anonymouslojz/EM-TF-SOM-AM5728/04-Connector/Dimension/SOM Dimension.dxf

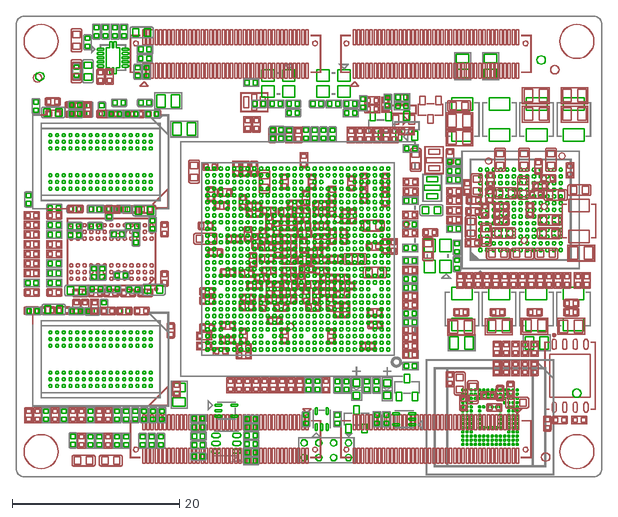
[picture p10: CAD file, 2024-05-24]
04-Connector/Dimension/SOM Dimension.dxf
70.0 x 55.0
