anonymouslojz/EM-TF-SOM-AM5728/(list of files, cad)

Other CAD files:
04-Connector/AM5728 BB.dxf
