anonymouslojz/EM-TF-SOM-AM5728/04-Connector/Dimension/SOM Dimension.pdf

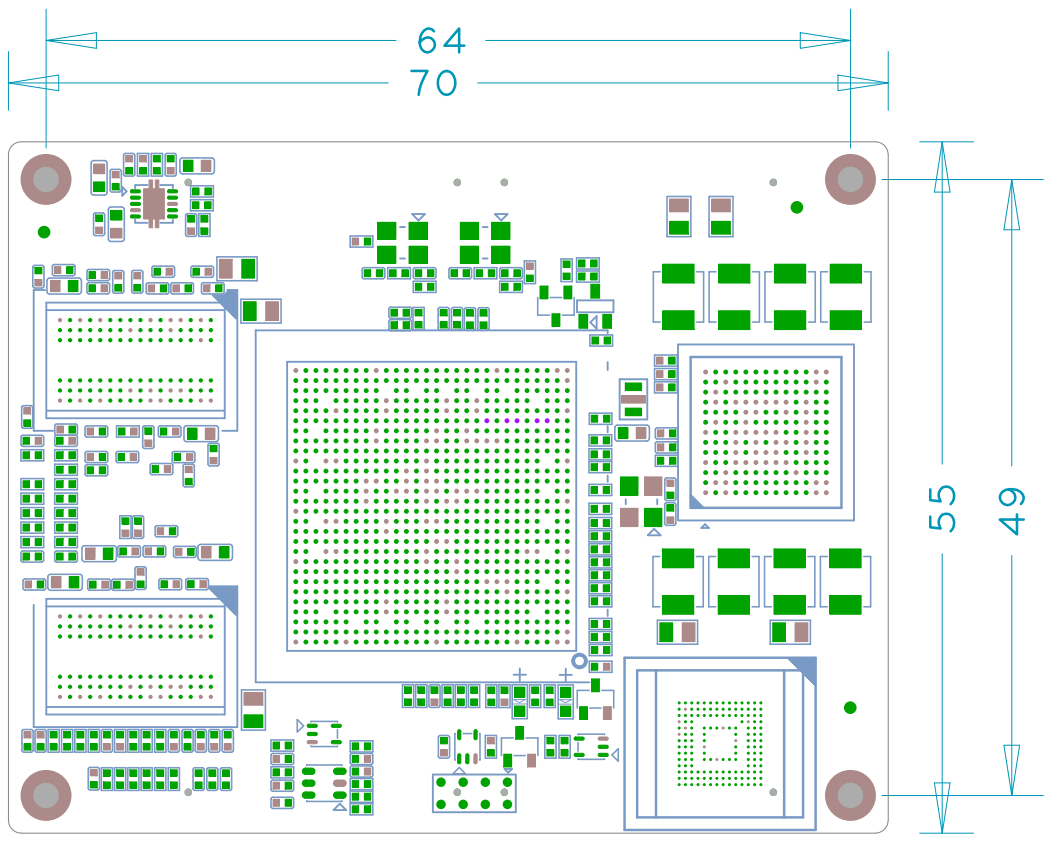
[picture p98: page 1]
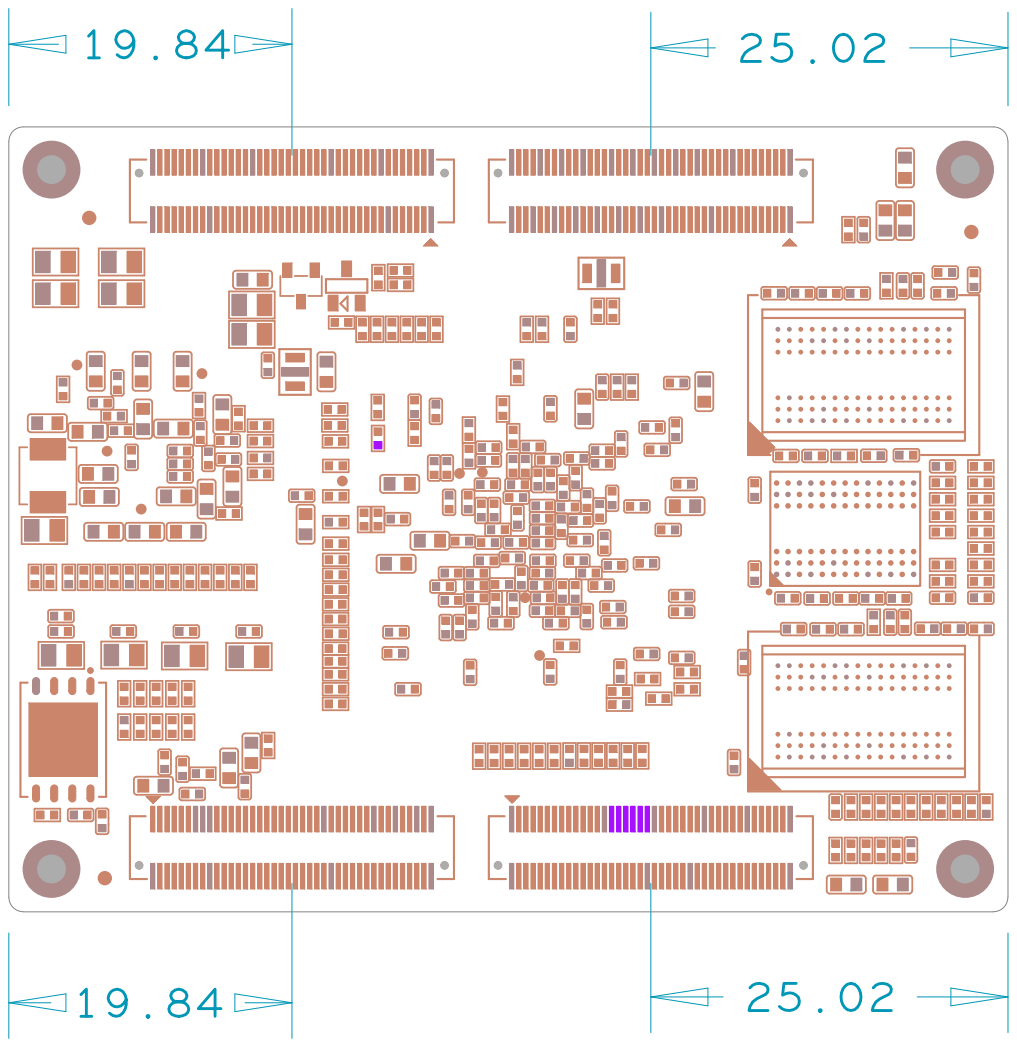
[picture p99: page 2]
