anonymouslojz/EM-TF-SOM-AM5728/03-Schematic/EM-TF-BB-AM5728_V11.pdf

# EM-TF-BB-AM5728_V1.1

# Revision History

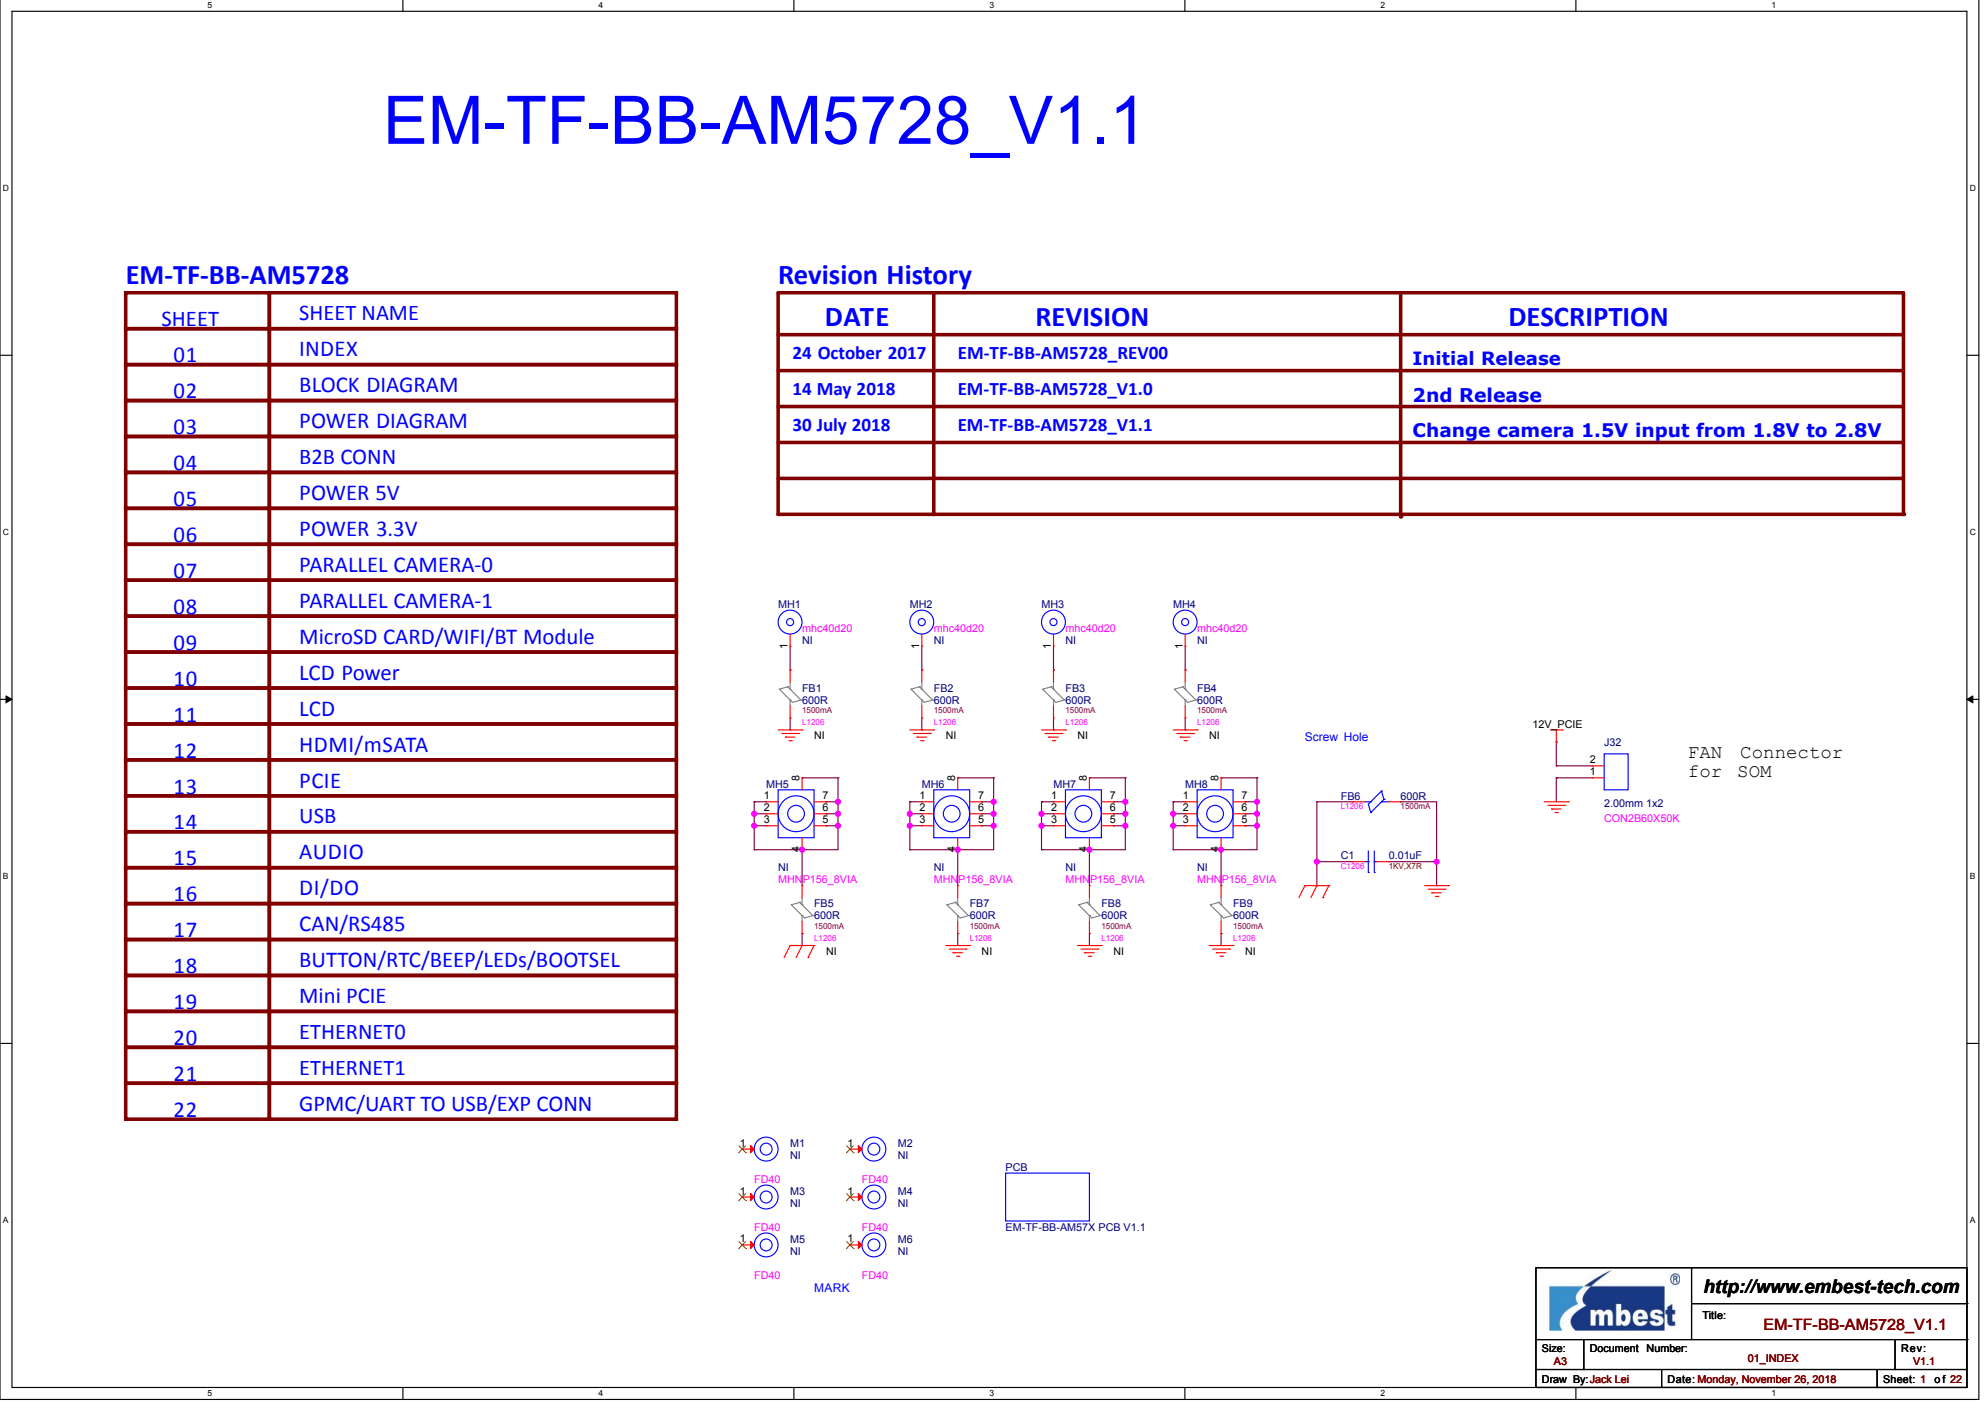
[picture p60: page 1]

DATE | REVISION | DESCRIPTION

24 October 2017 | EM-TF-BB-AM5728_REV00 | Initial Release
14 May 2018 | EM-TF-BB-AM5728_V1.0 | 2nd Release

30 July 2018 | EM-TF-BB-AM5728_V1.1 | Change camera 1.5V input from 1.8V to 2.8V

EM-TF-BB-AM57X PCB V1.1

http://www.embest-tech.com

# E M - T F -B B -A M 5 7 2 8 _ V 1 .0

# M M C 1

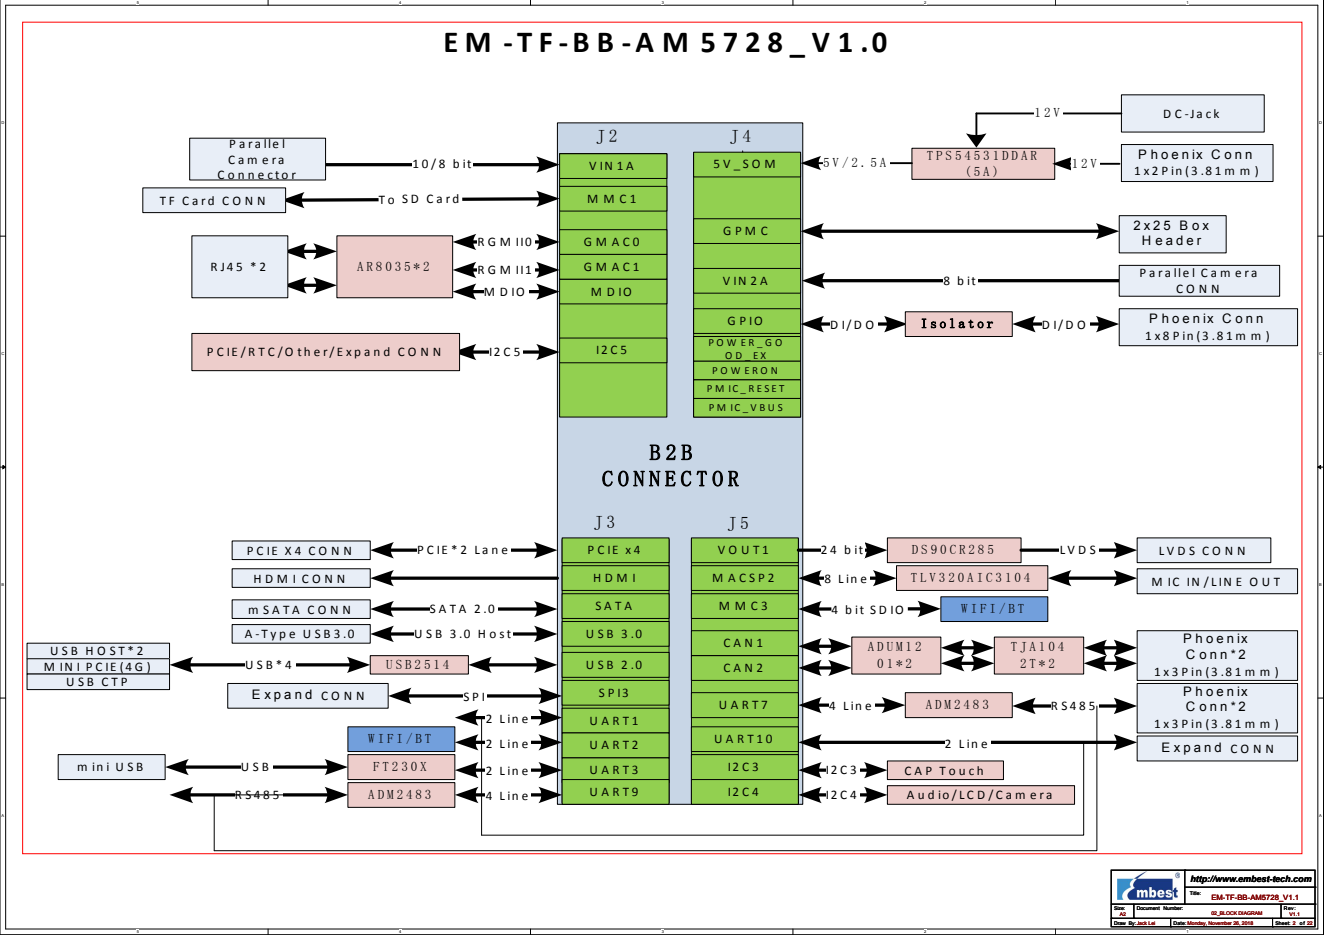
[picture p61: page 2]
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

http://www.embest-tech.com

# EM-TF-BB-AM5728_REV00

# 5V_SOM DCDC(TPS54531)

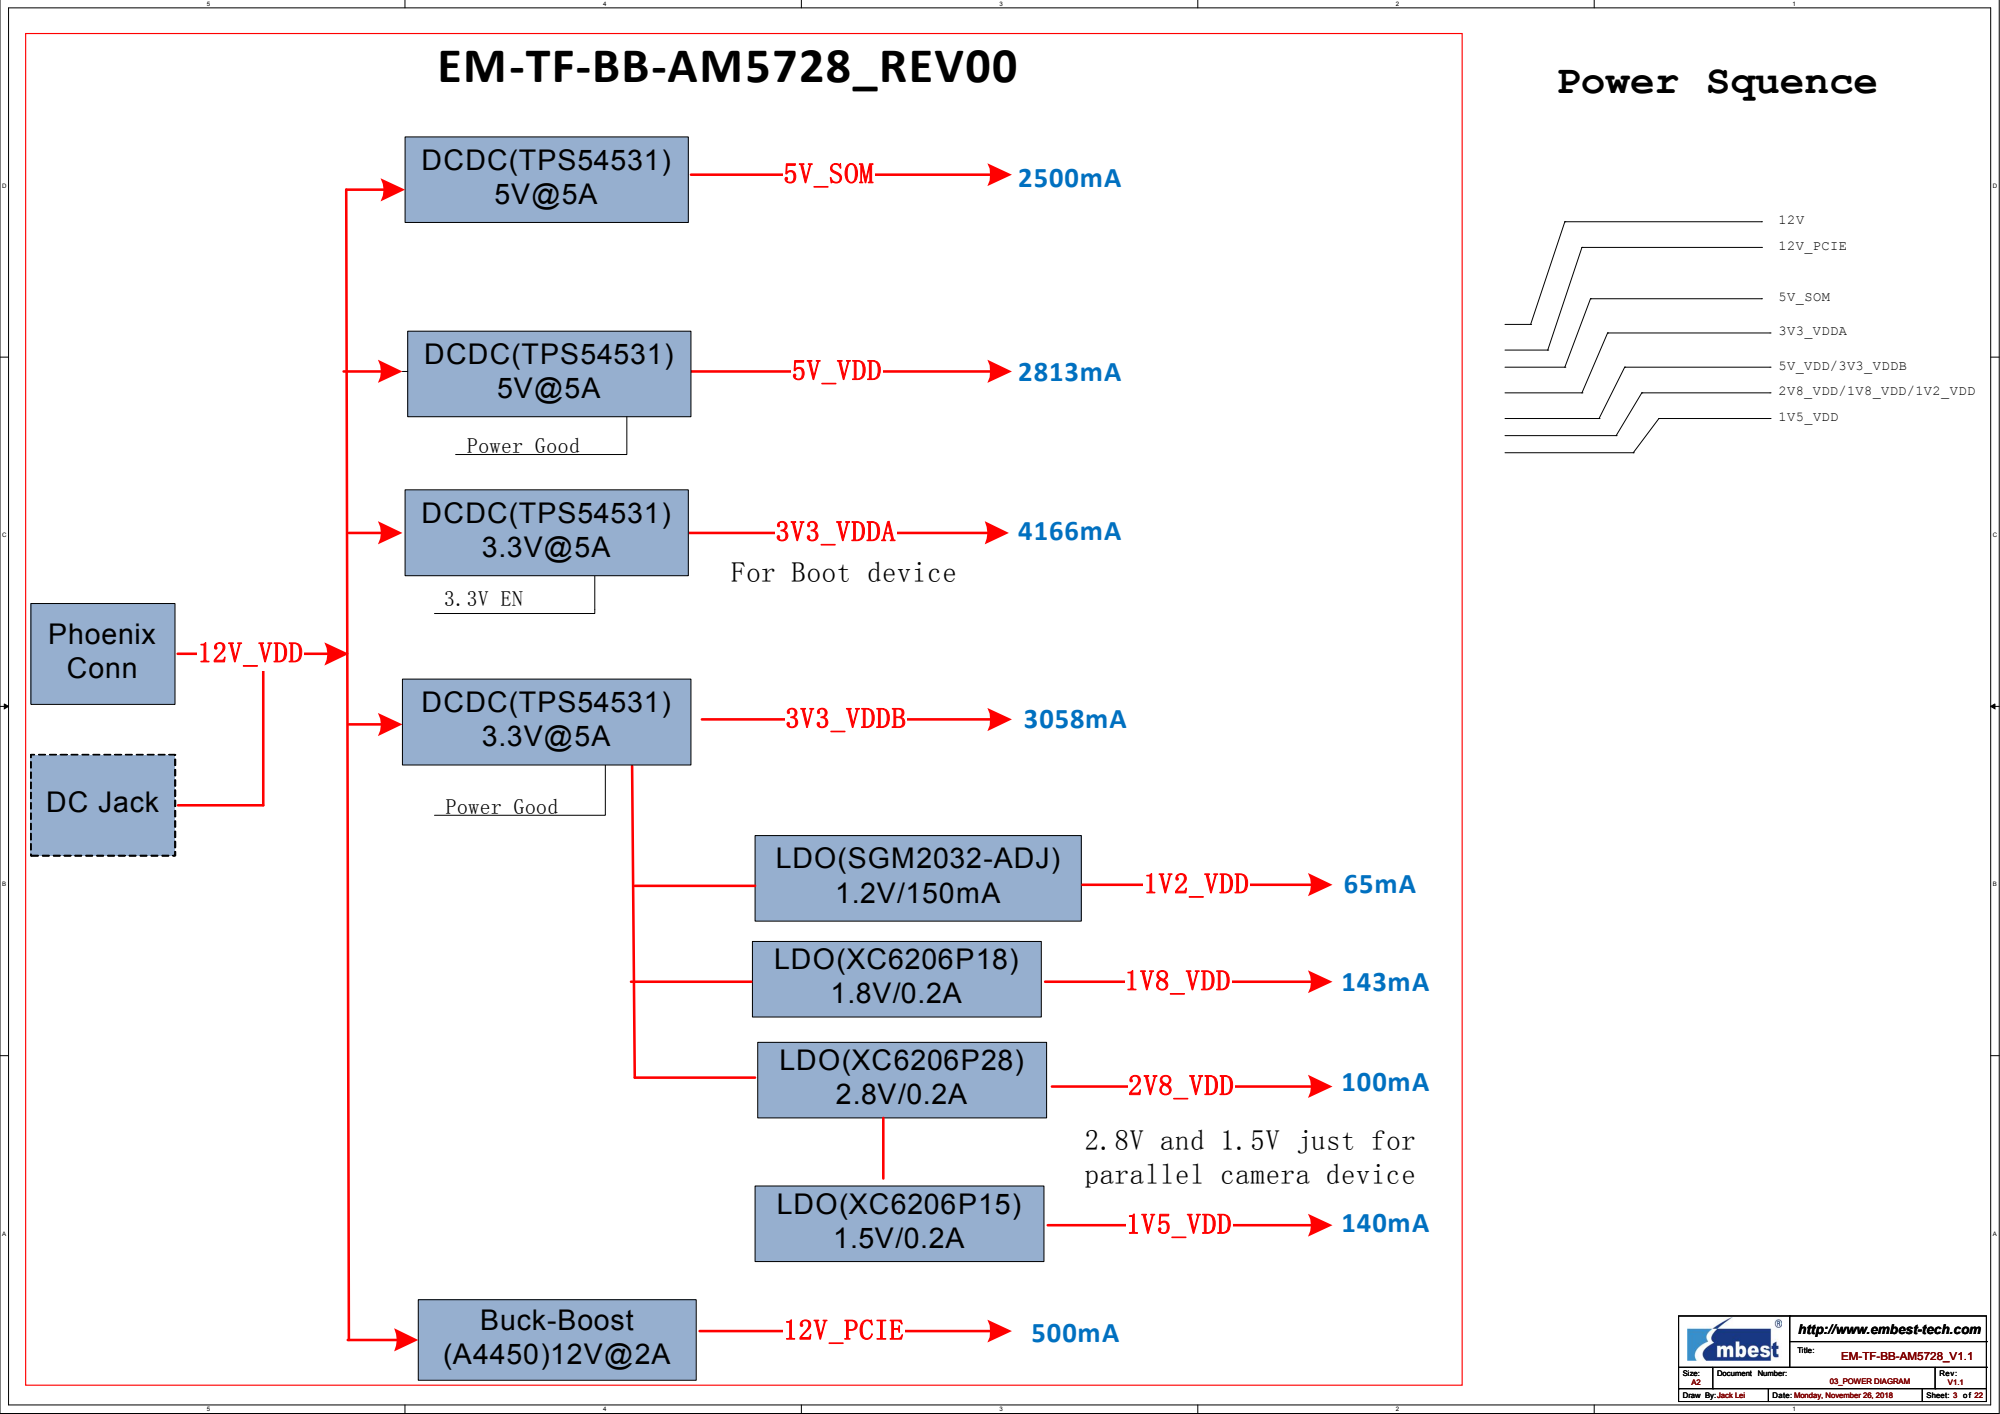
[picture p62: page 3]
Phoenix Conn; LDO(SGM2032-ADJ) 1.2V/150mA; 12V_PCIE; DC Jack; LDO(XC6206P15) 1.5V/0.2A; Power Good; 3V3_VDDB; Buck-Boost (A4450)12V@2A; DCDC(TPS54531) 3.3V@5A; LDO(XC6206P18) 1.8V/0.2A; 5V_VDD DCDC(TPS54531) 5V@5A; 12V_VDD; 1V2_VDD; LDO(XC6206P28) 2.8V/0.2A; 1V8_VDD; 2V8_VDD; Power Squence; 5V_SOM; 3V3_VDDA; 5V_VDD/3V3_VDDB; 2V8_VDD/1V8_VDD/1V2_VDD; 1V5_VDD; 03_POWER DIAGRAM; Jack Lei; Monday, November 26, 2018

3V3_VDDA
For Boot device

2.8V and 1.5V just for
parallel camera device
1V5_VDD

http://www.embest-tech.com

# B2B CONN

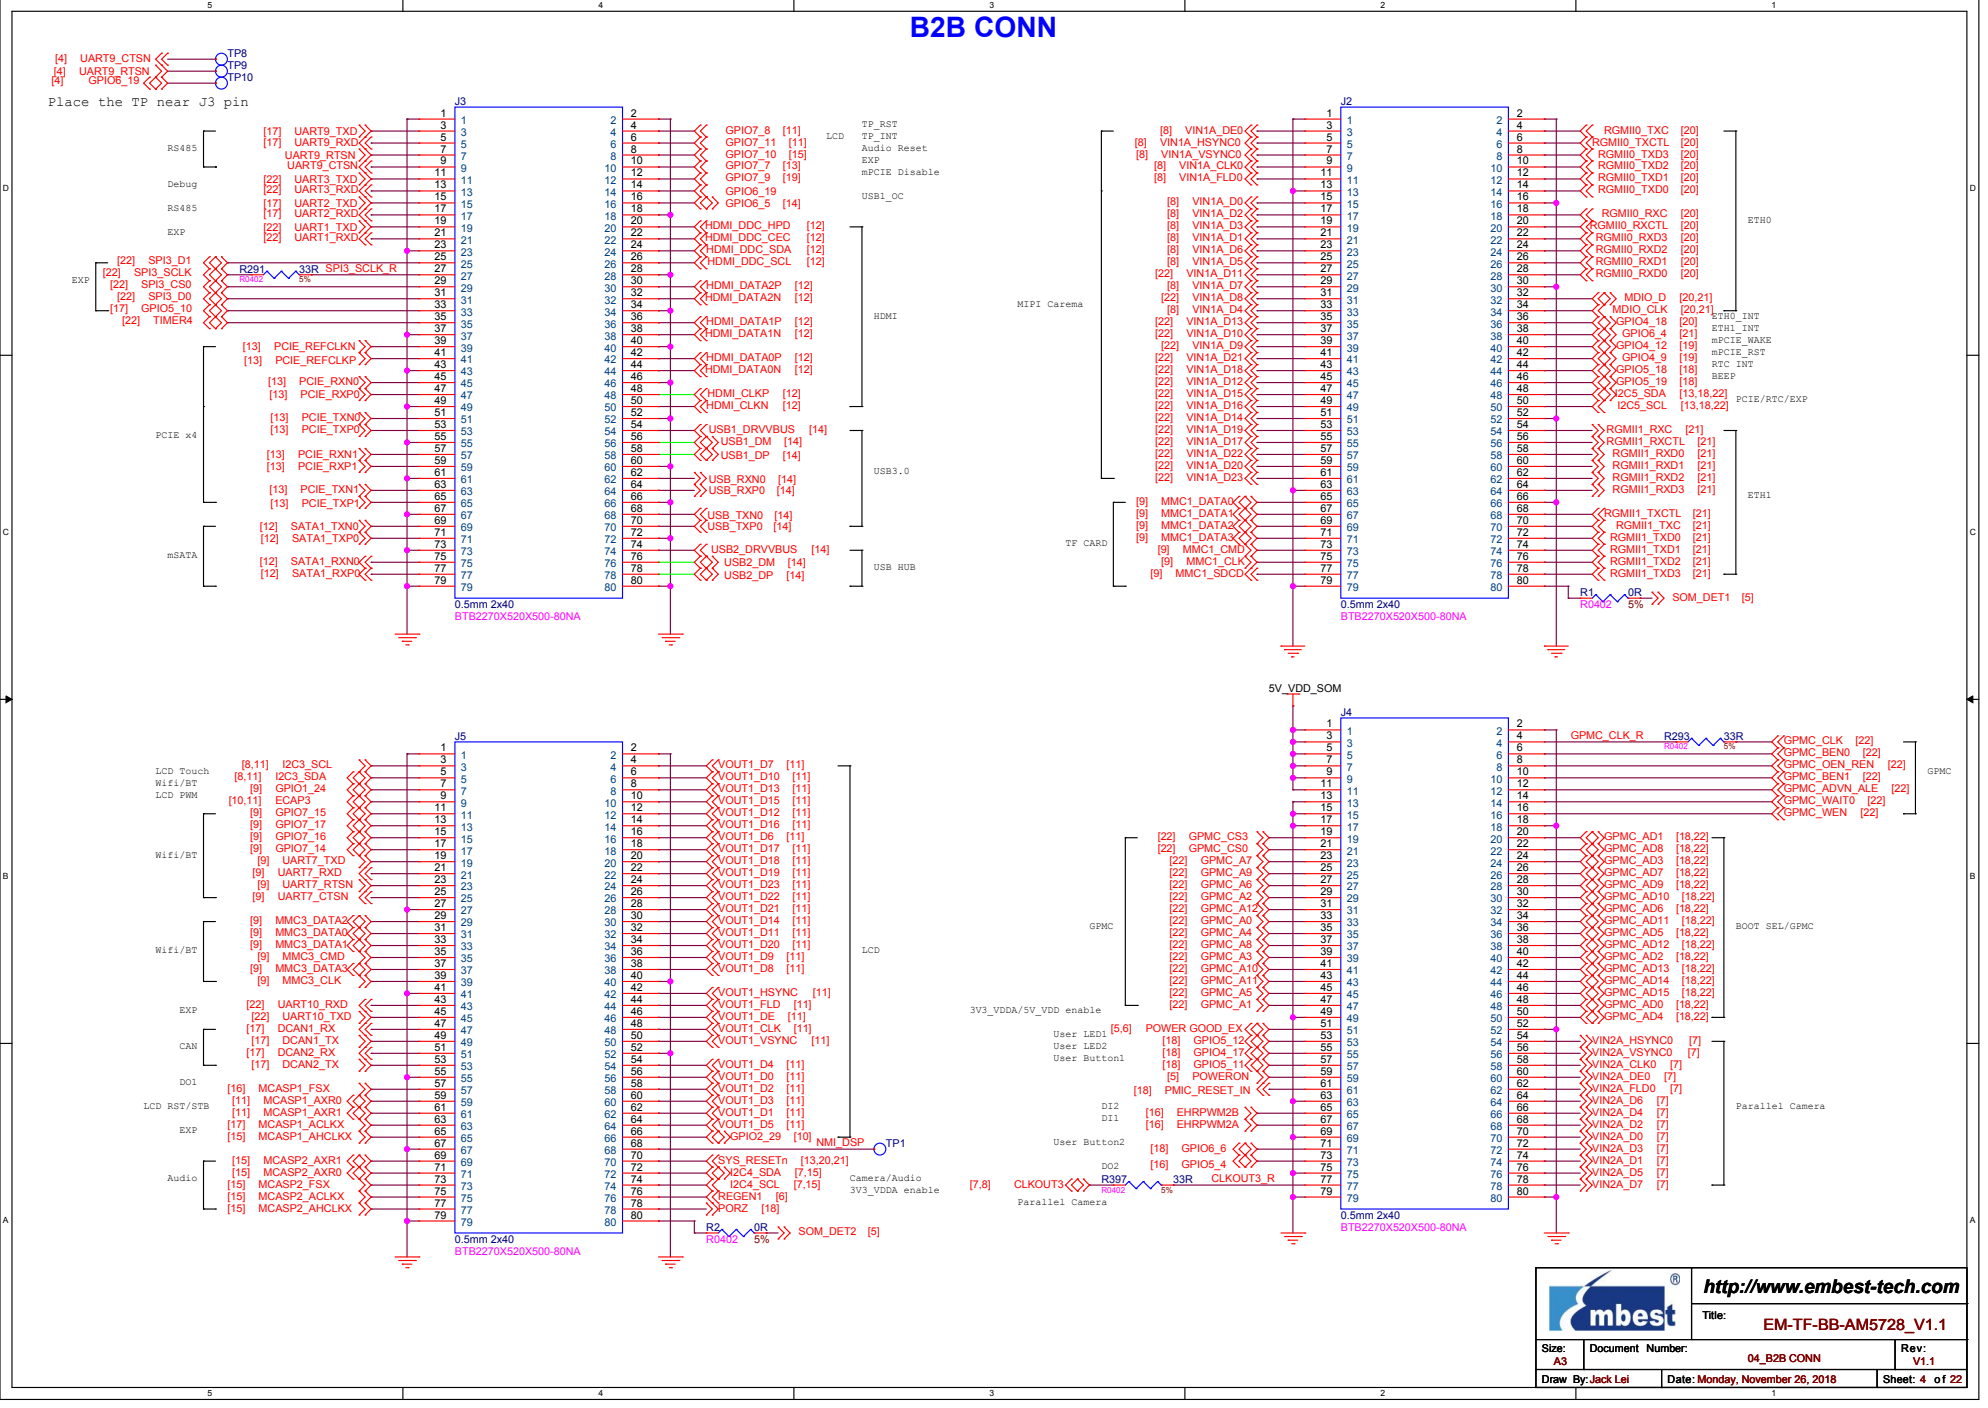
[picture p63: page 4]

Place the TP near J3 pin

http://www.embest-tech.com

# MAX： 2.5A

## Input: 7~28V

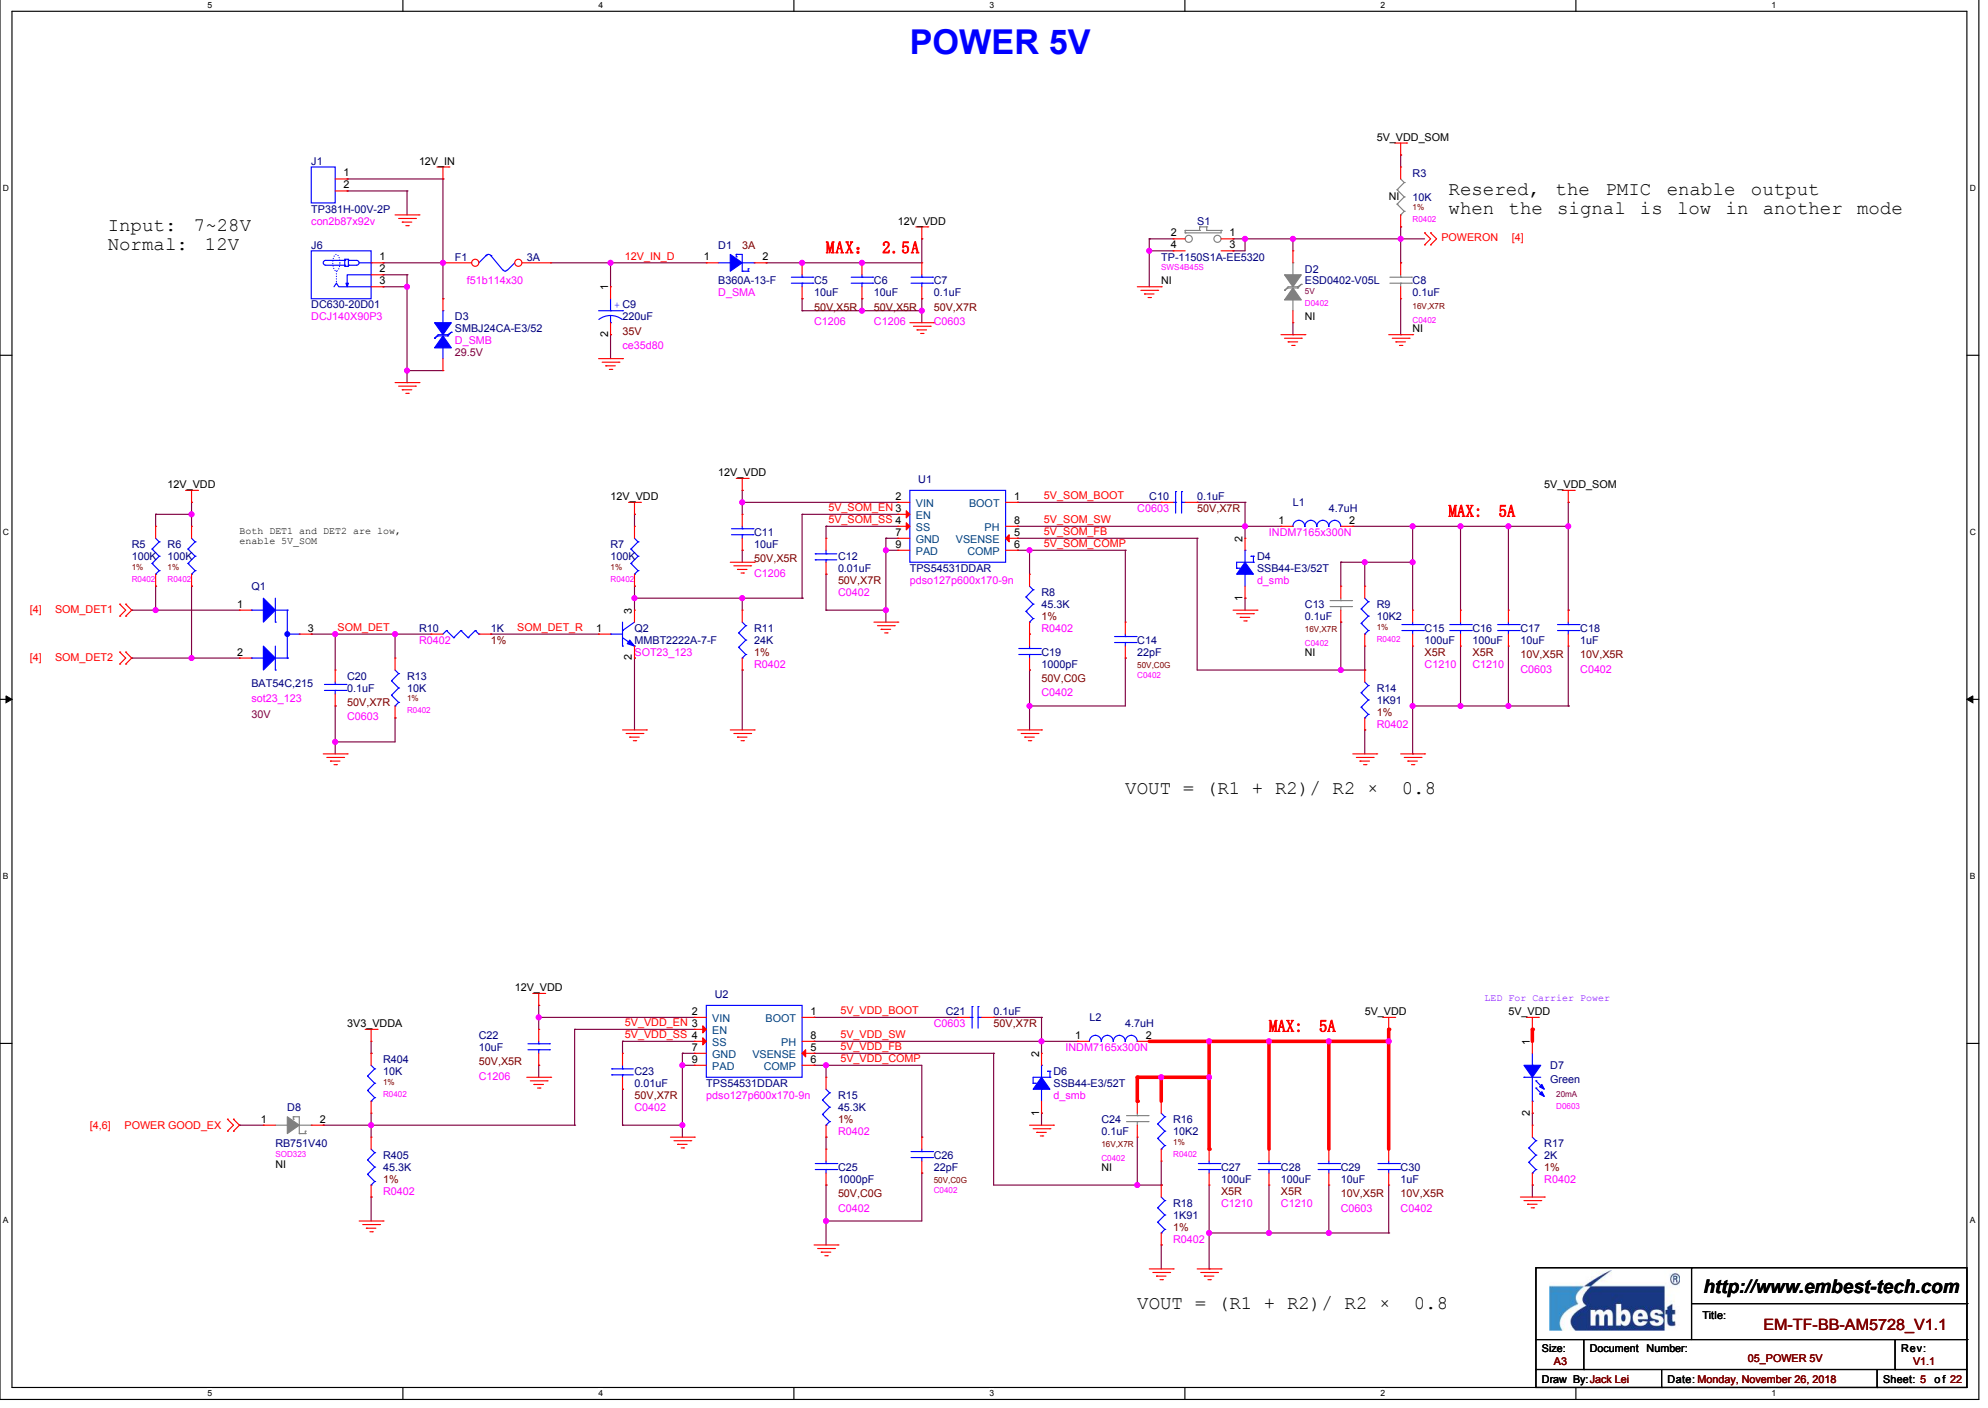
[picture p64: page 5]

Resered, the PMIC enable output
when the signal is low in another mode

Both DET1 and DET2 are low,
enable 5V_SOM

LED For Carrier Power
5V_VDD

http://www.embest-tech.com

# MAX: 5A

## VOUT = (R1 + R2)/ R2 × 0.8

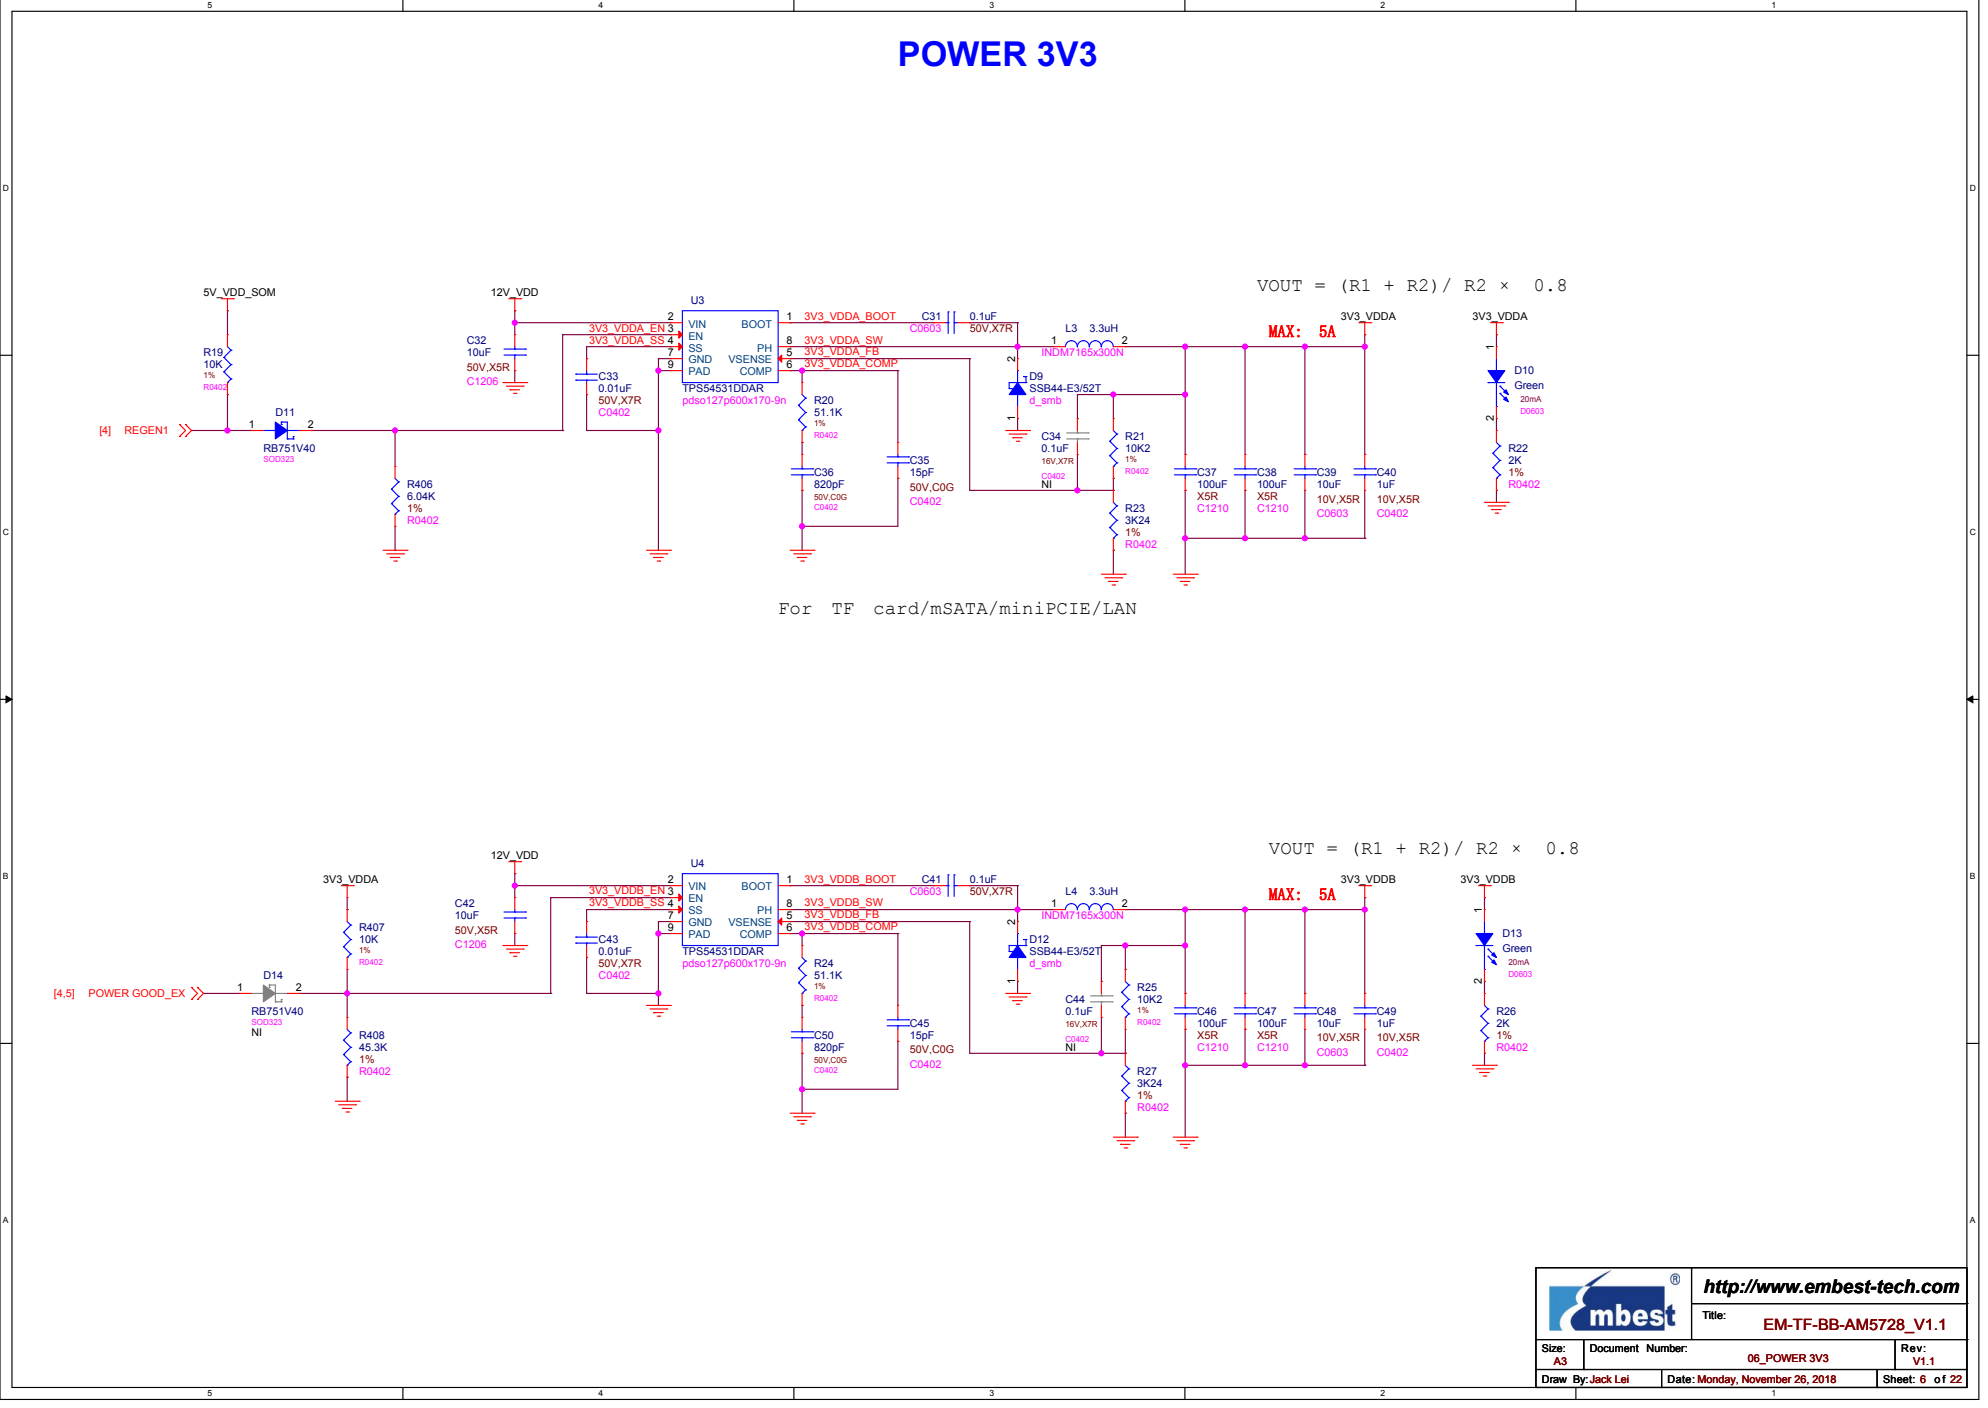
[picture p65: page 6]

http://www.embest-tech.com

# Parallel Camera-0

2.8V

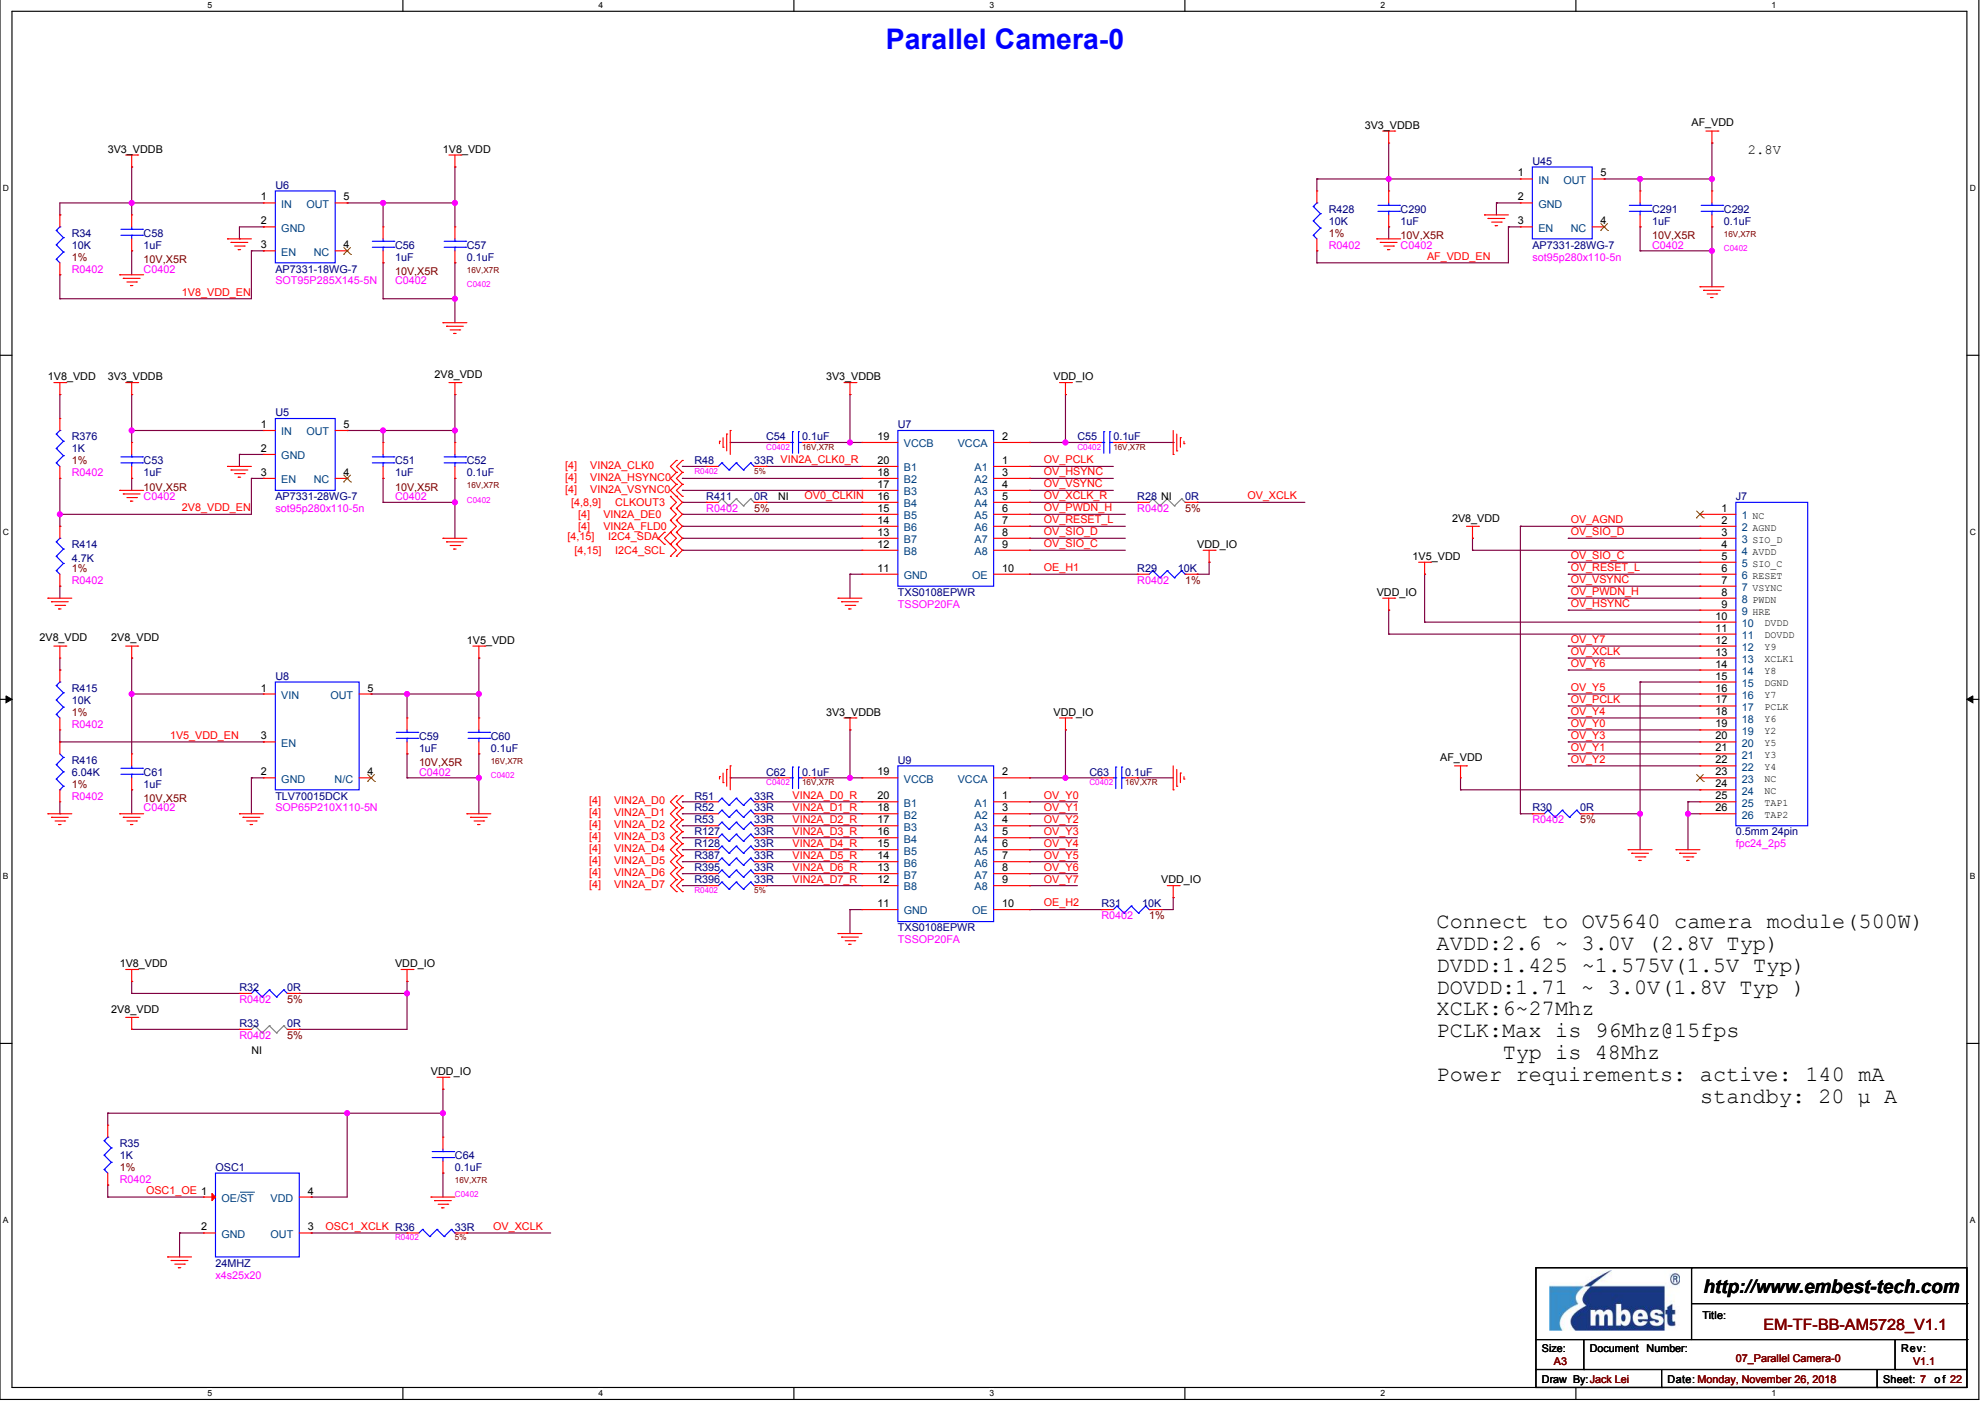
[picture p66: page 7]

Connect to OV5640 camera module(500W)
AVDD:2.6 ~ 3.0V (2.8V Typ)
DVDD:1.425 ~1.575V(1.5V Typ)
DOVDD:1.71 ~ 3.0V(1.8V Typ )
XCLK:6~27Mhz
PCLK:Max is 96Mhz@15fps

Power requirements: active: 140 mA

http://www.embest-tech.com

# Parallel Camera-1

2.8V

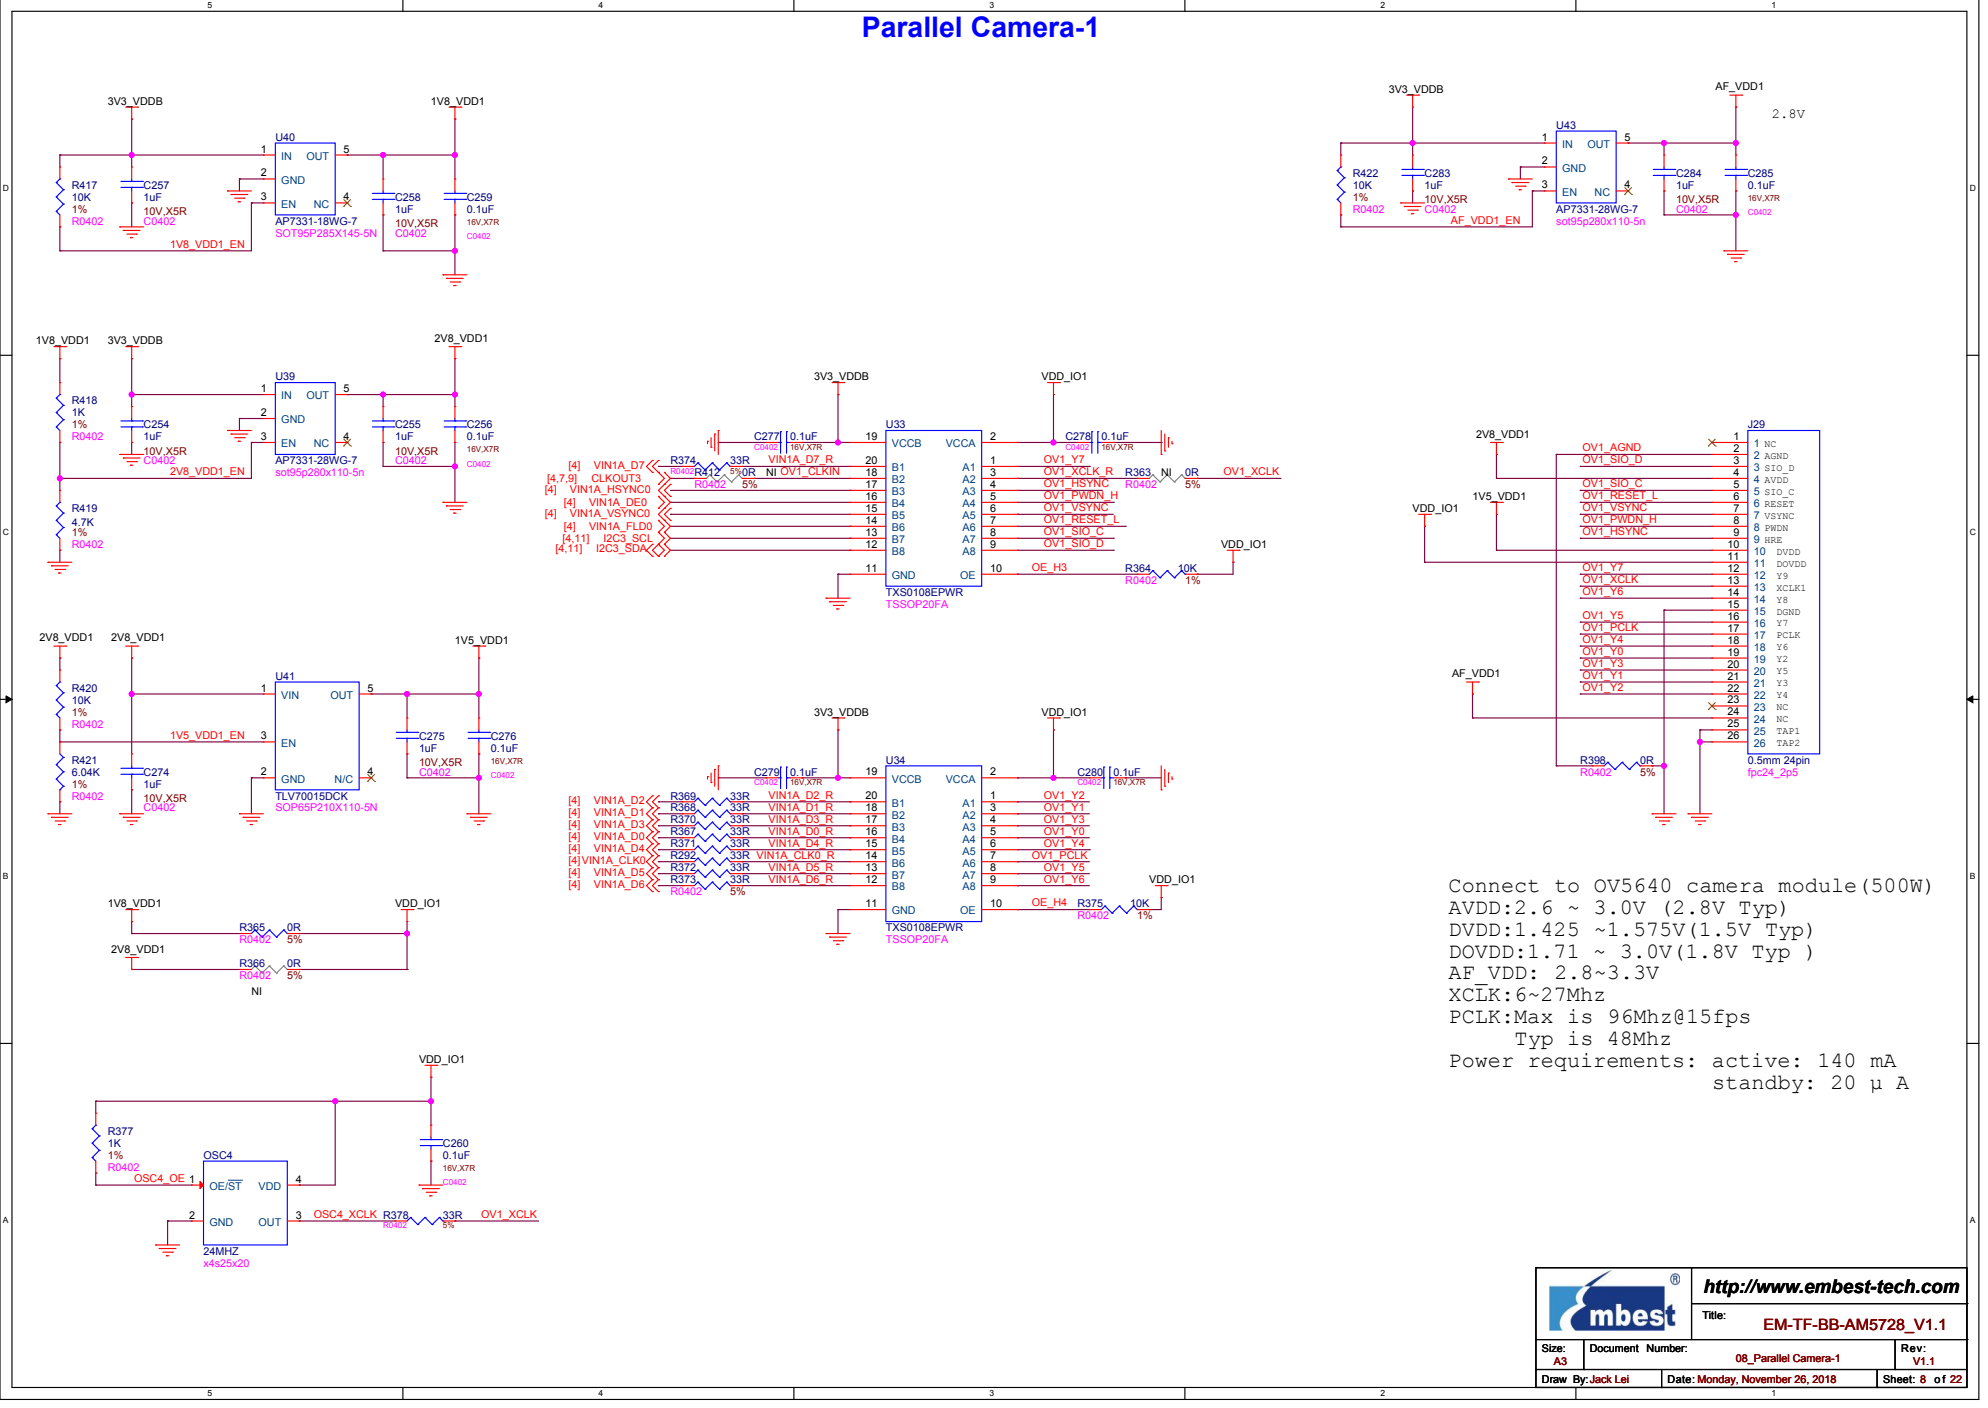
[picture p67: page 8]

Connect to OV5640 camera module(500W)
AVDD:2.6 ~ 3.0V (2.8V Typ)
DVDD:1.425 ~1.575V(1.5V Typ)
DOVDD:1.71 ~ 3.0V(1.8V Typ )
AF_VDD: 2.8~3.3V
XCLK:6~27Mhz
PCLK:Max is 96Mhz@15fps

Power requirements: active: 140 mA

http://www.embest-tech.com

# MicroSD CARD/WIFI/BT Module

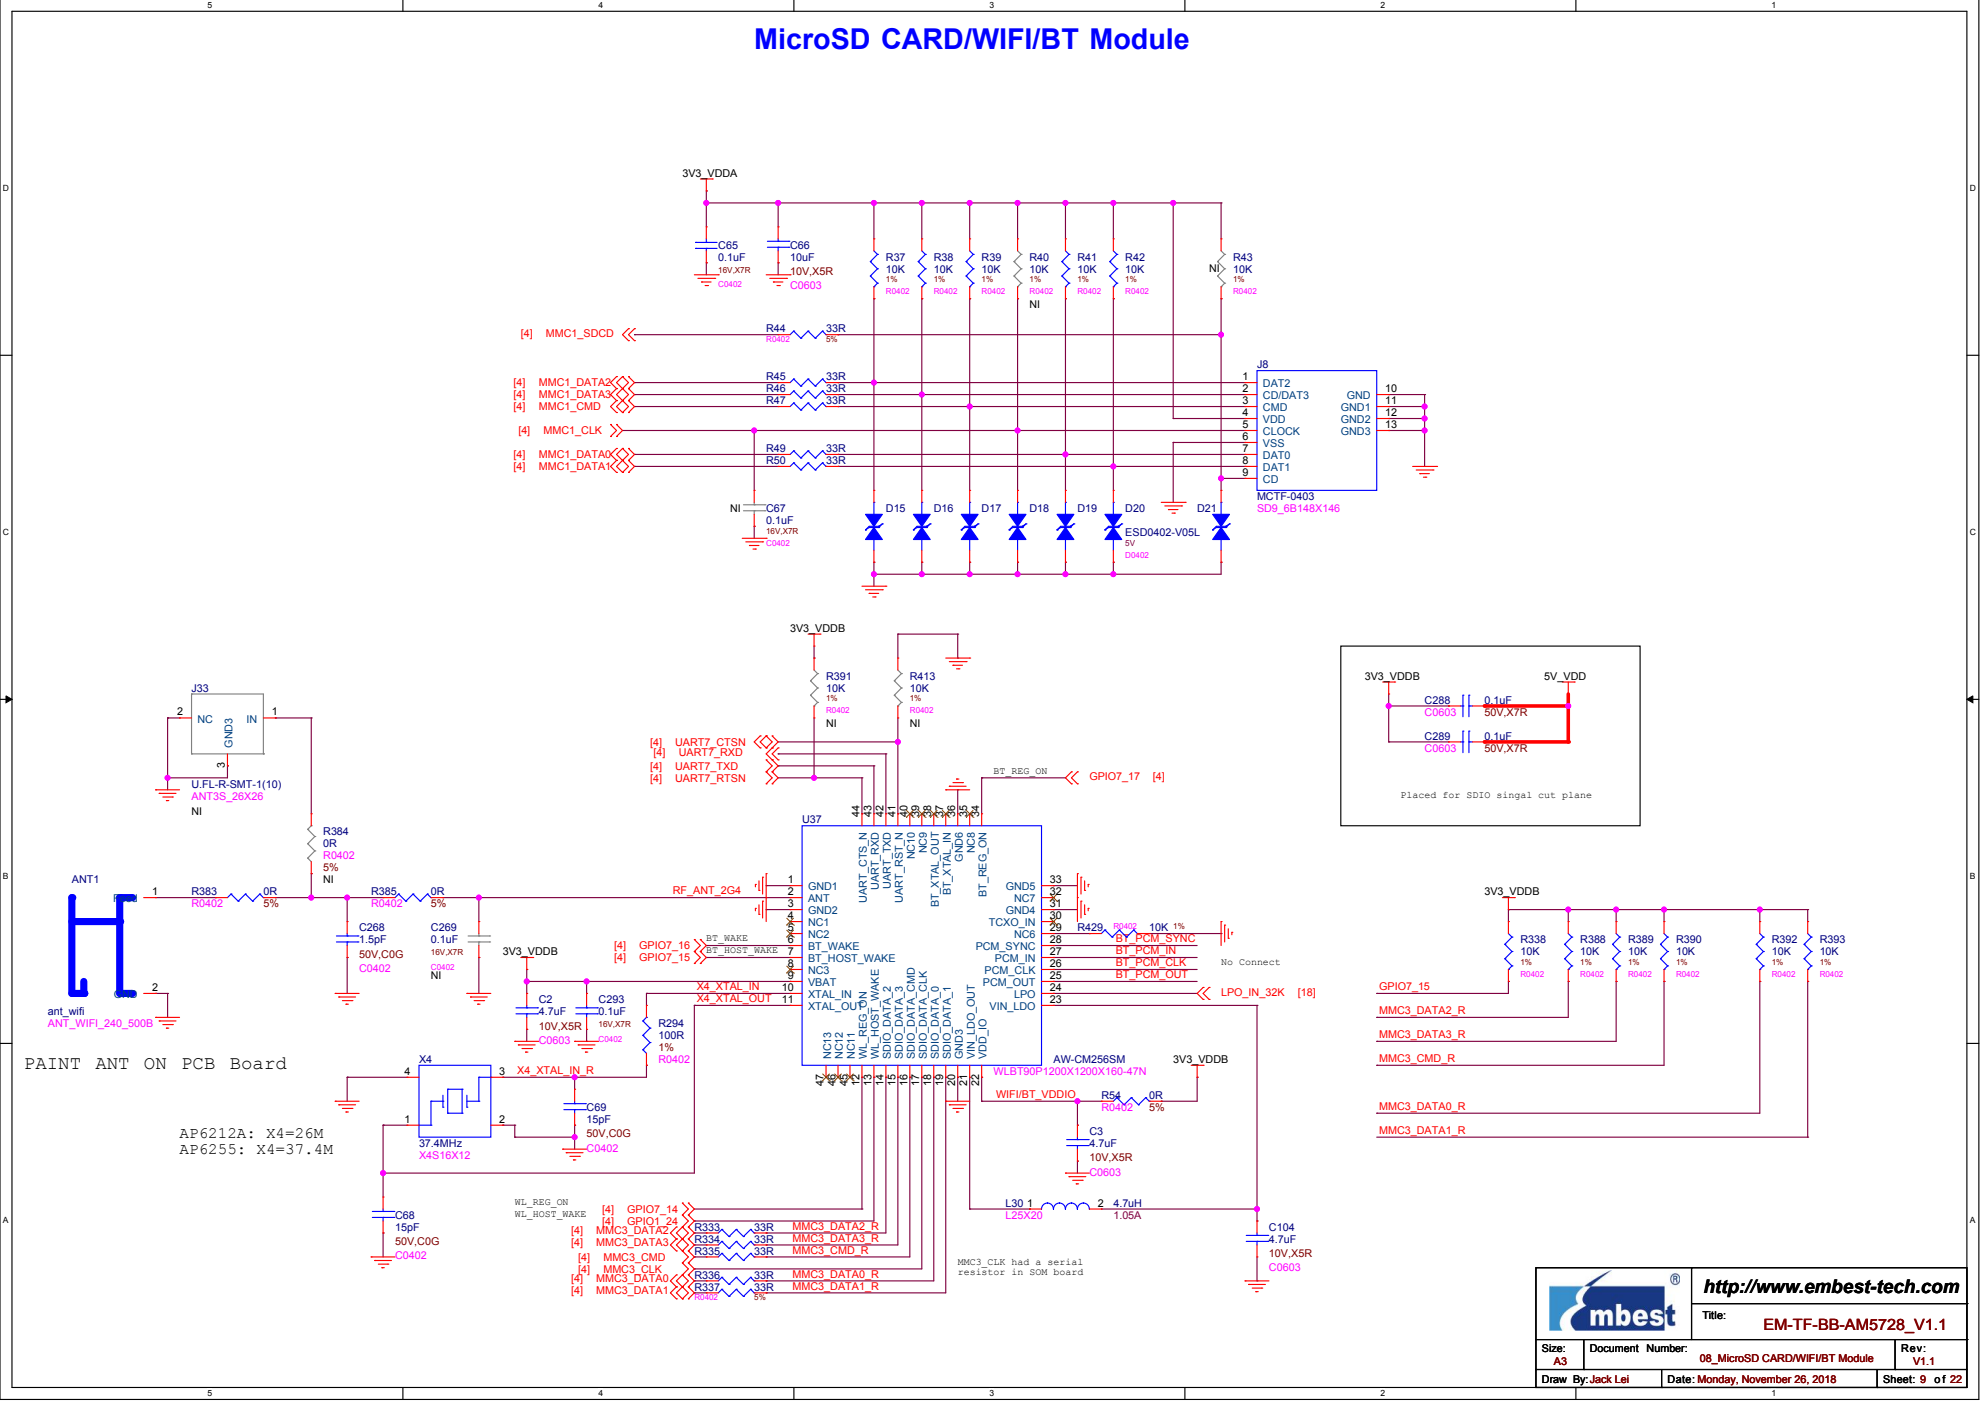
[picture p68: page 9]

Placed for SDIO singal cut plane

PAINT ANT ON PCB Board

MMC3_CLK had a serial
resistor in SOM board

http://www.embest-tech.com

# LVDS POWER

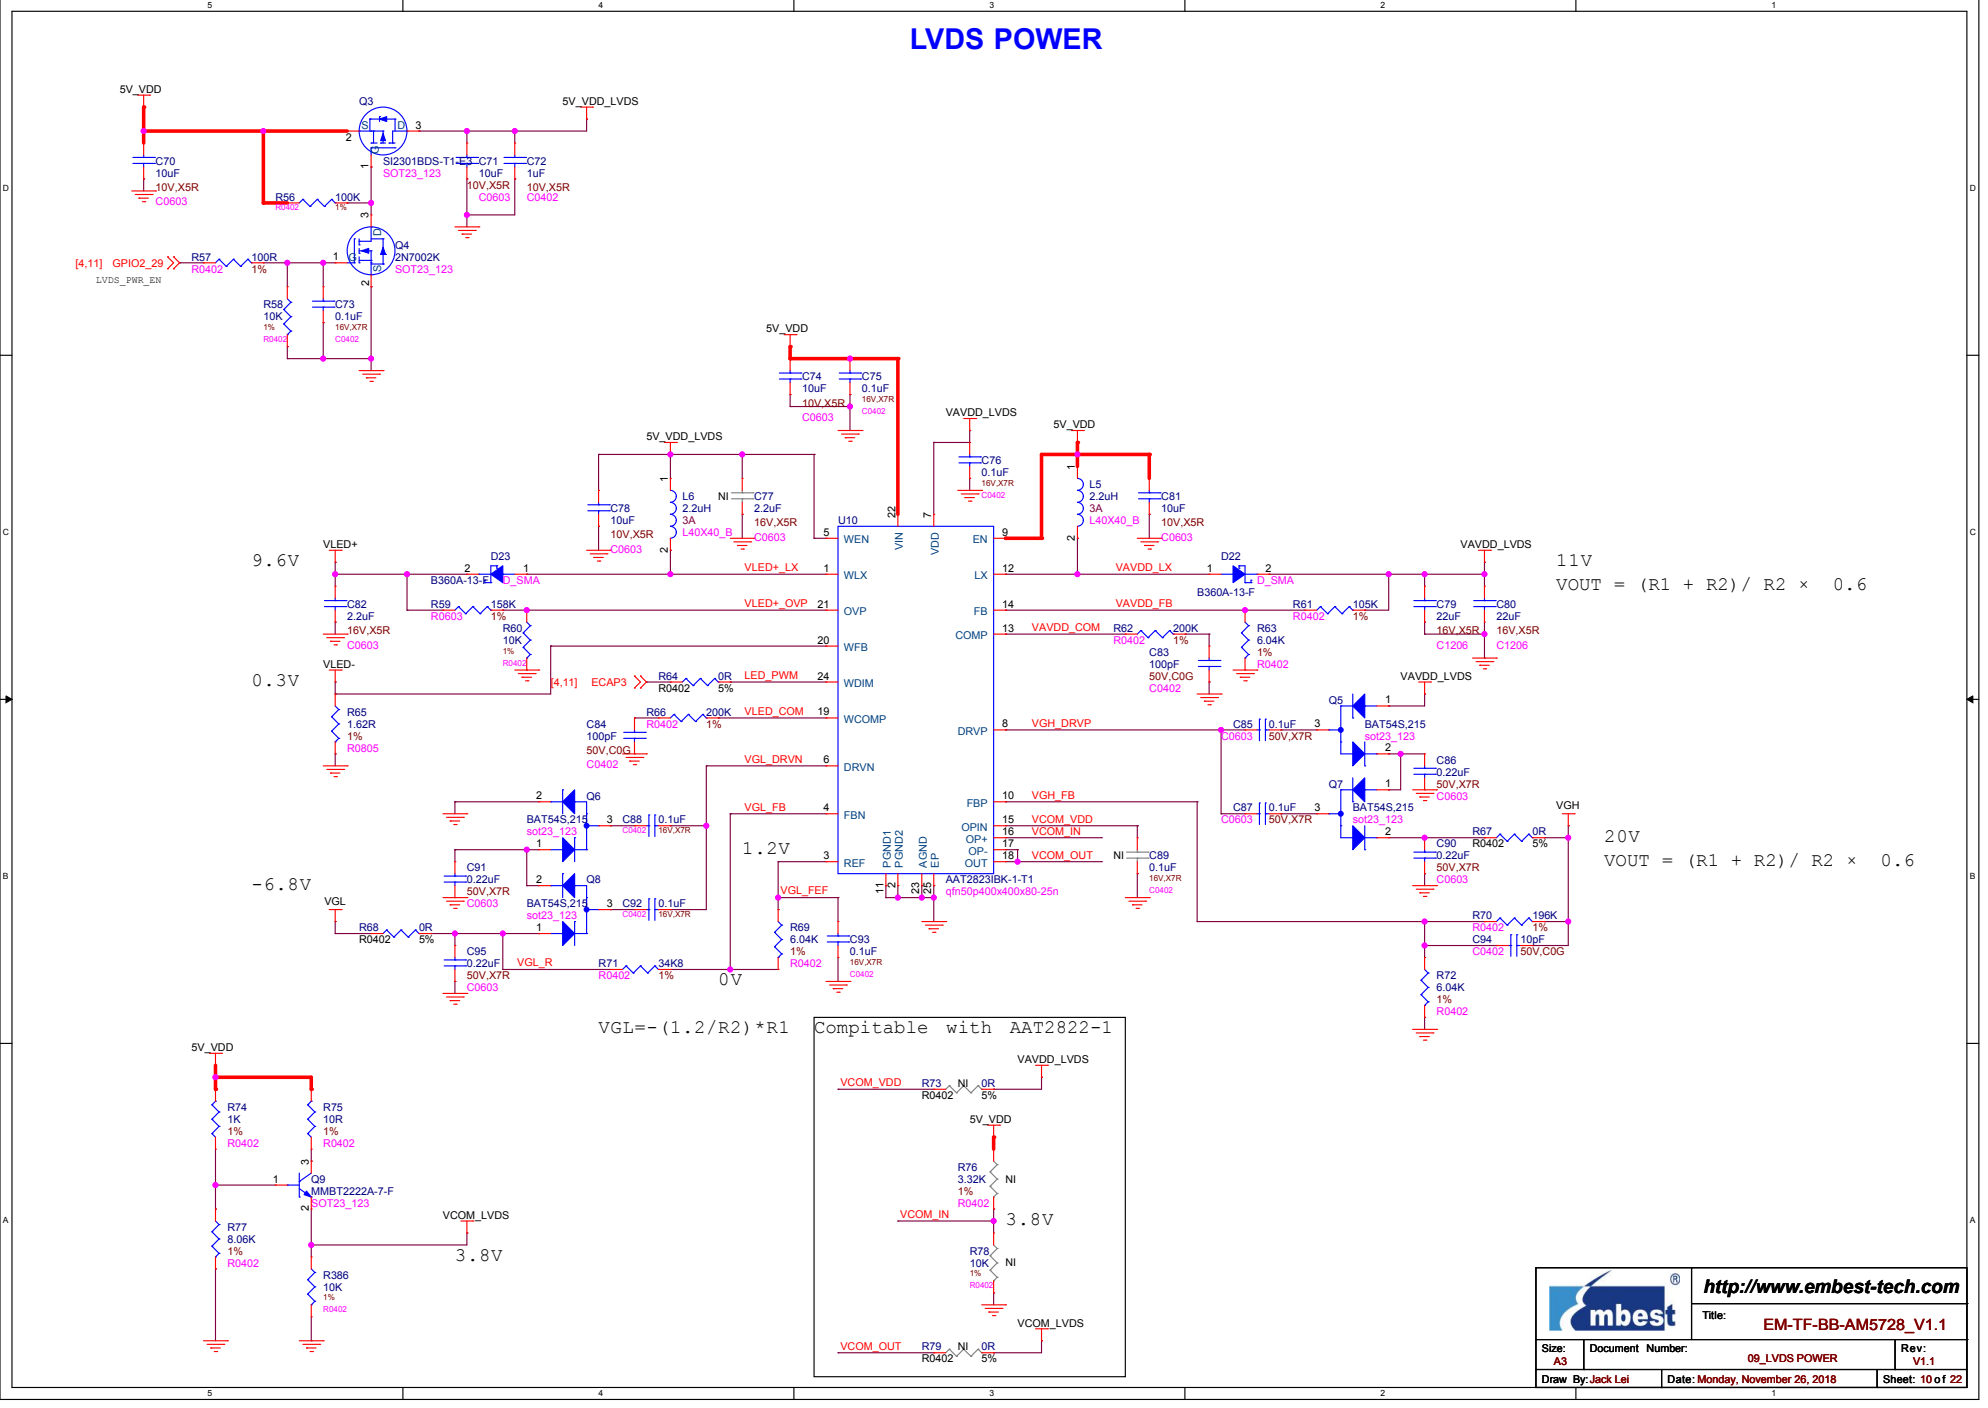
[picture p69: page 10]

http://www.embest-tech.com

# LCD

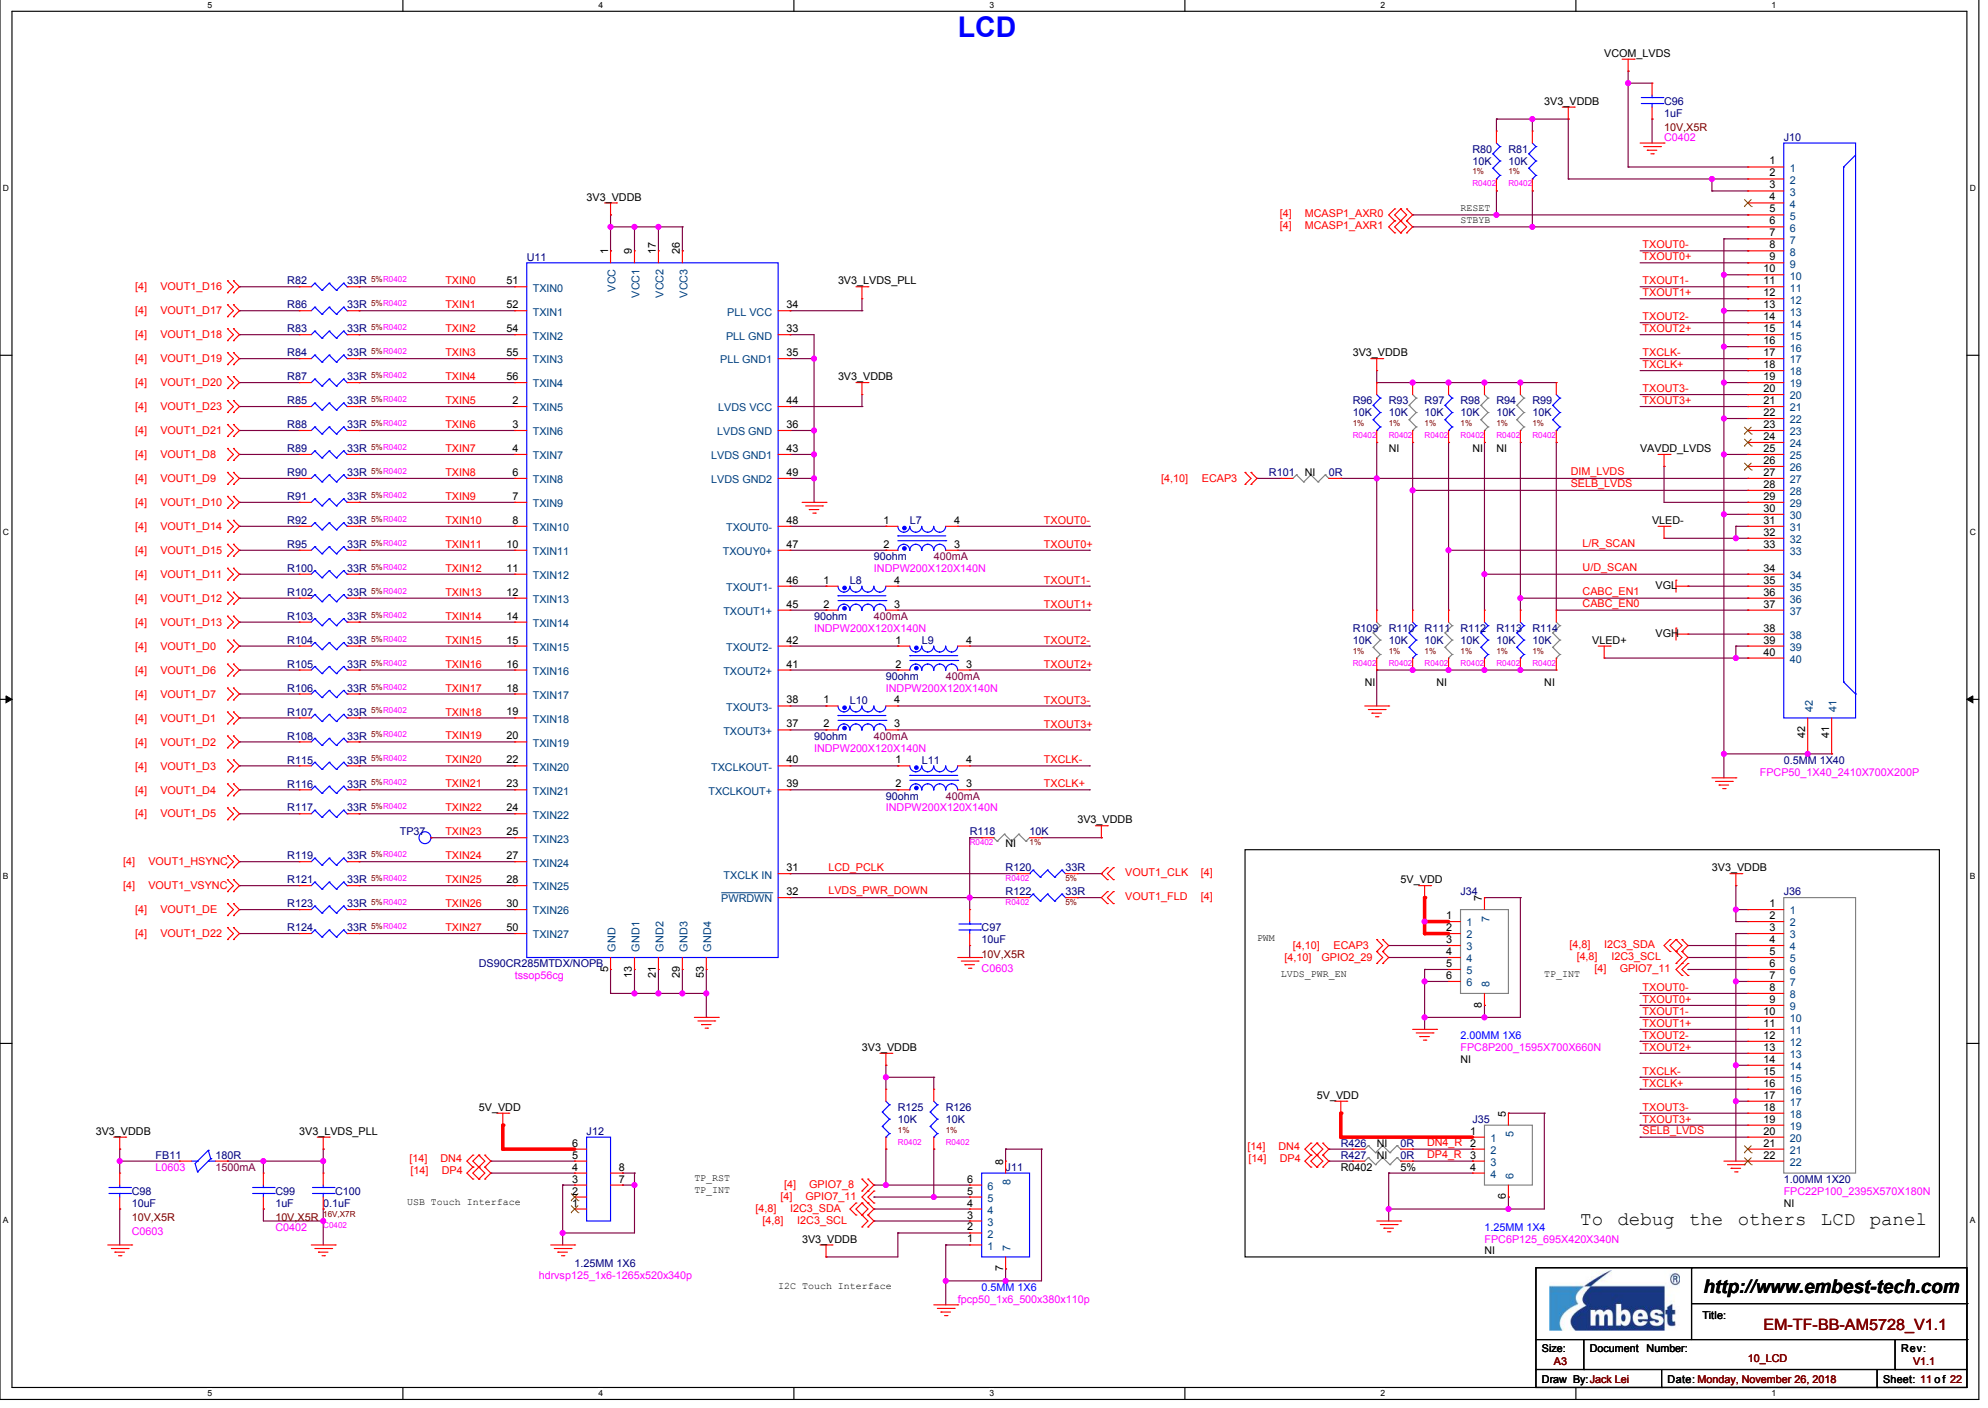
[picture p70: page 11]

To debug the others LCD panel

http://www.embest-tech.com

# HDMI

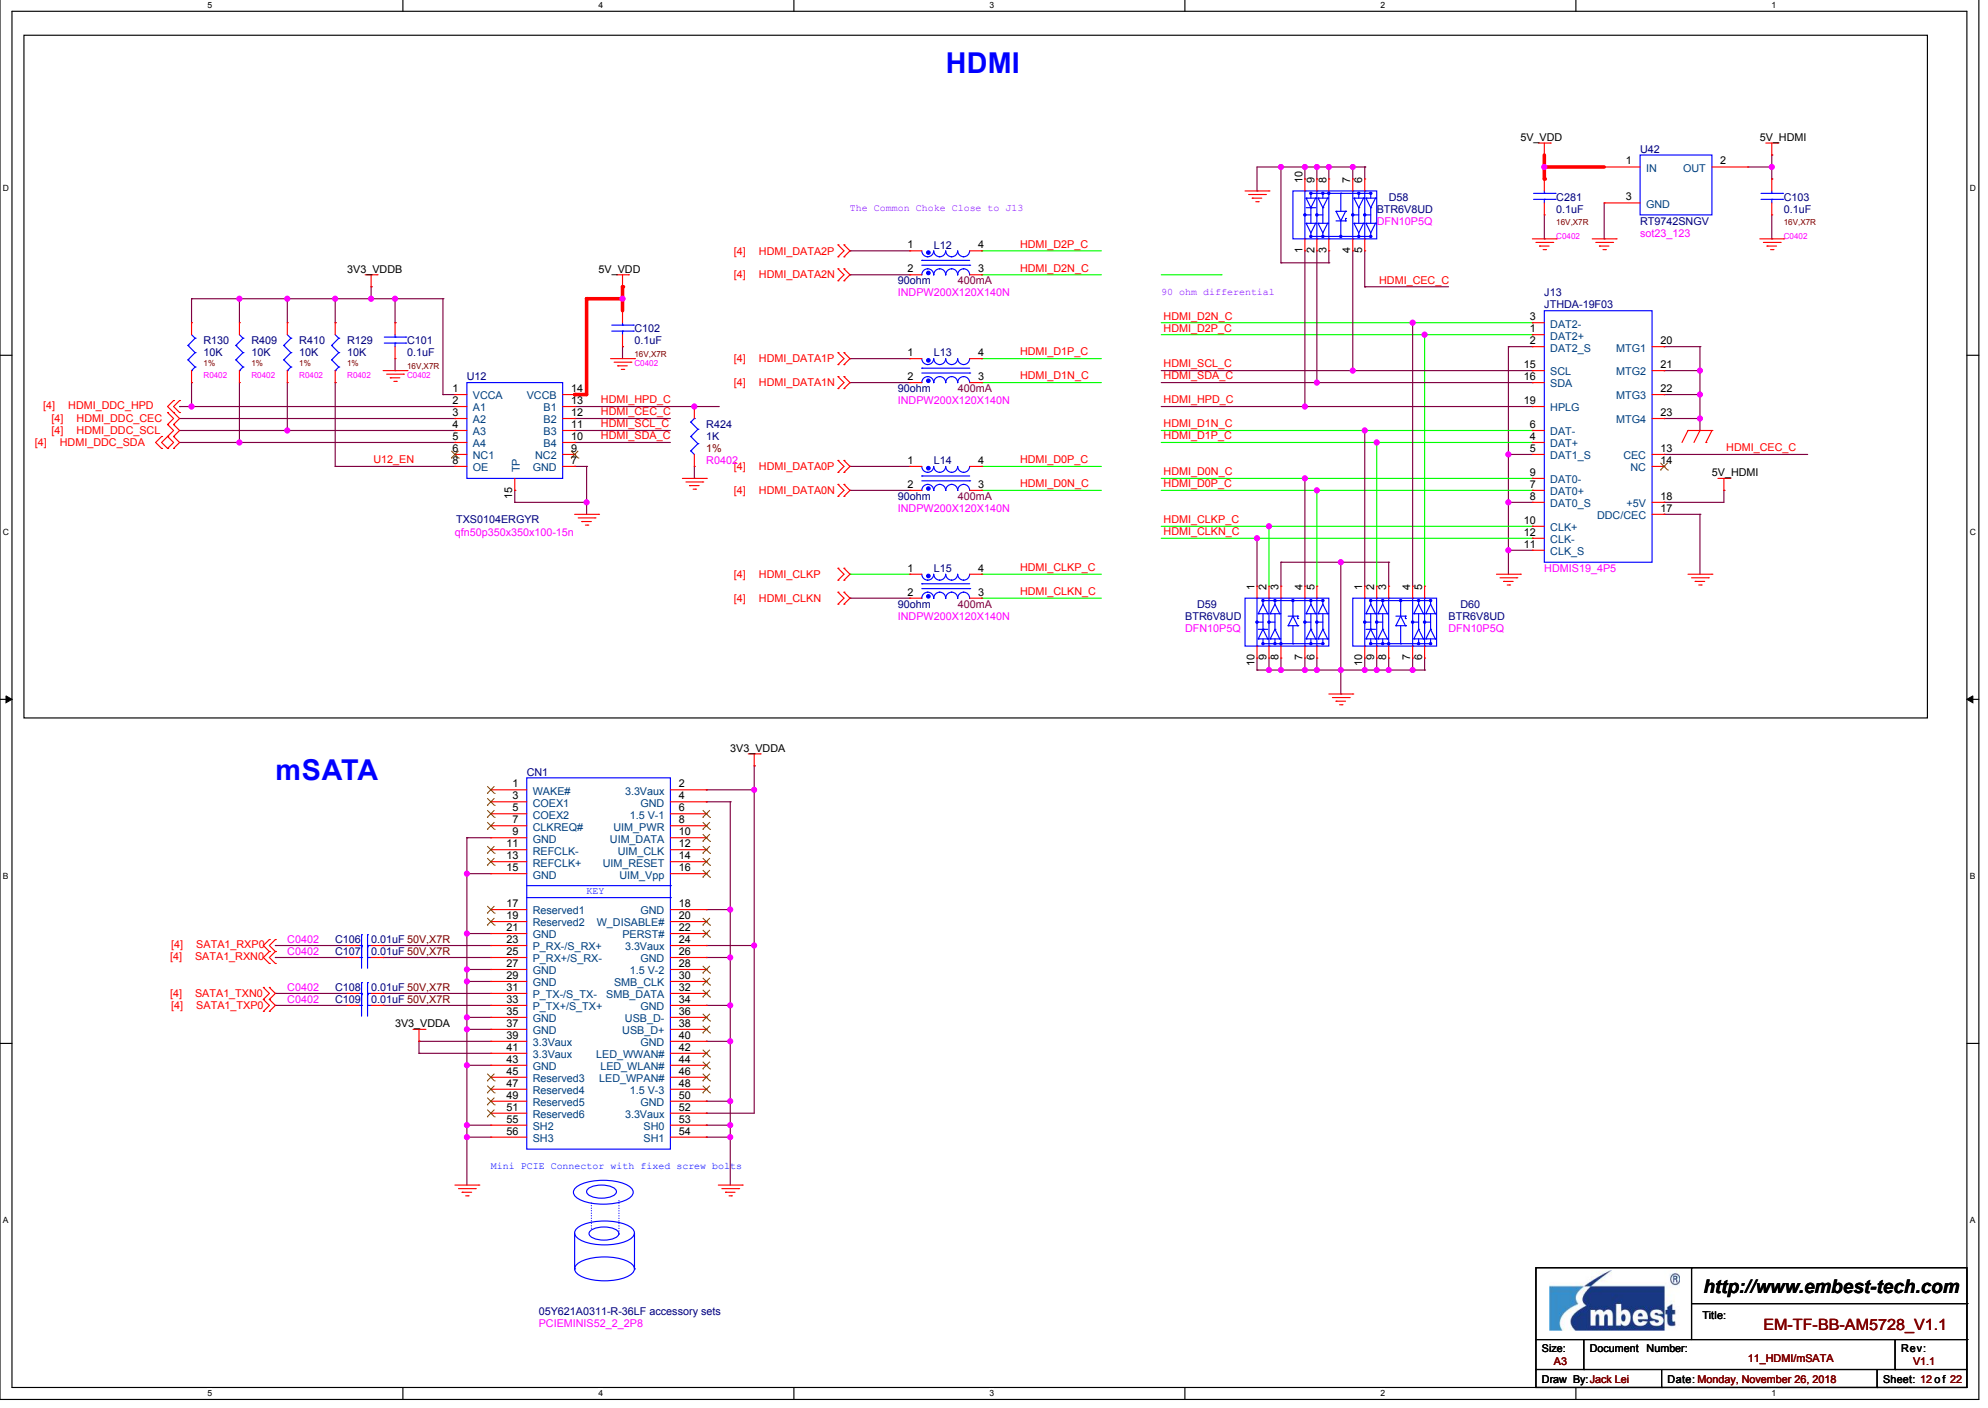
[picture p71: page 12]

The Common Choke Close to J13

Mini PCIE Connector with fixed screw bolts

http://www.embest-tech.com

# PCI Express x4 Edge Connector

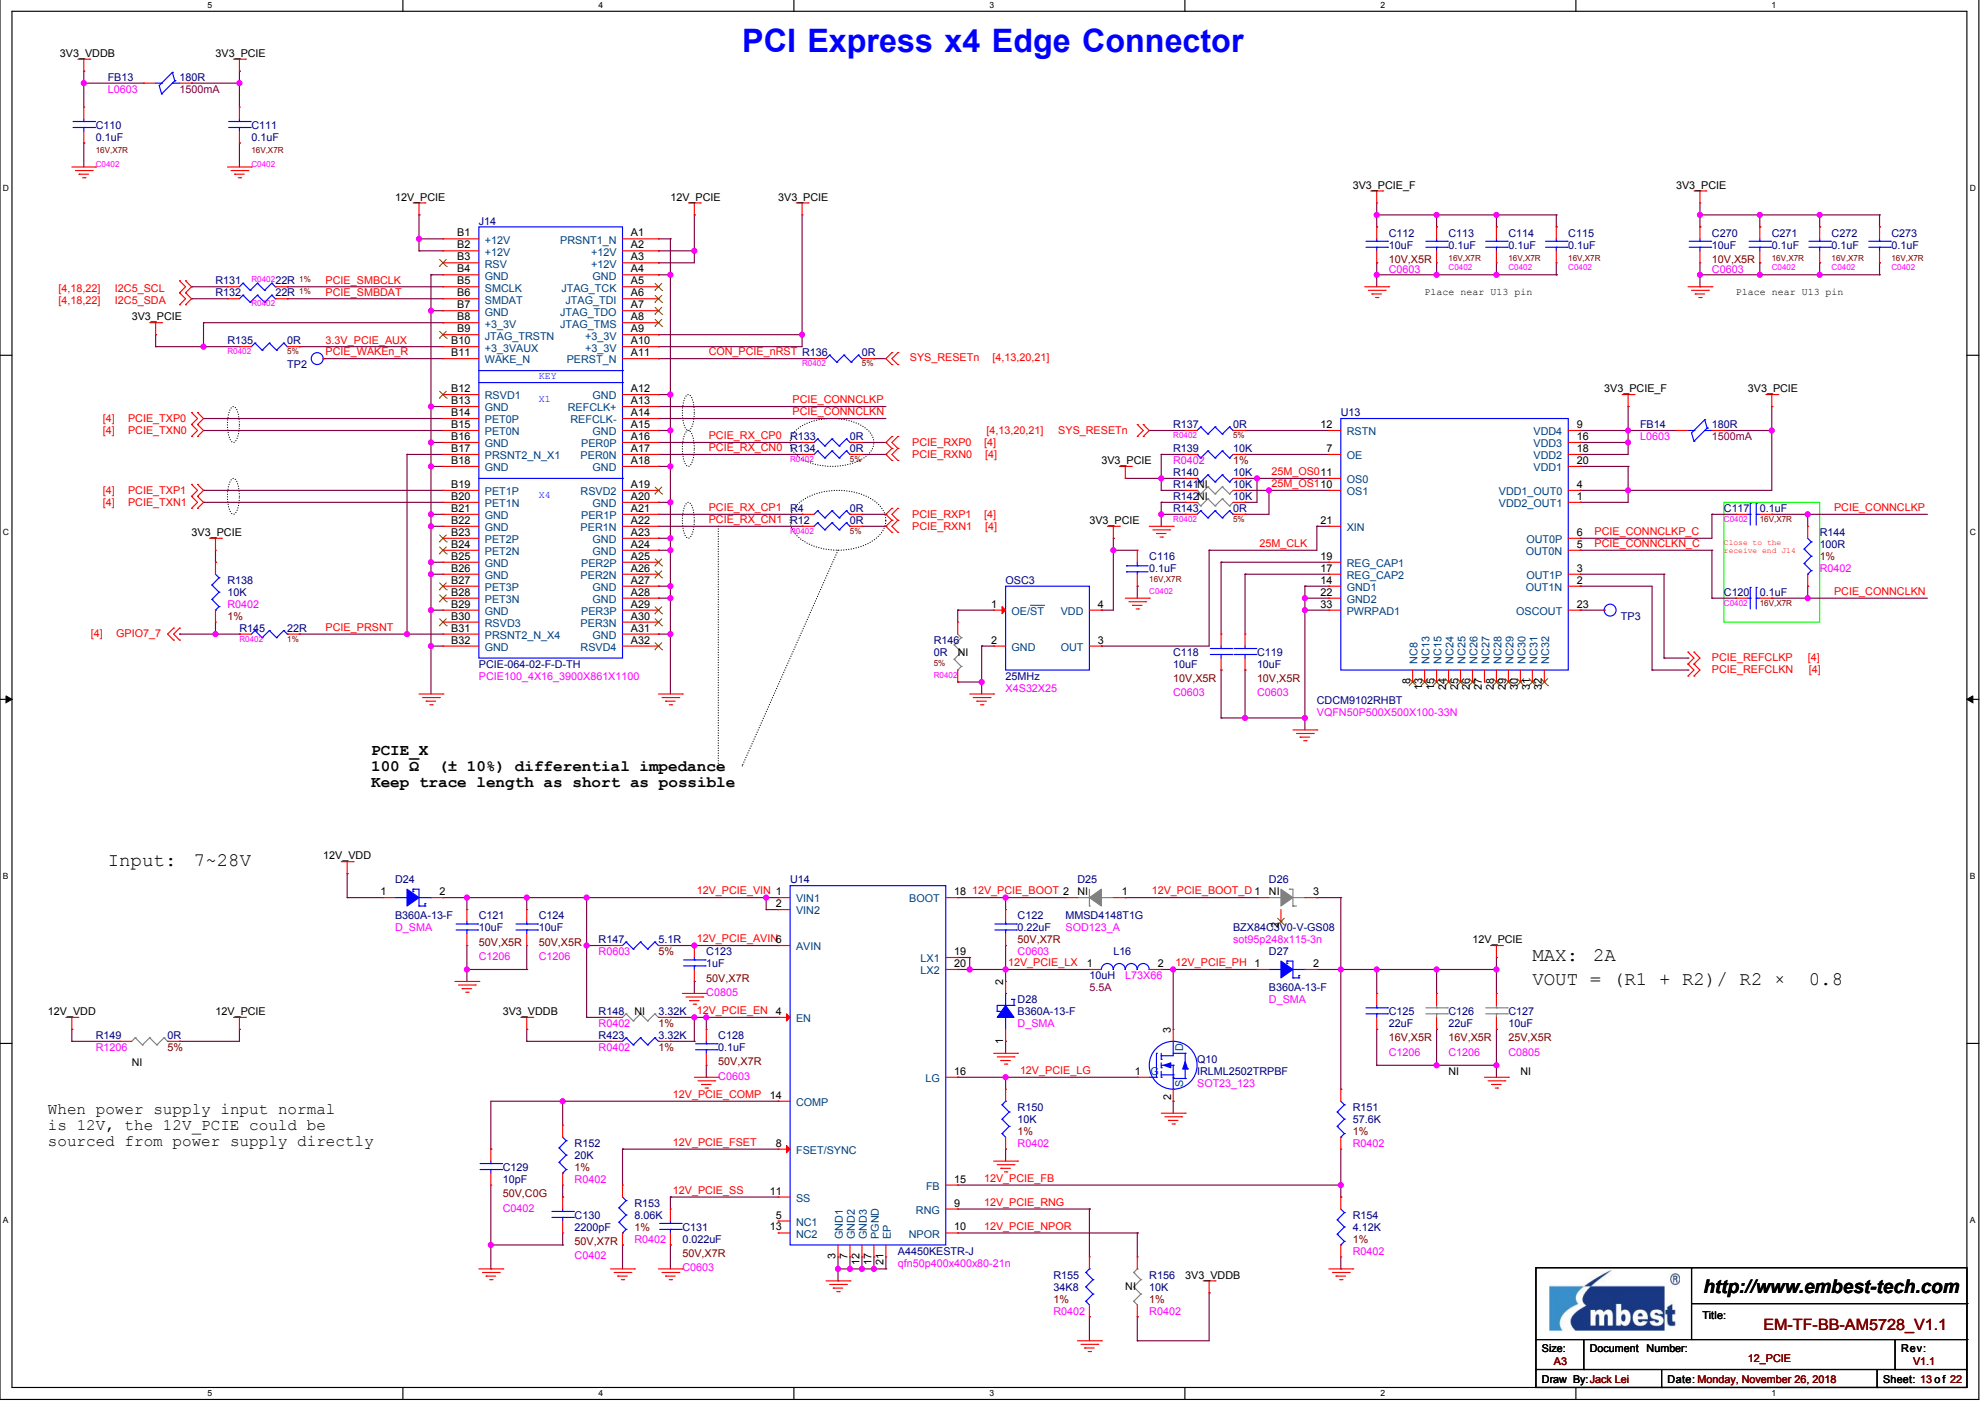
[picture p72: page 13]

PCIE_X
Keep trace length as short as possible

When power supply input normal
is 12V, the 12V_PCIE could be
sourced from power supply directly

http://www.embest-tech.com

# USB 2.0

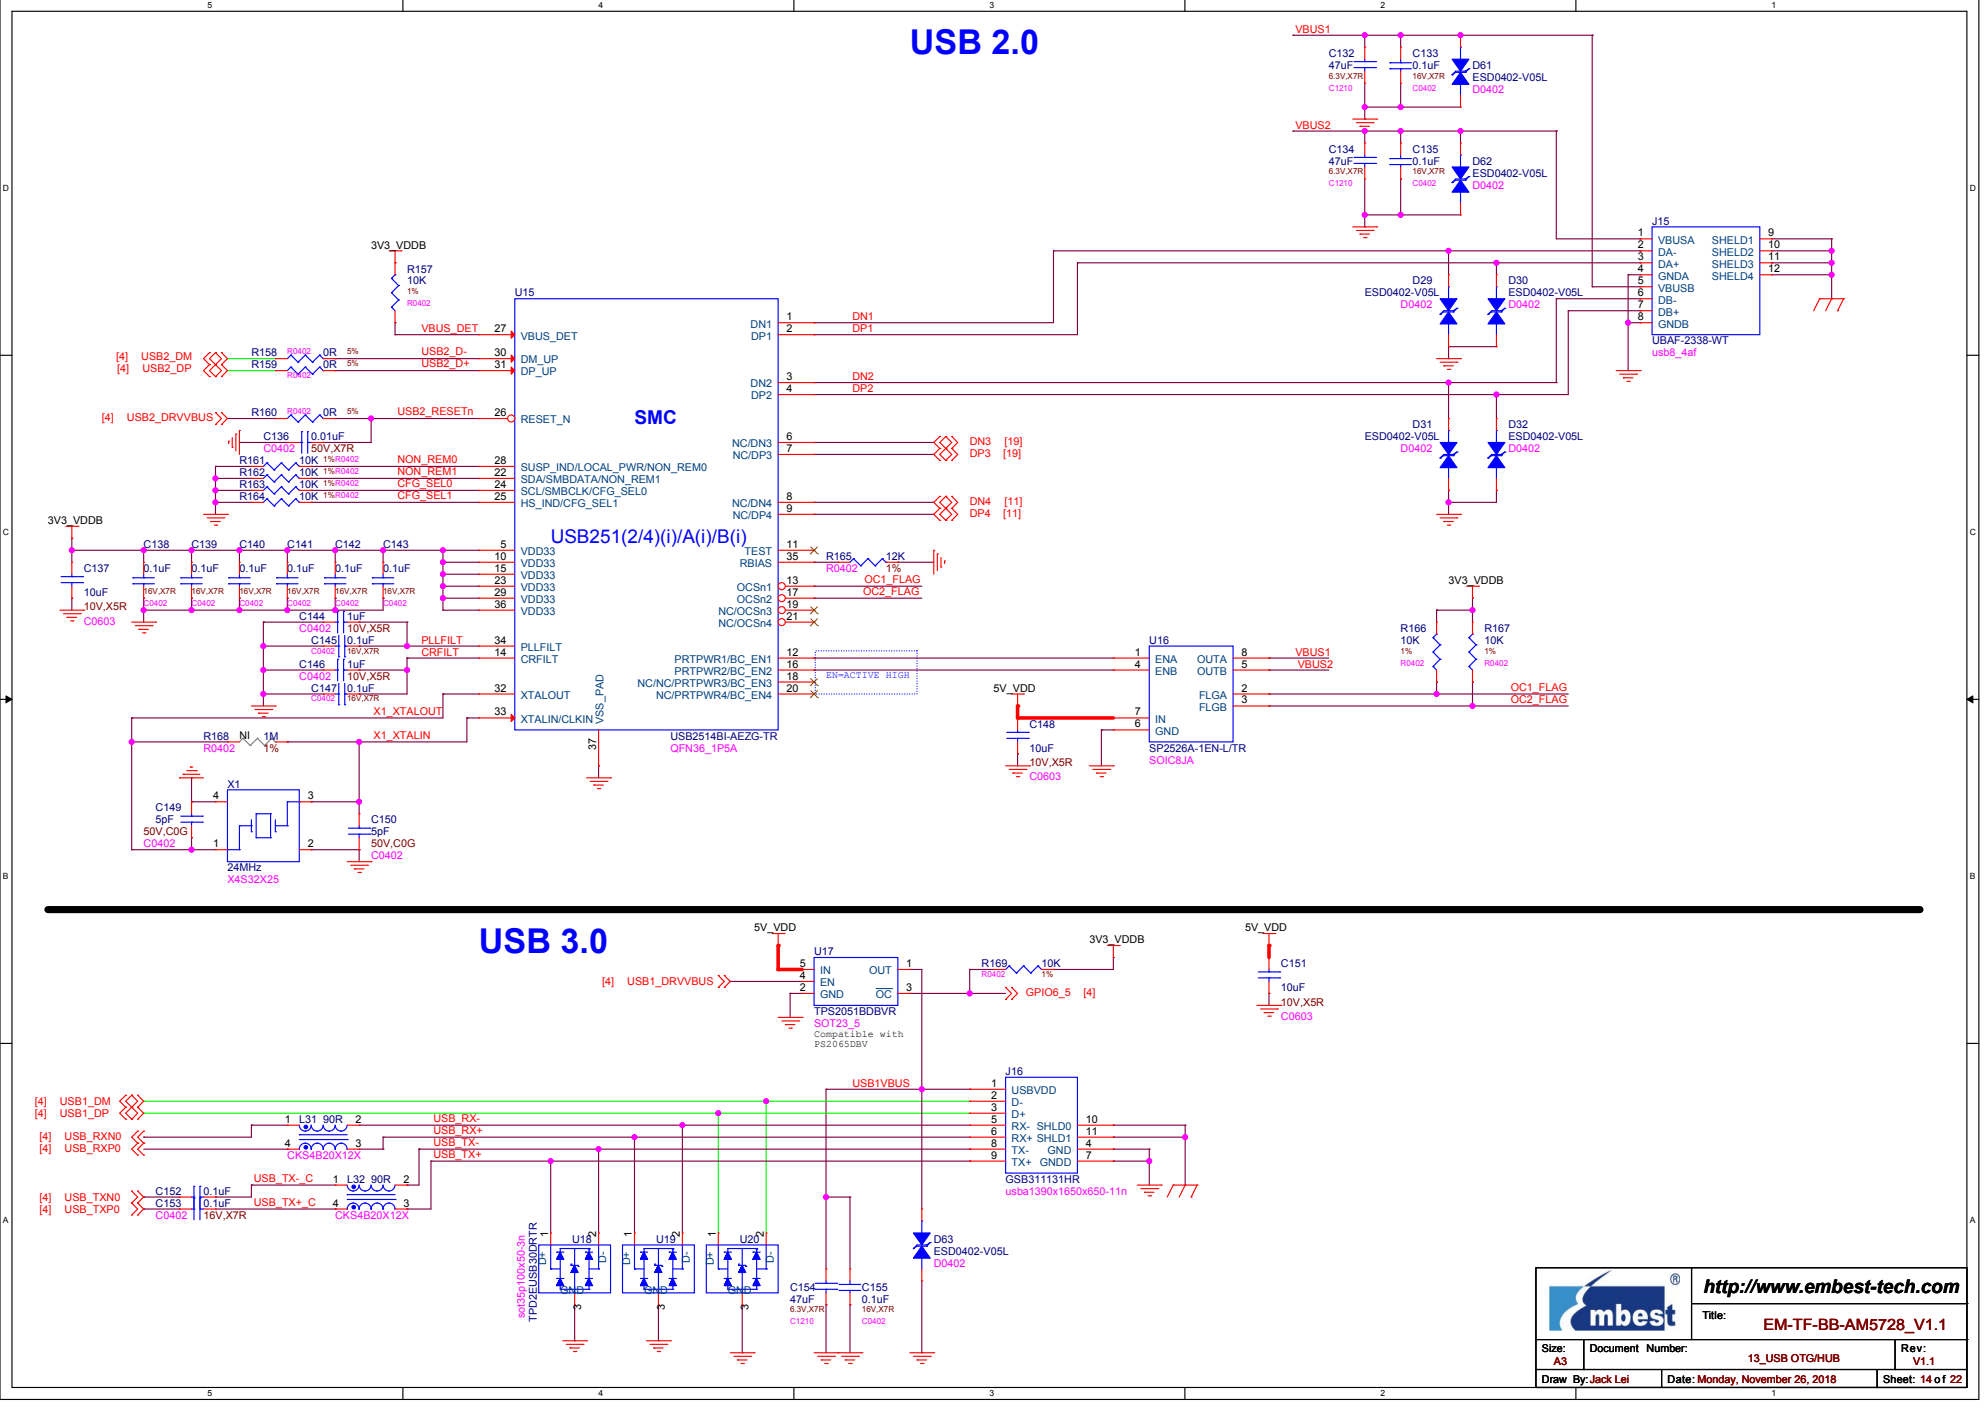
[picture p73: page 14]

http://www.embest-tech.com

# AUDIO

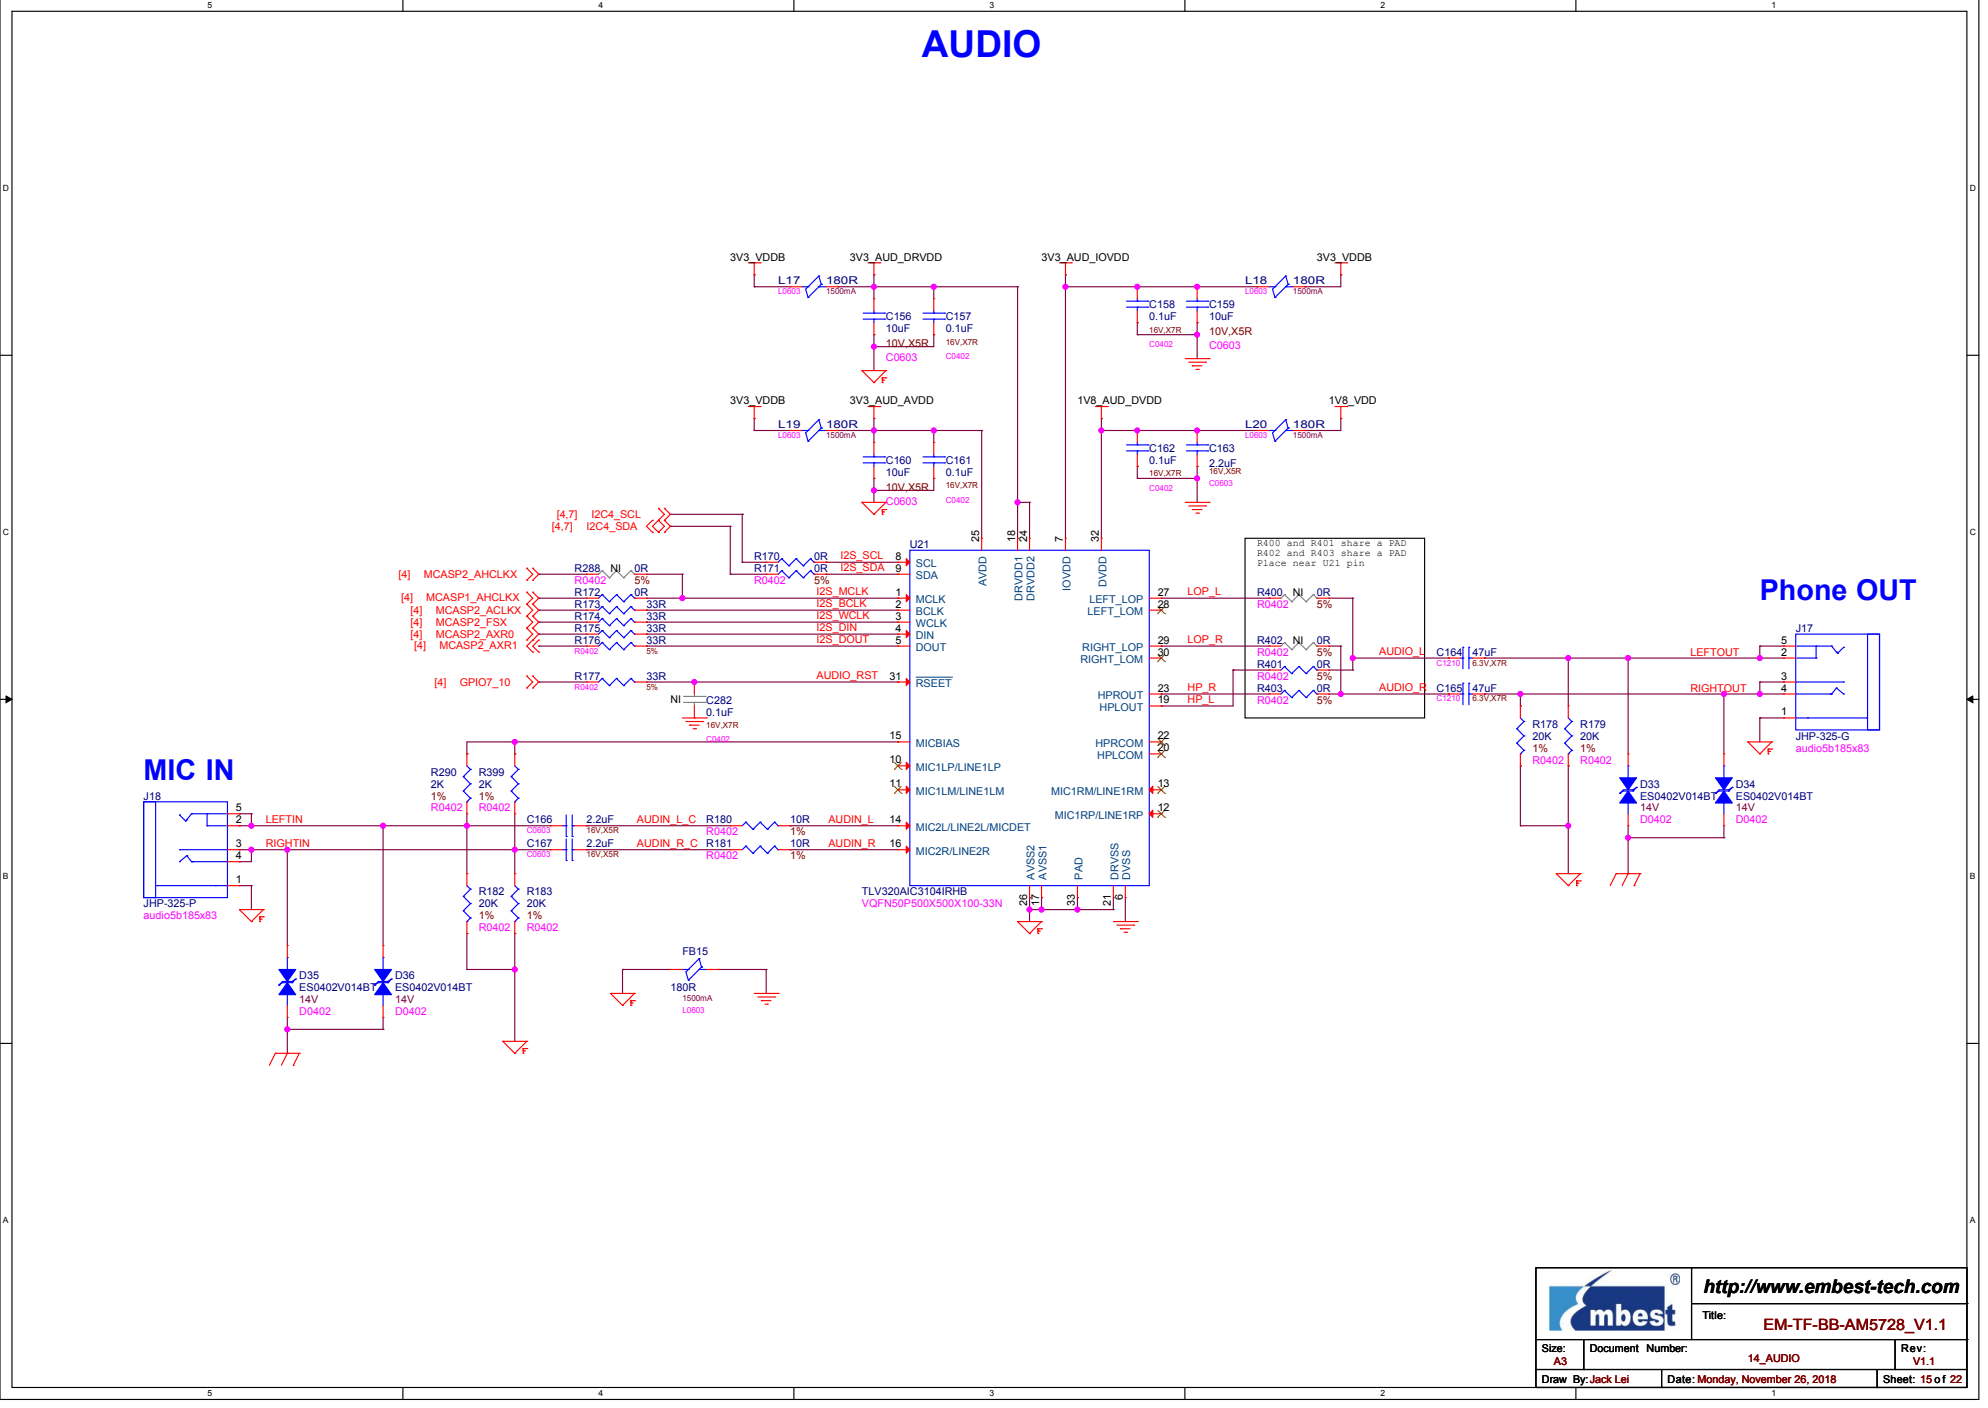
[picture p74: page 15]

http://www.embest-tech.com

# DI/DO

DI2

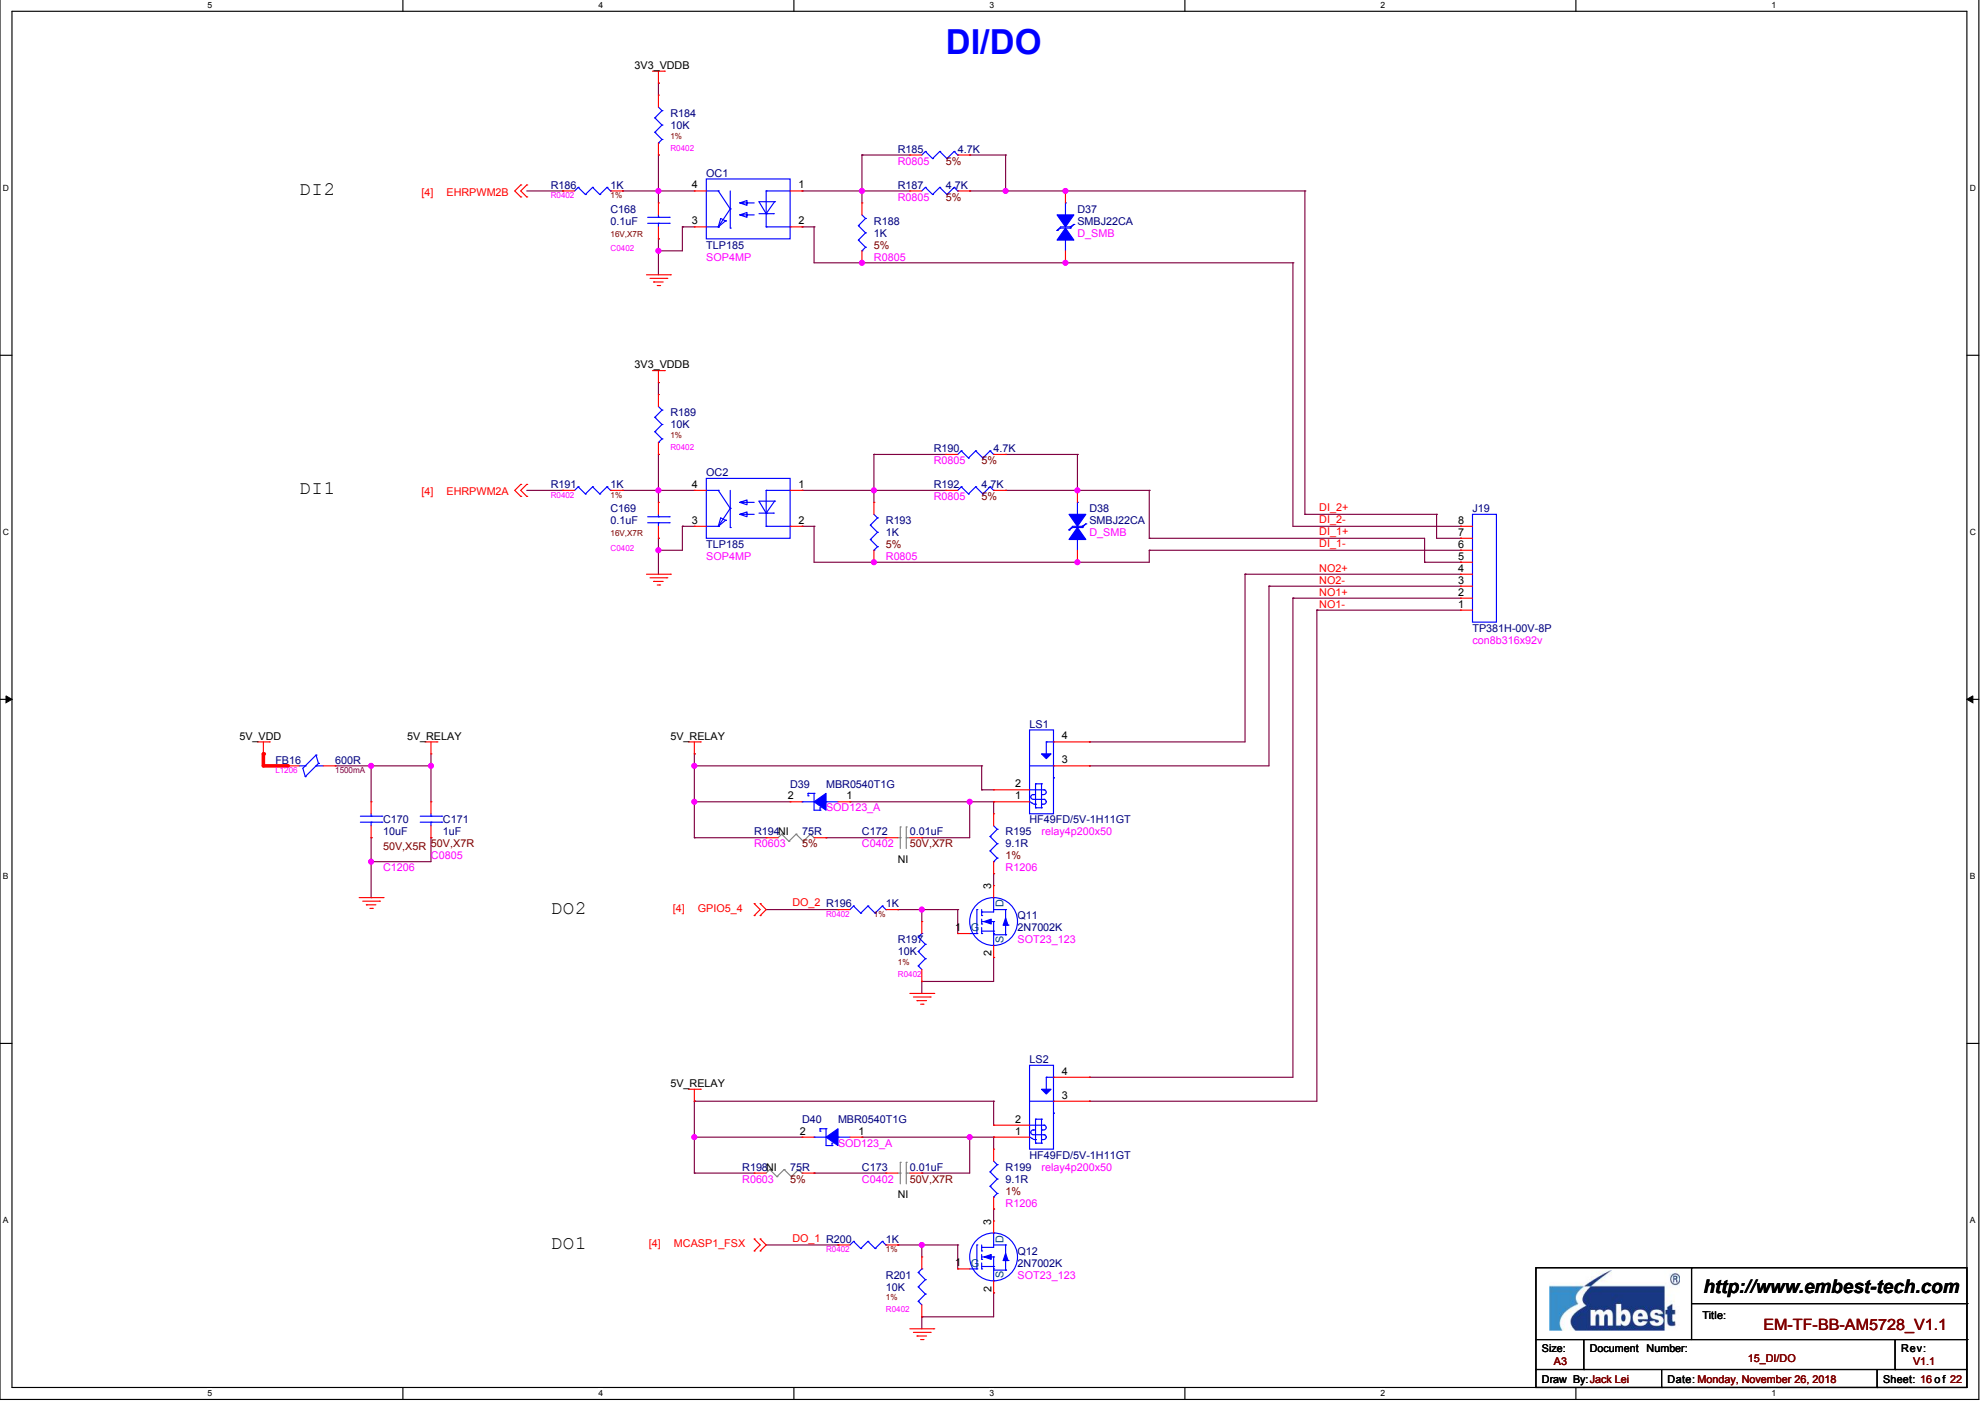
[picture p75: page 16]

http://www.embest-tech.com

# CAN

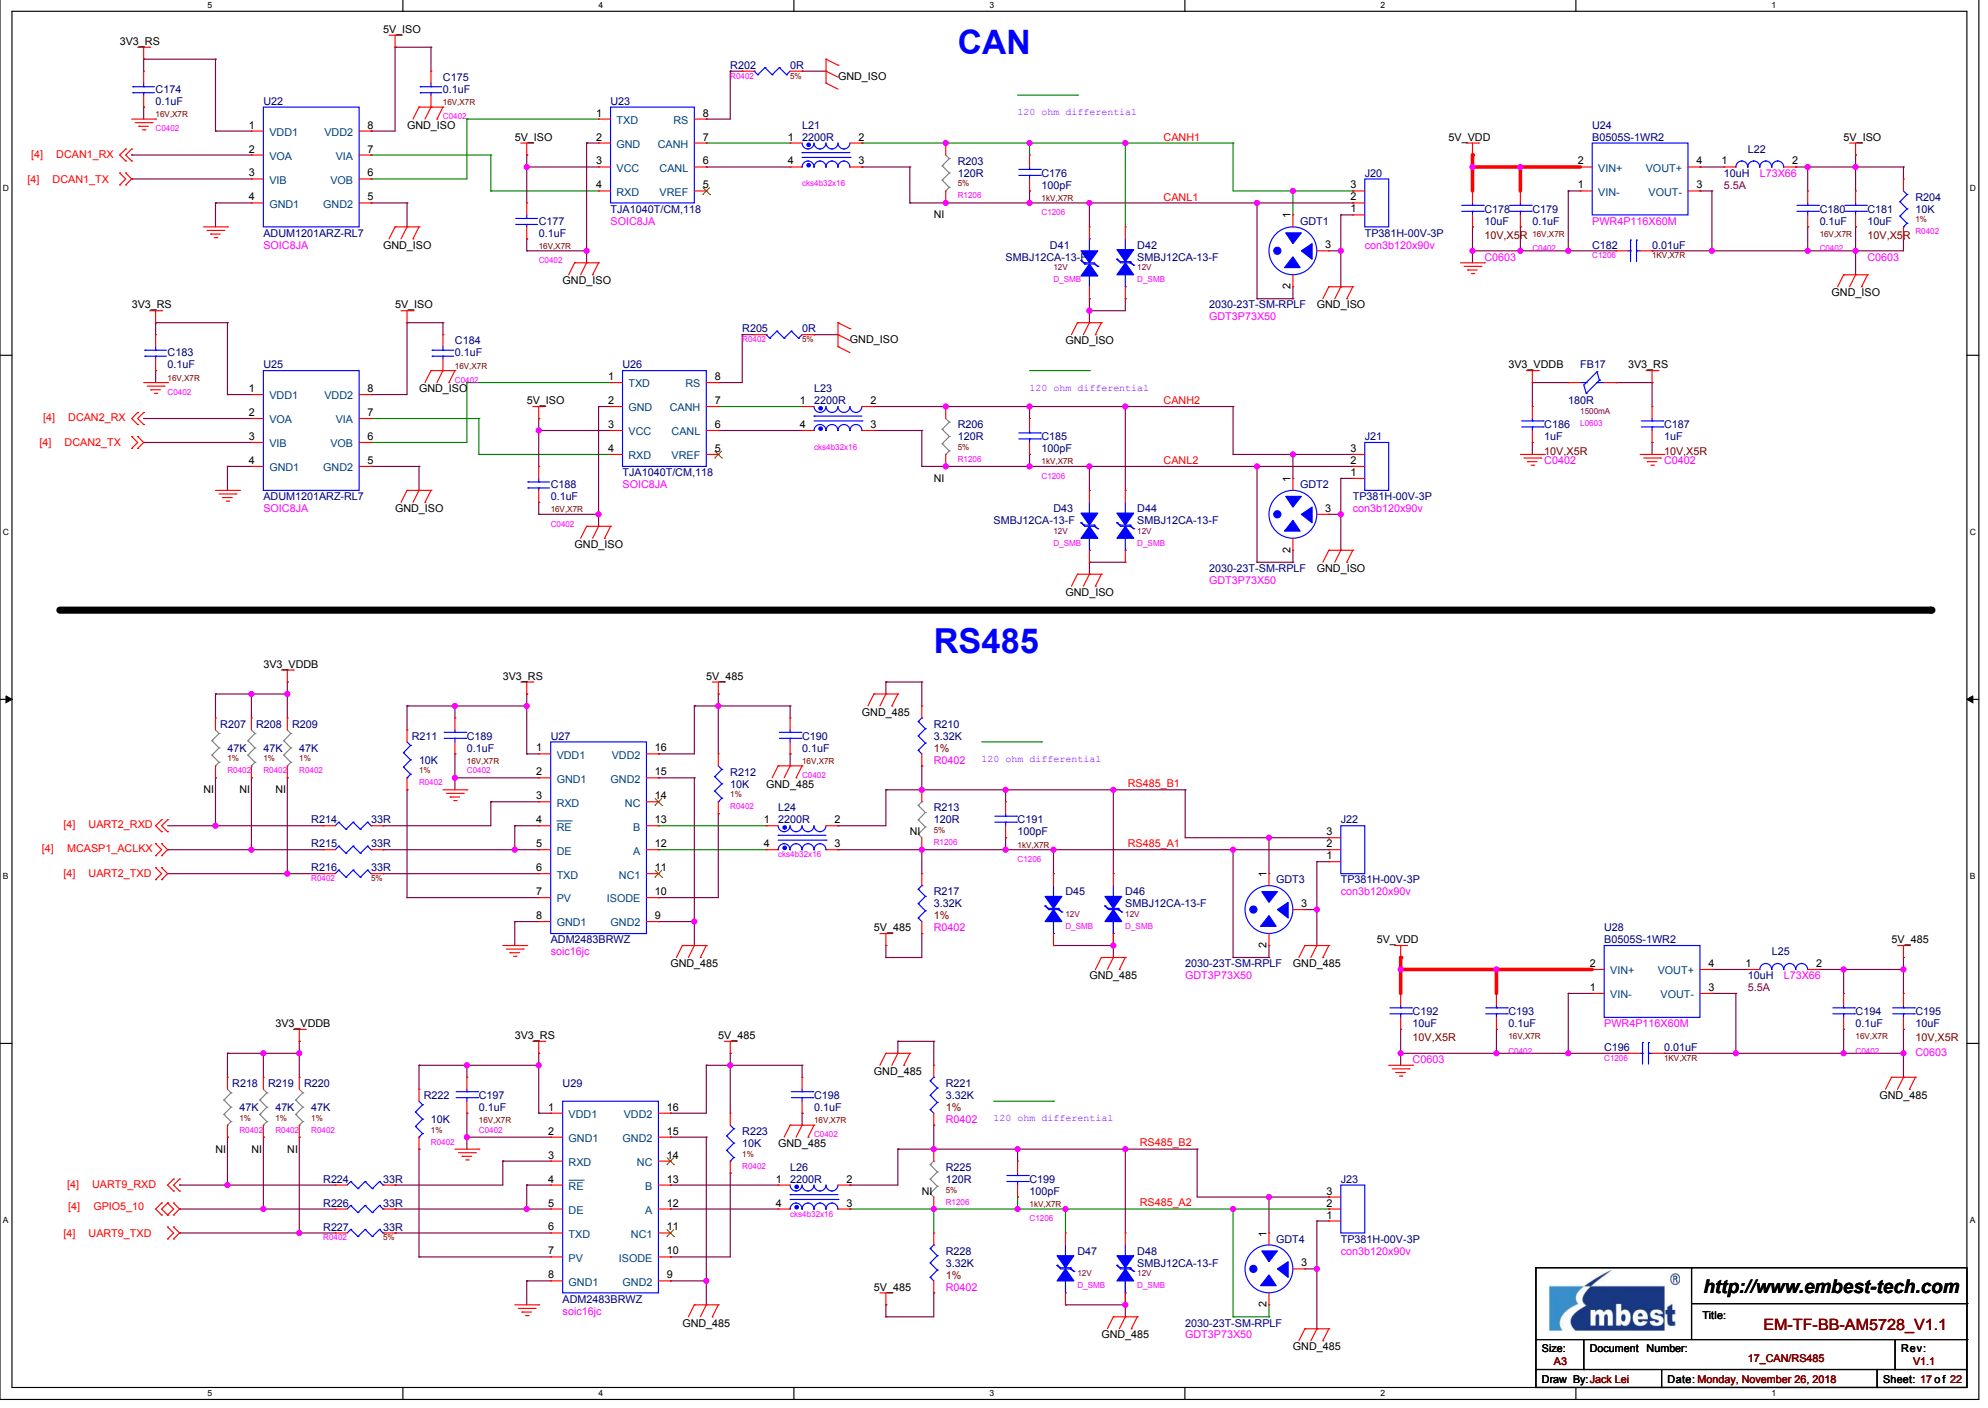
[picture p76: page 17]

http://www.embest-tech.com

# BUTTON/RTC/BEEP/LEDs/BOOT SEL RTC

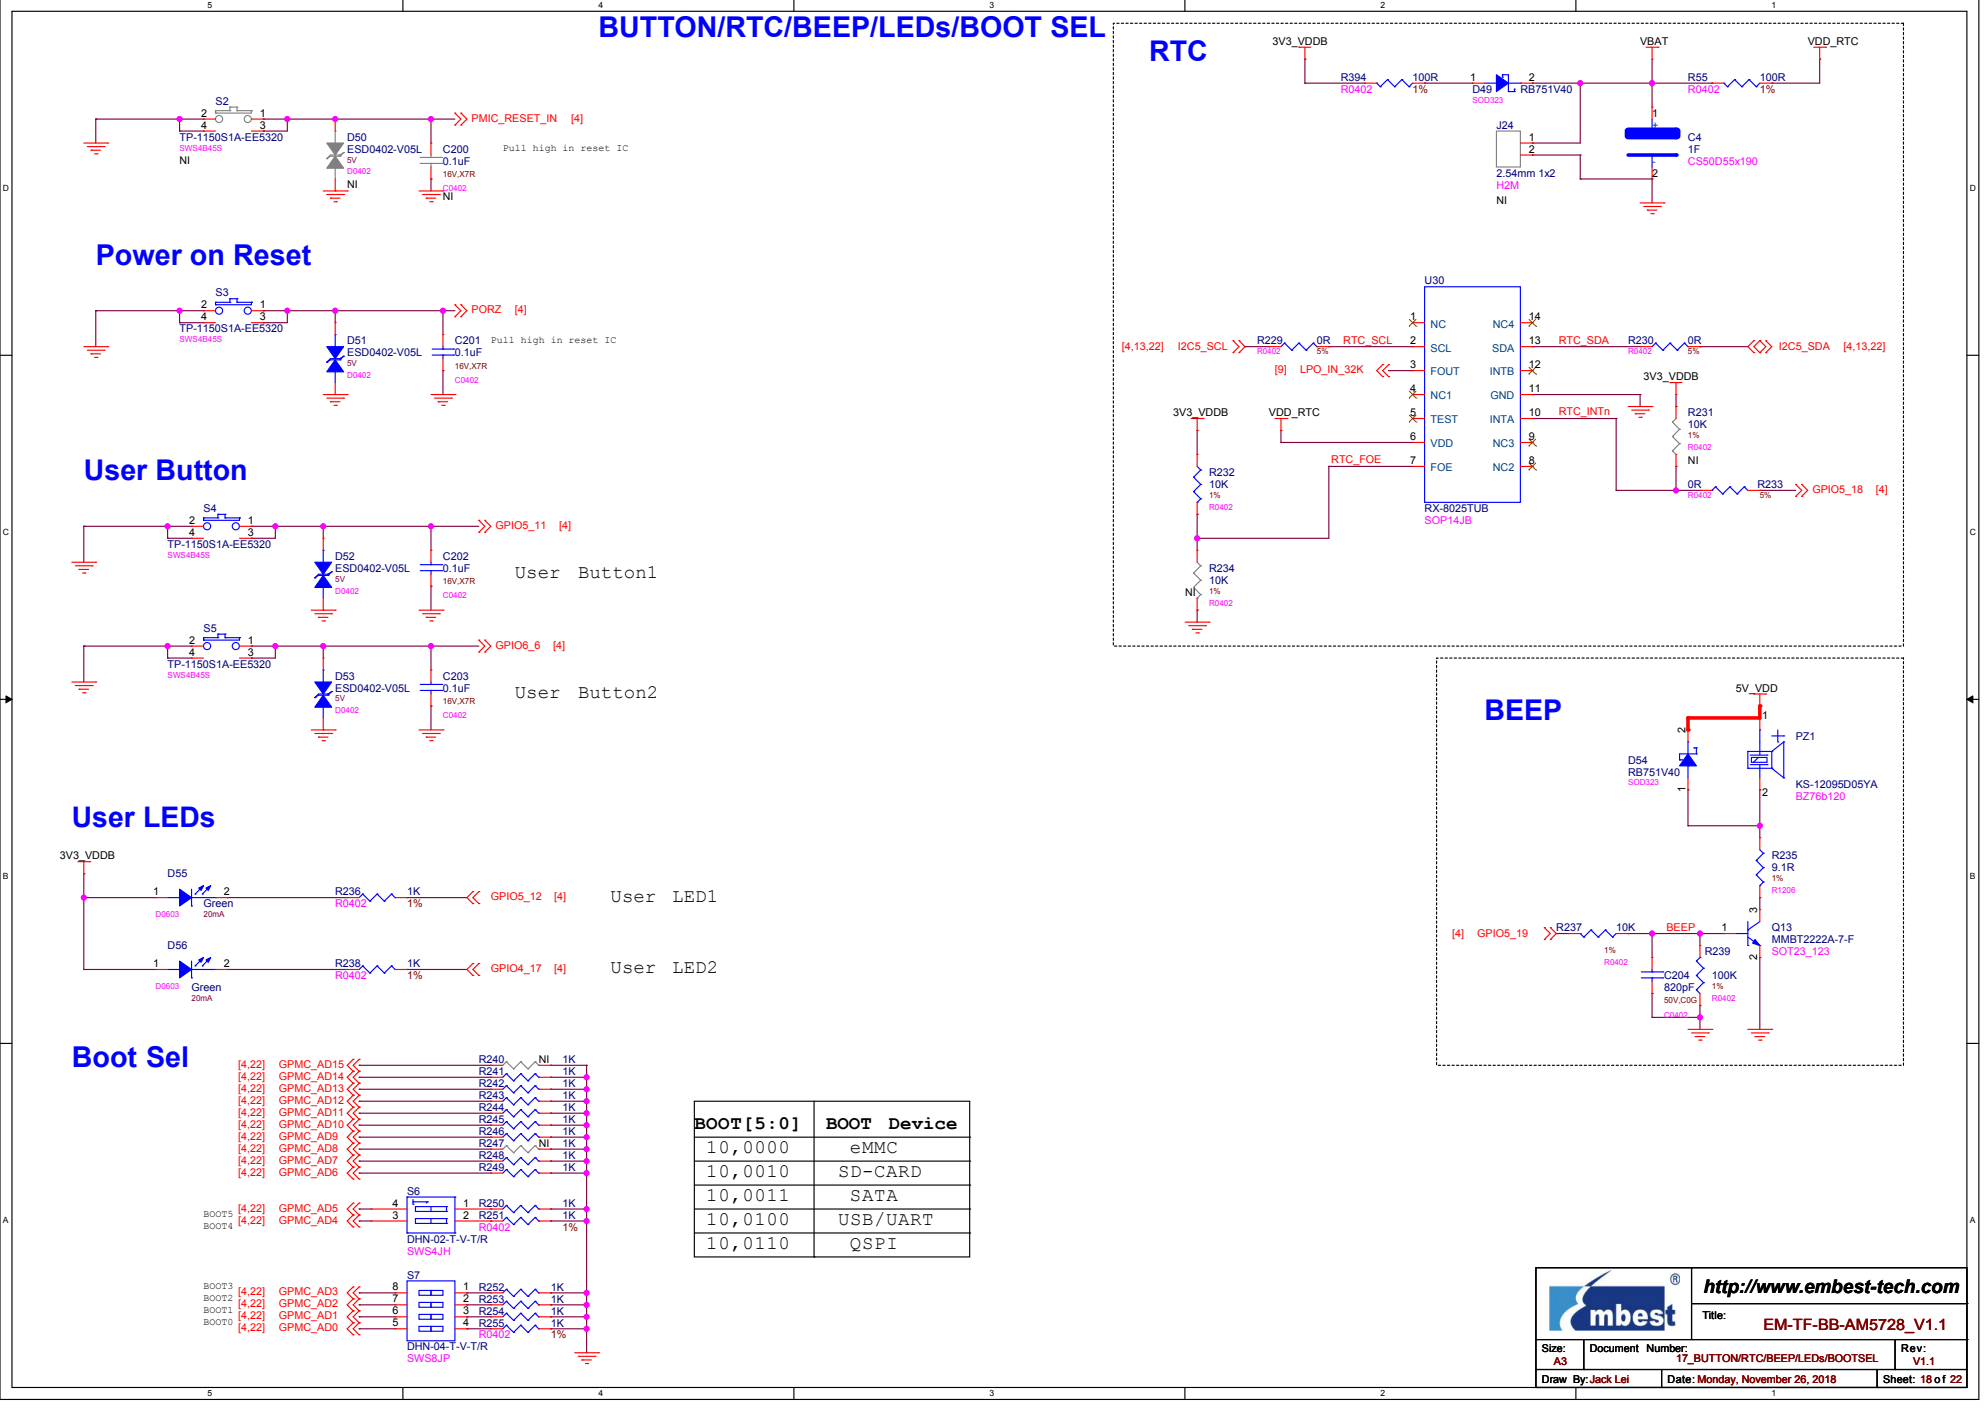
[picture p77: page 18]

Pull high in reset IC

http://www.embest-tech.com

# Mini PCIE

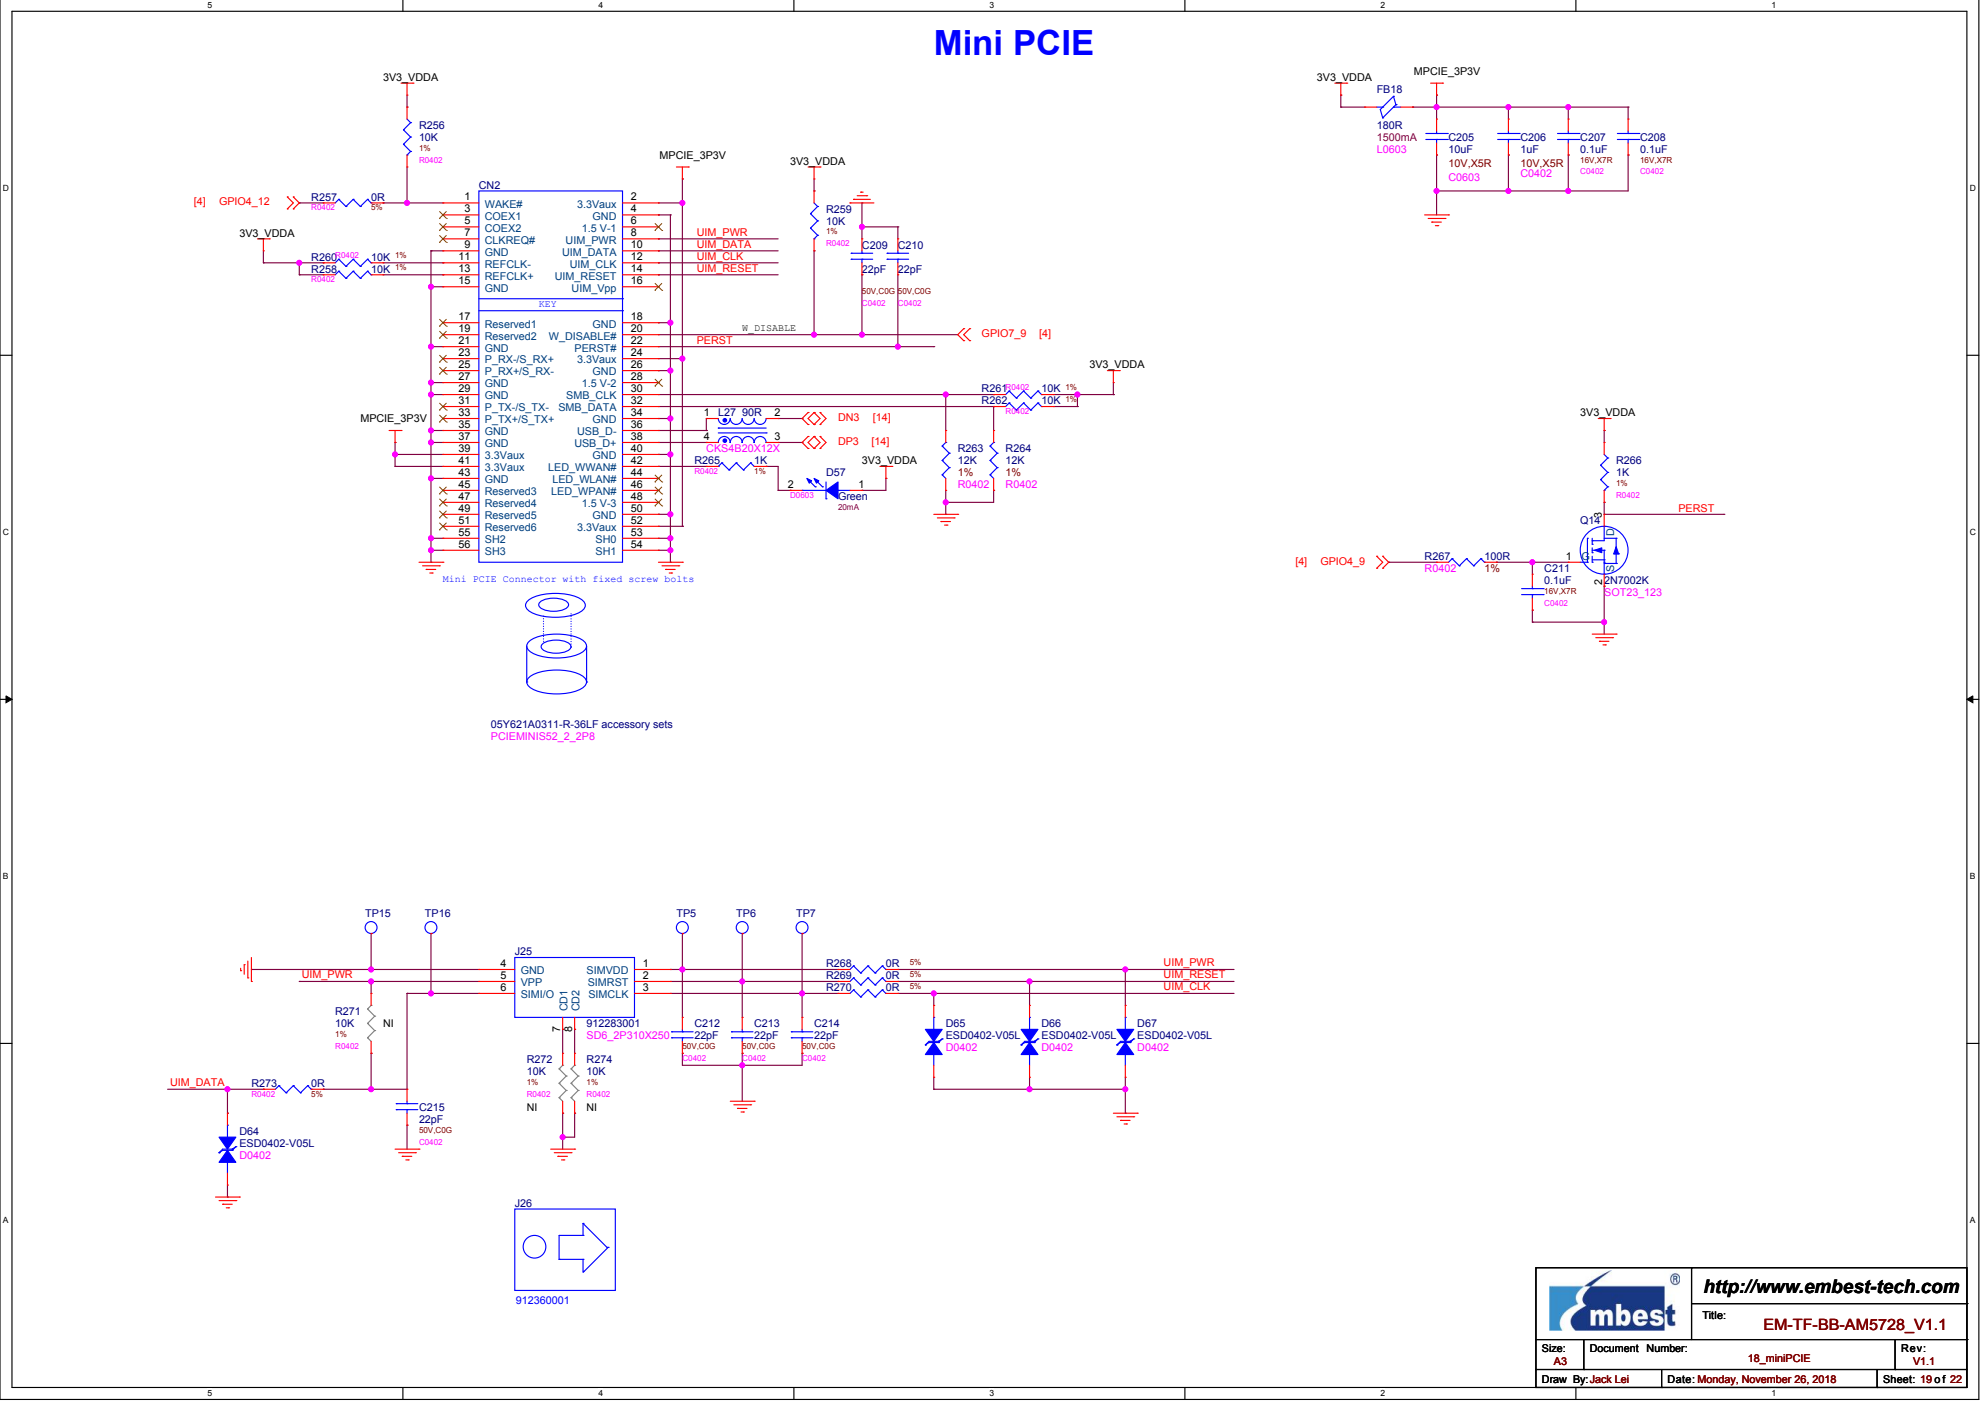
[picture p78: page 19]

Mini PCIE Connector with fixed screw bolts

http://www.embest-tech.com

# ETHERNET0

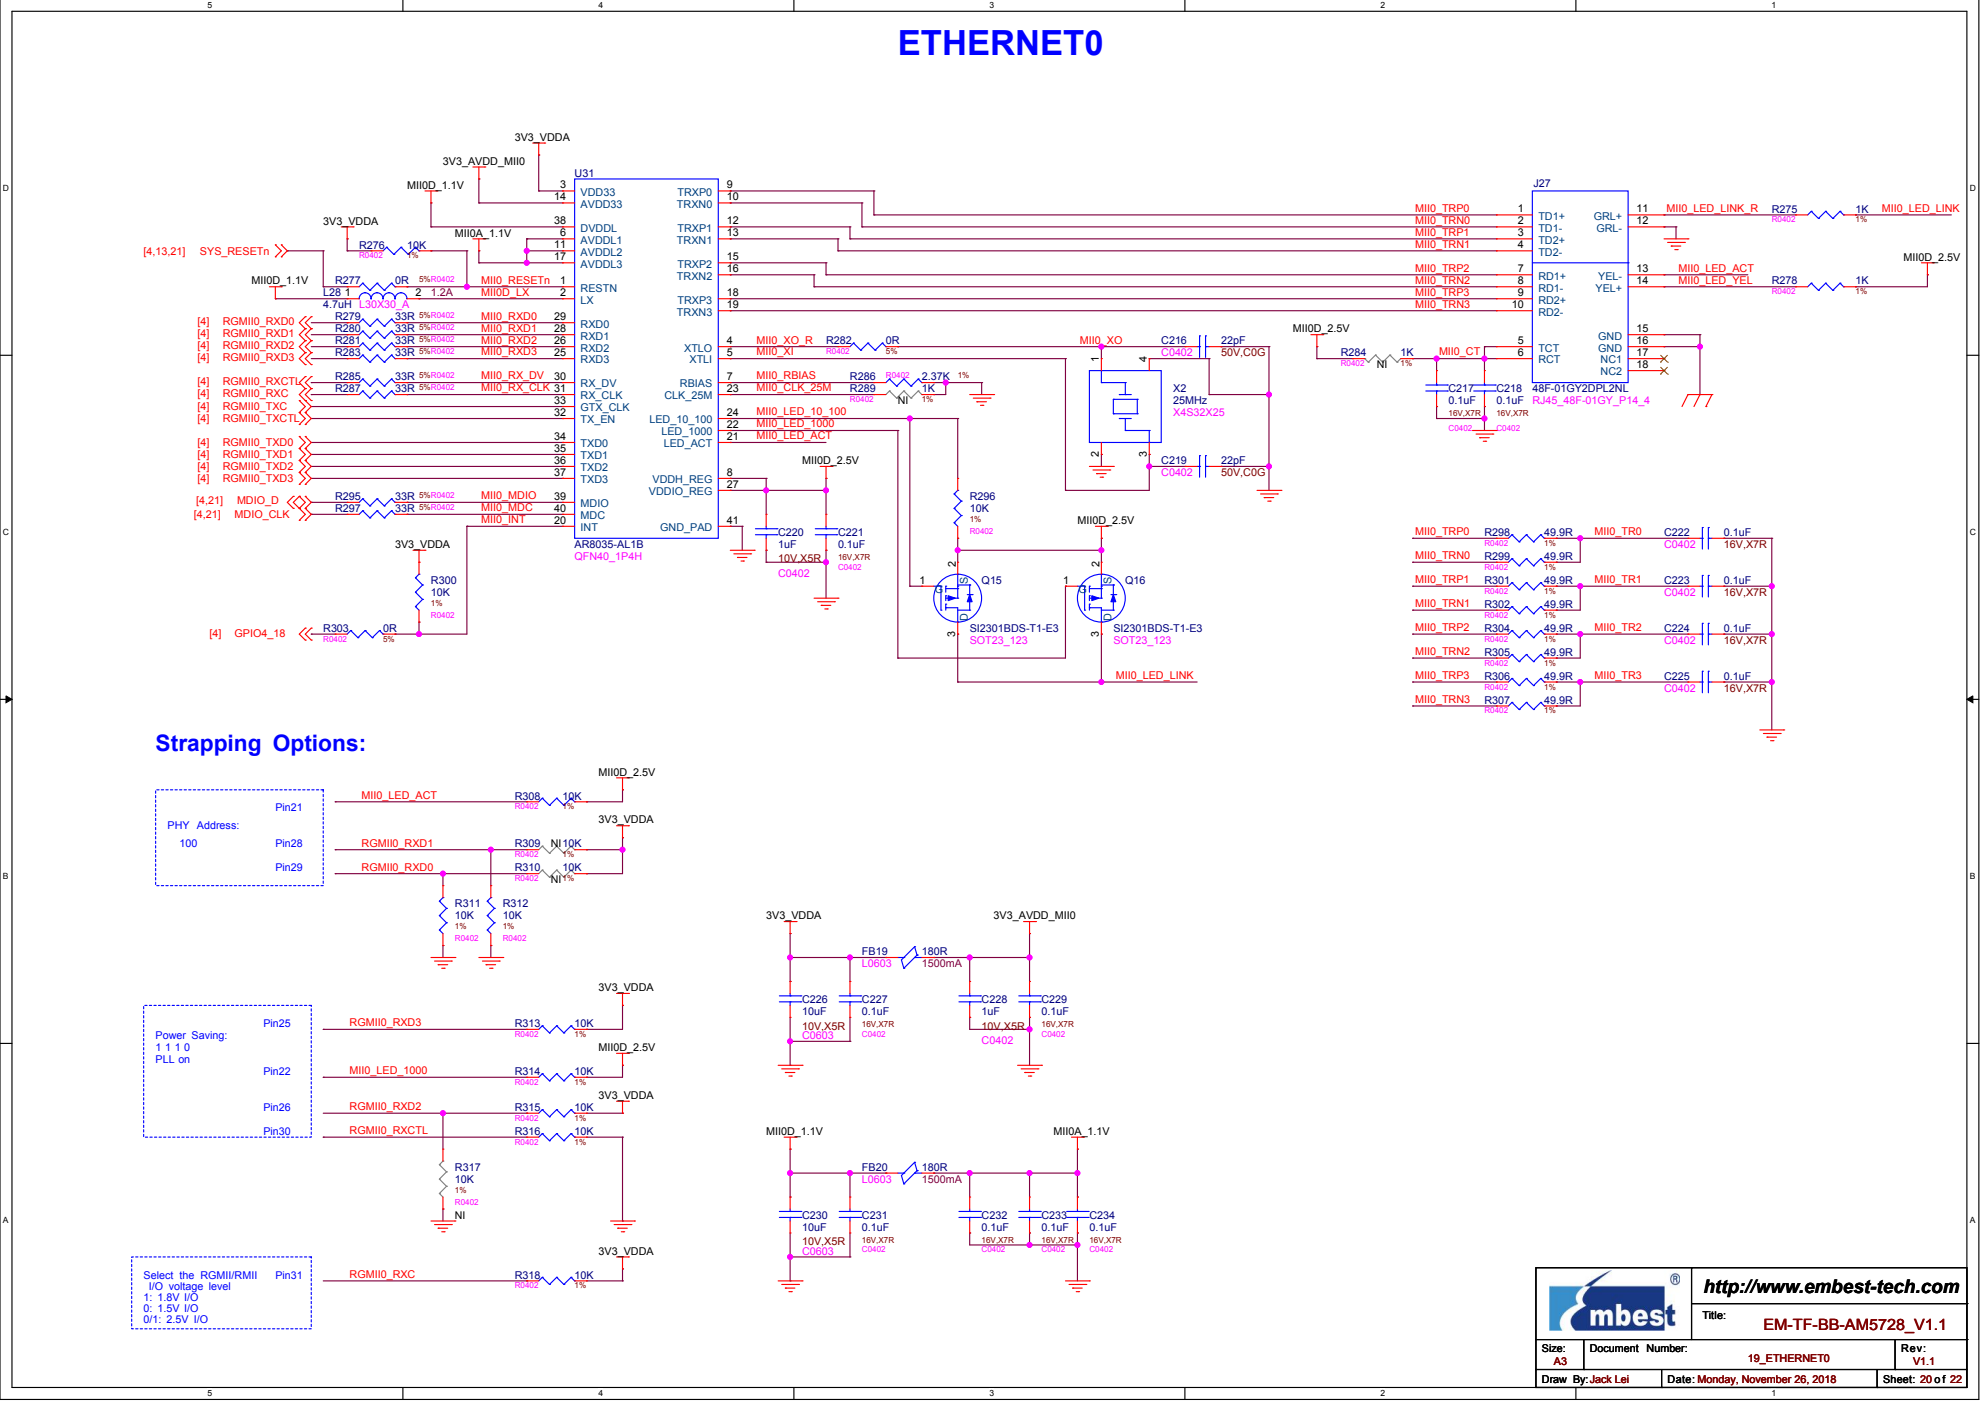
[picture p79: page 20]

http://www.embest-tech.com

# ETHERNET1

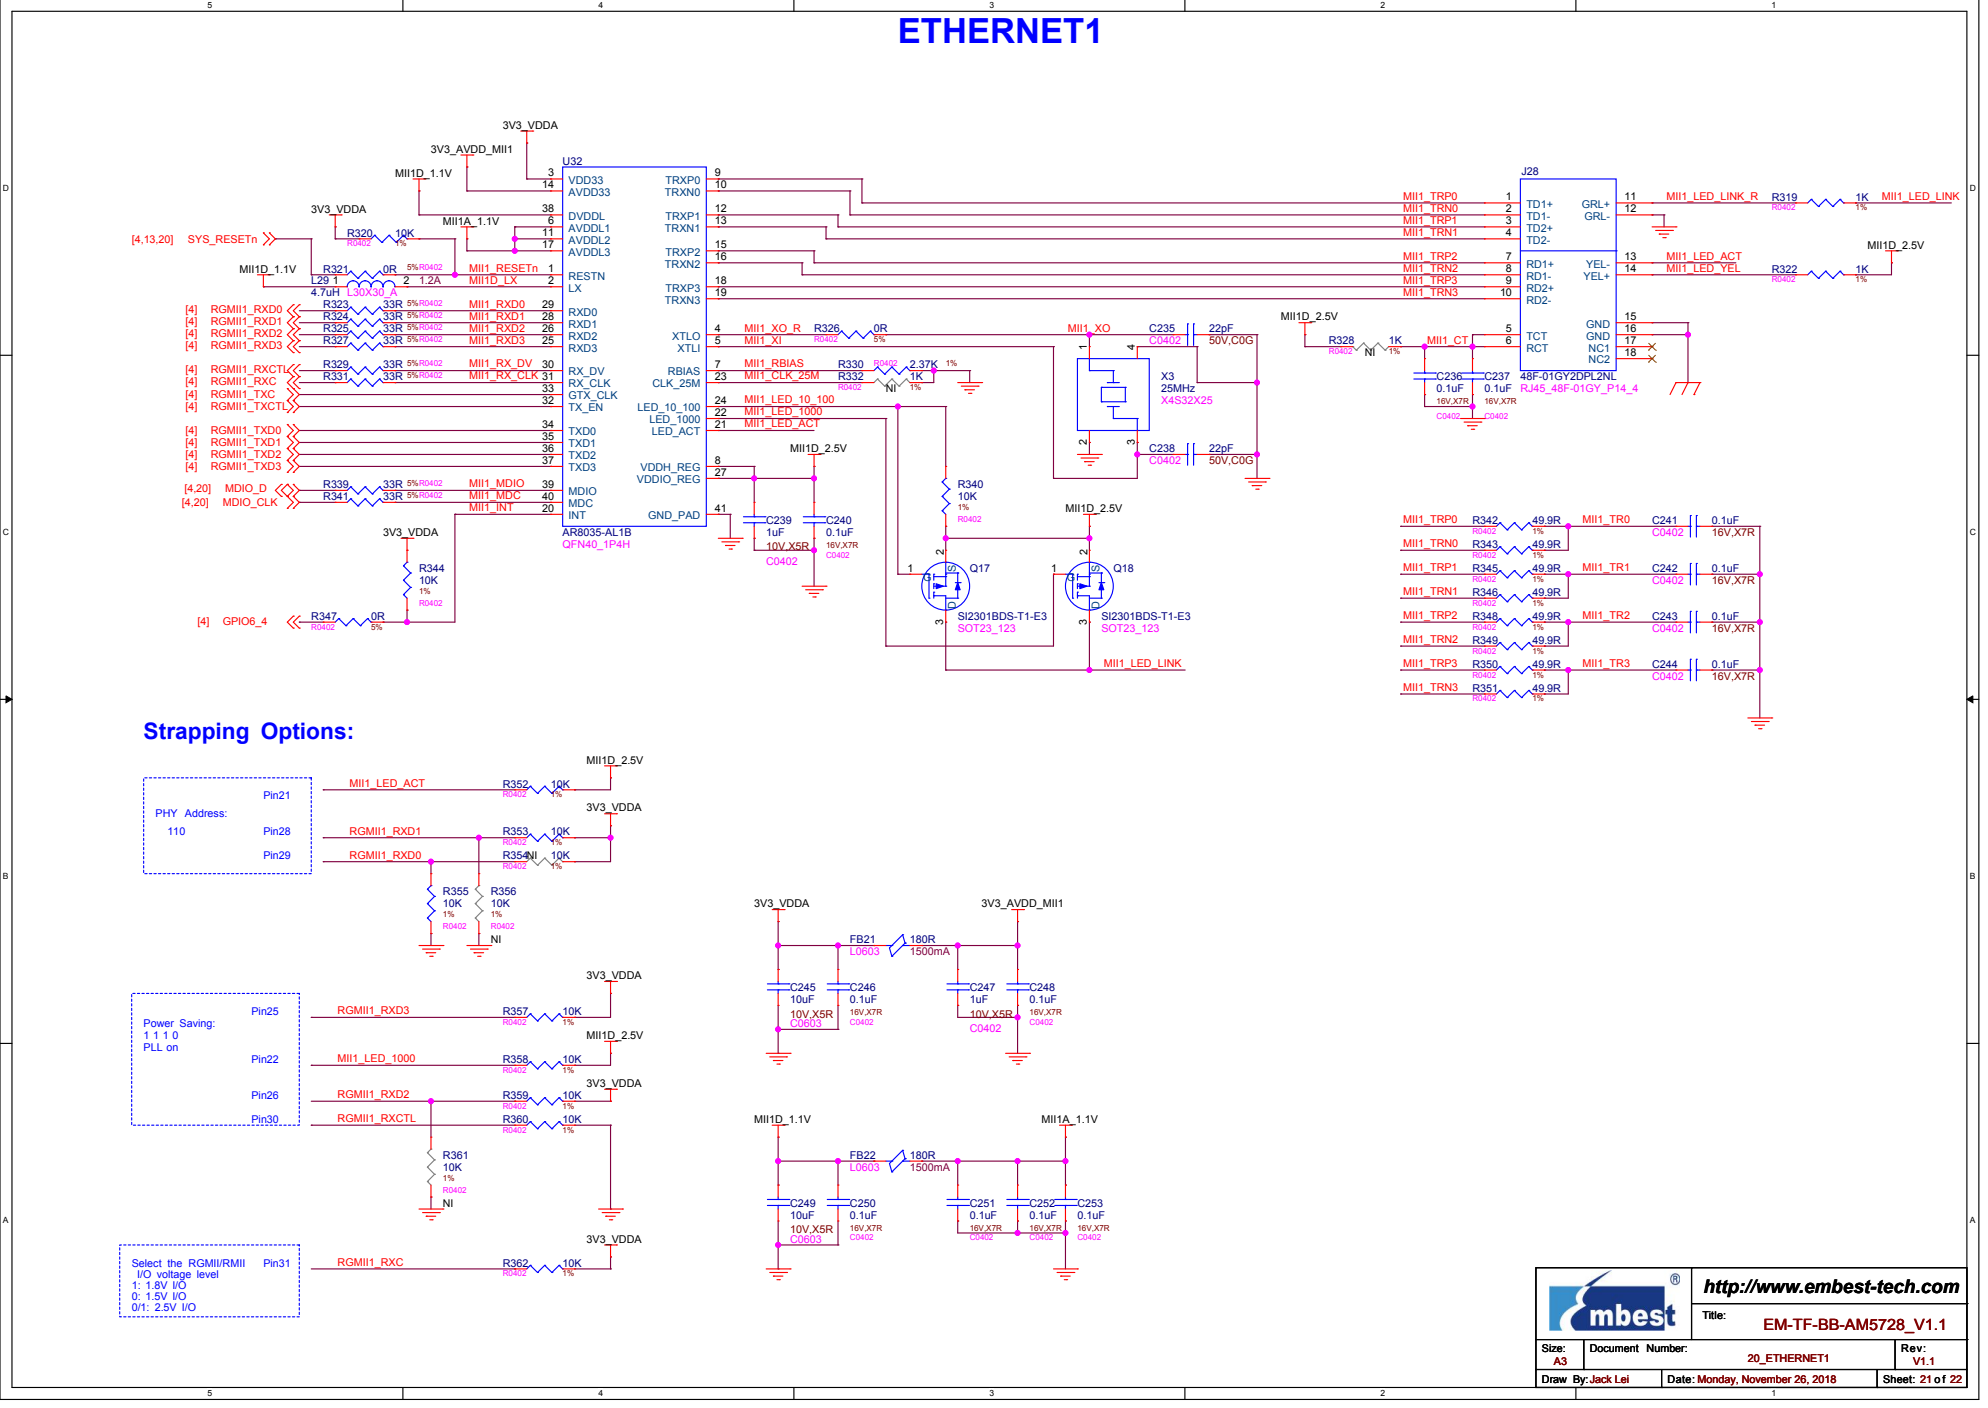
[picture p80: page 21]

http://www.embest-tech.com

# GPMC/UART to USB/EXP CONN

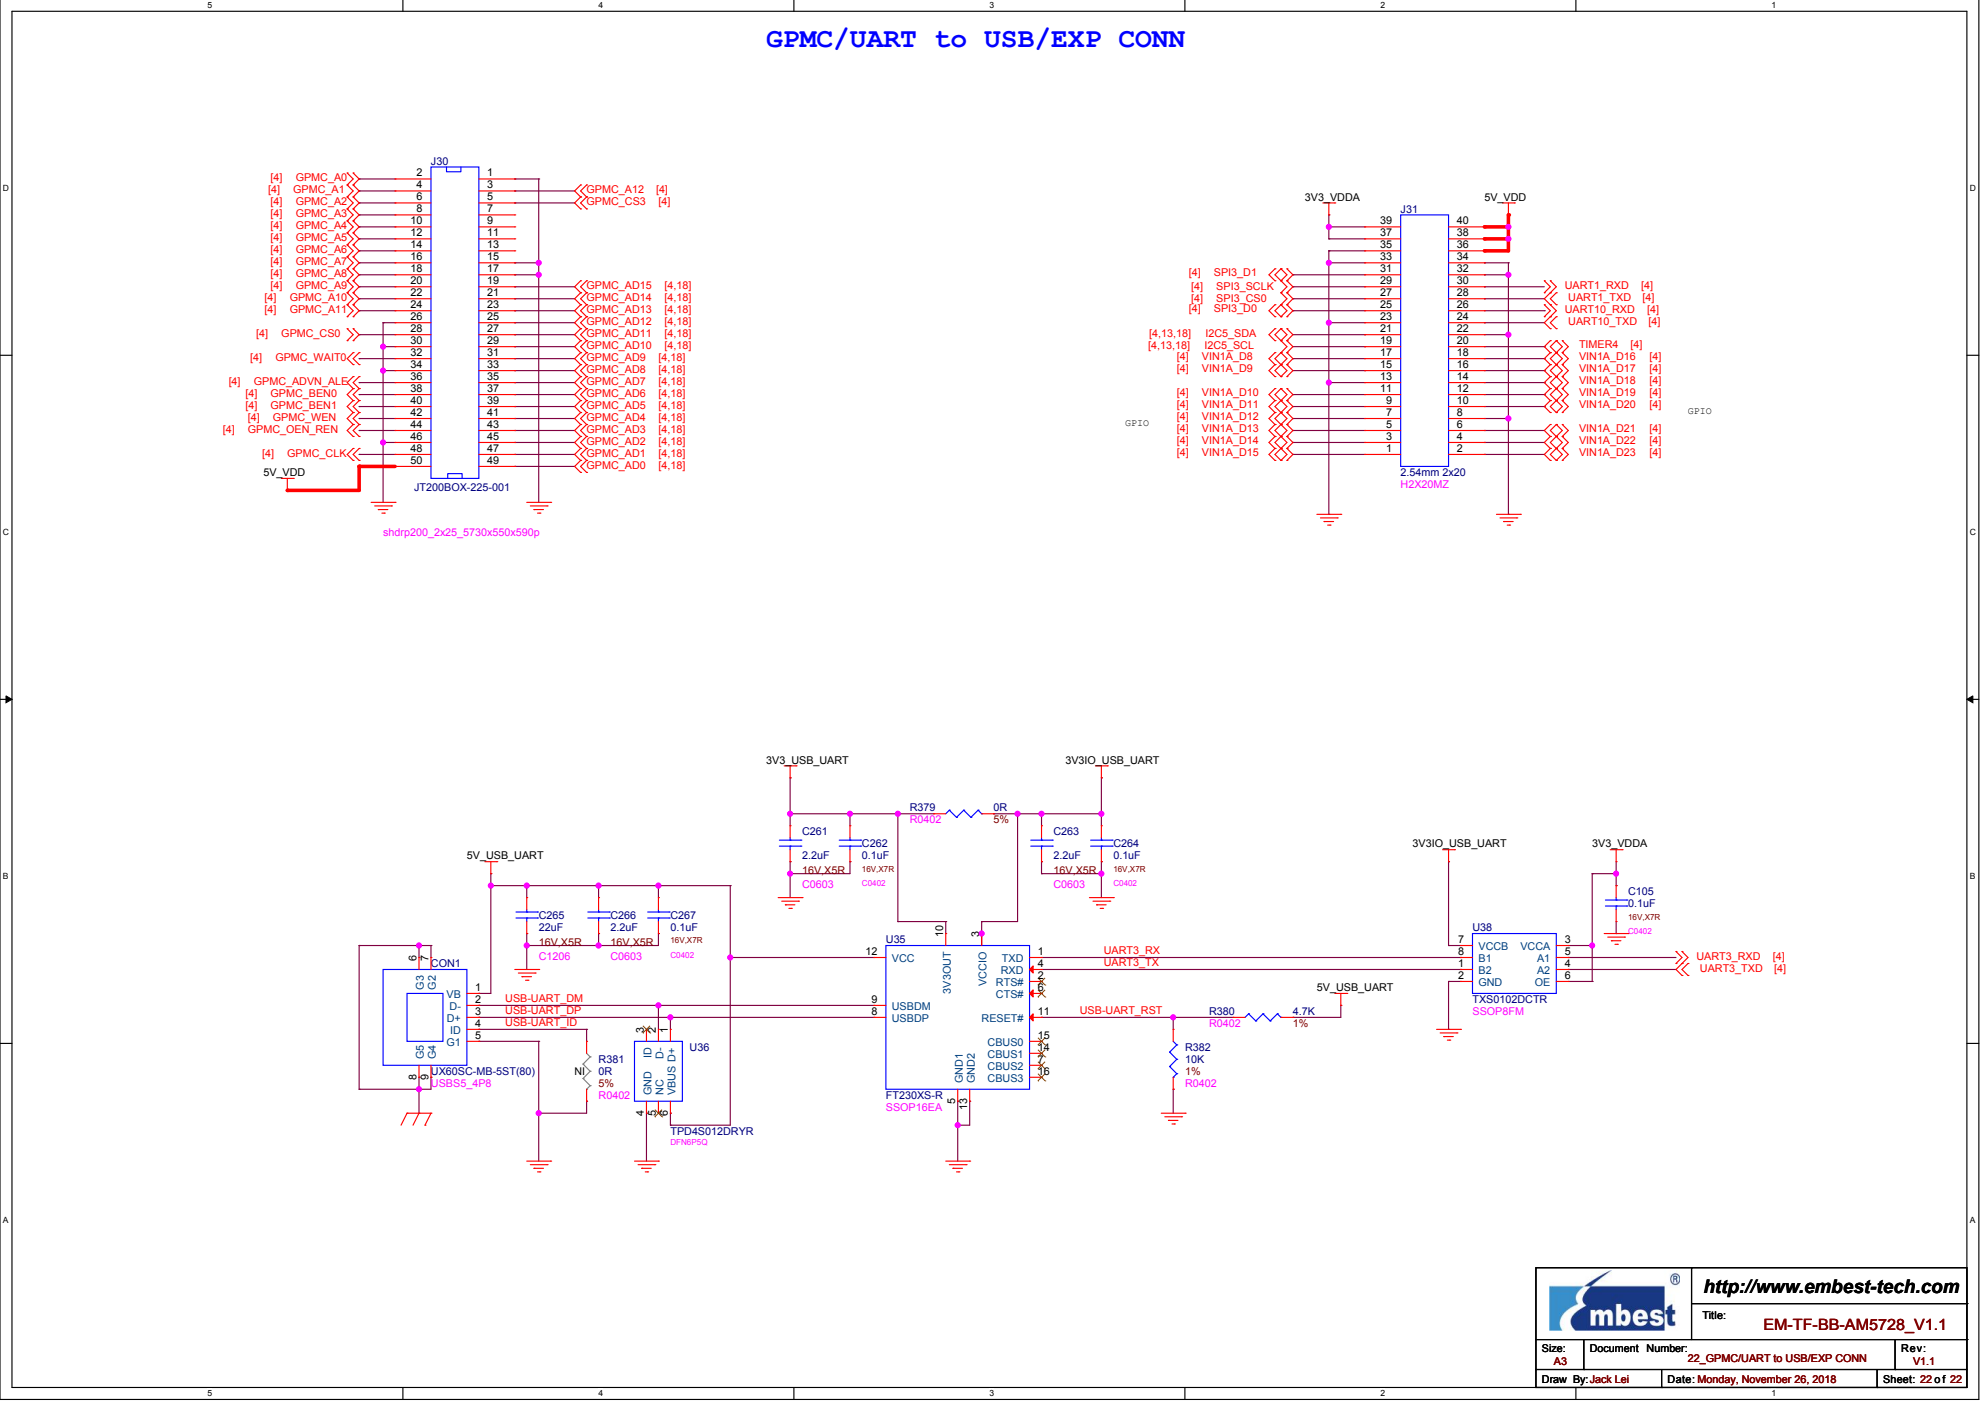
[picture p81: page 22]

http://www.embest-tech.com
