anonymouslojz/EM-TF-SOM-AM5728/03-Schematic/EM-TF-SOM-AM57X V1.pdf

# SOM-AM57xx-TM

# SCHEMATIC PAGE

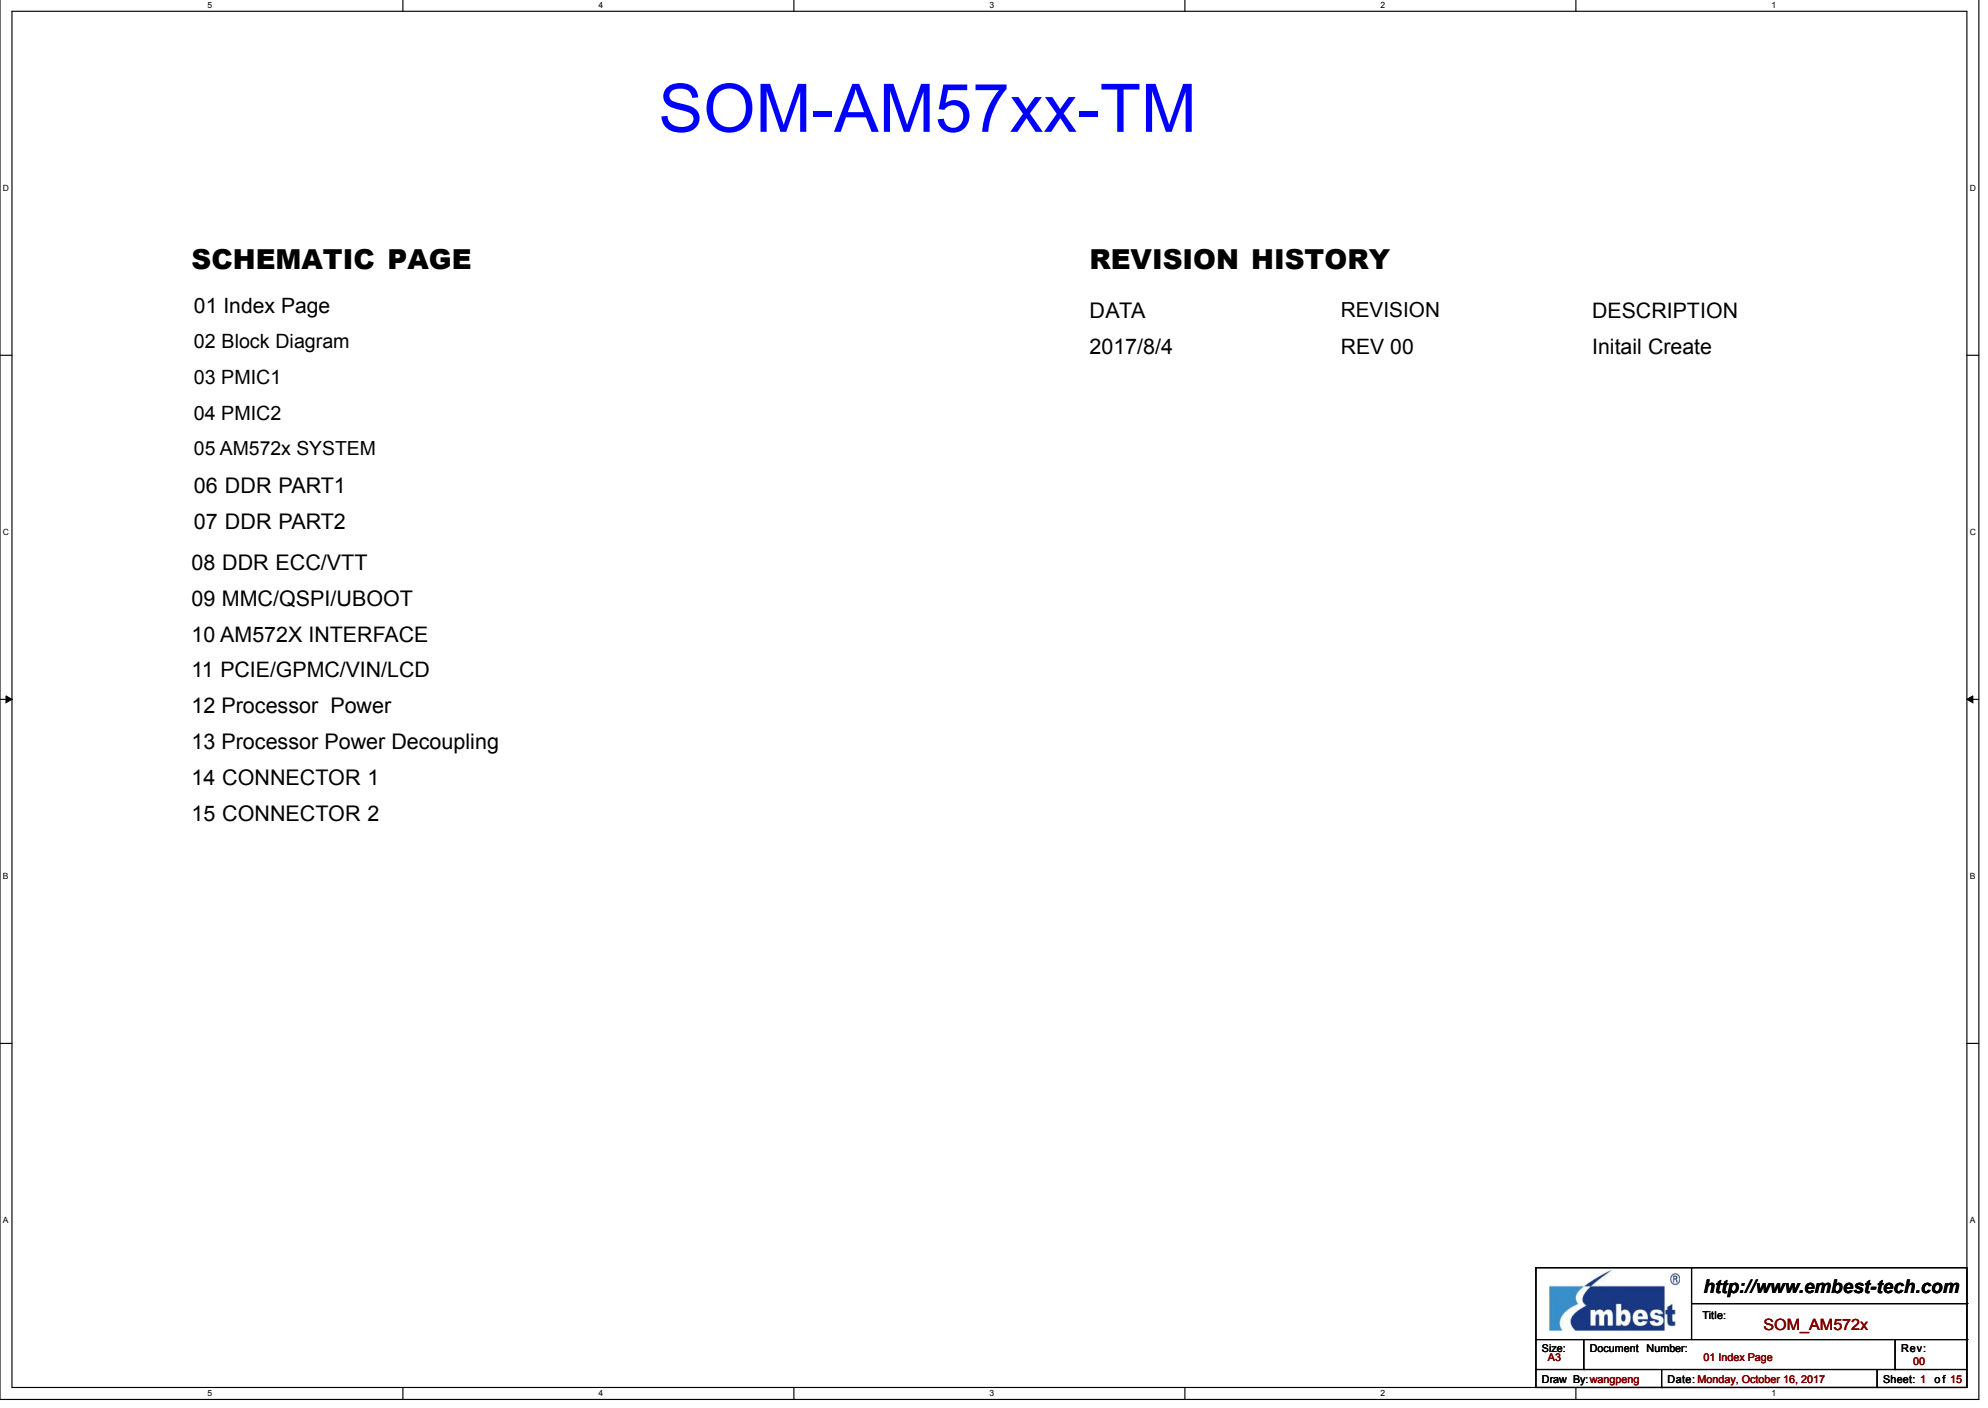
[picture p82: page 1]
07 DDR PART2; 06 DDR PART1; 04 PMIC2; 03 PMIC1; 05 AM572x SYSTEM; 02 Block Diagram; 01 Index Page; REVISION HISTORY; DATA; REVISION; DESCRIPTION; REV 00; Initail Create; Title:; Size:; Document Number:; Rev:; Draw By:; Date:; Sheet:; SOM_AM572x; wangpeng; Monday, October 16, 2017

08 DDR ECC/VTT
09 MMC/QSPI/UBOOT
10 AM572X INTERFACE
11 PCIE/GPMC/VIN/LCD
12 Processor Power
13 Processor Power Decoupling
14 CONNECTOR 1
15 CONNECTOR 2

http://www.embest-tech.com

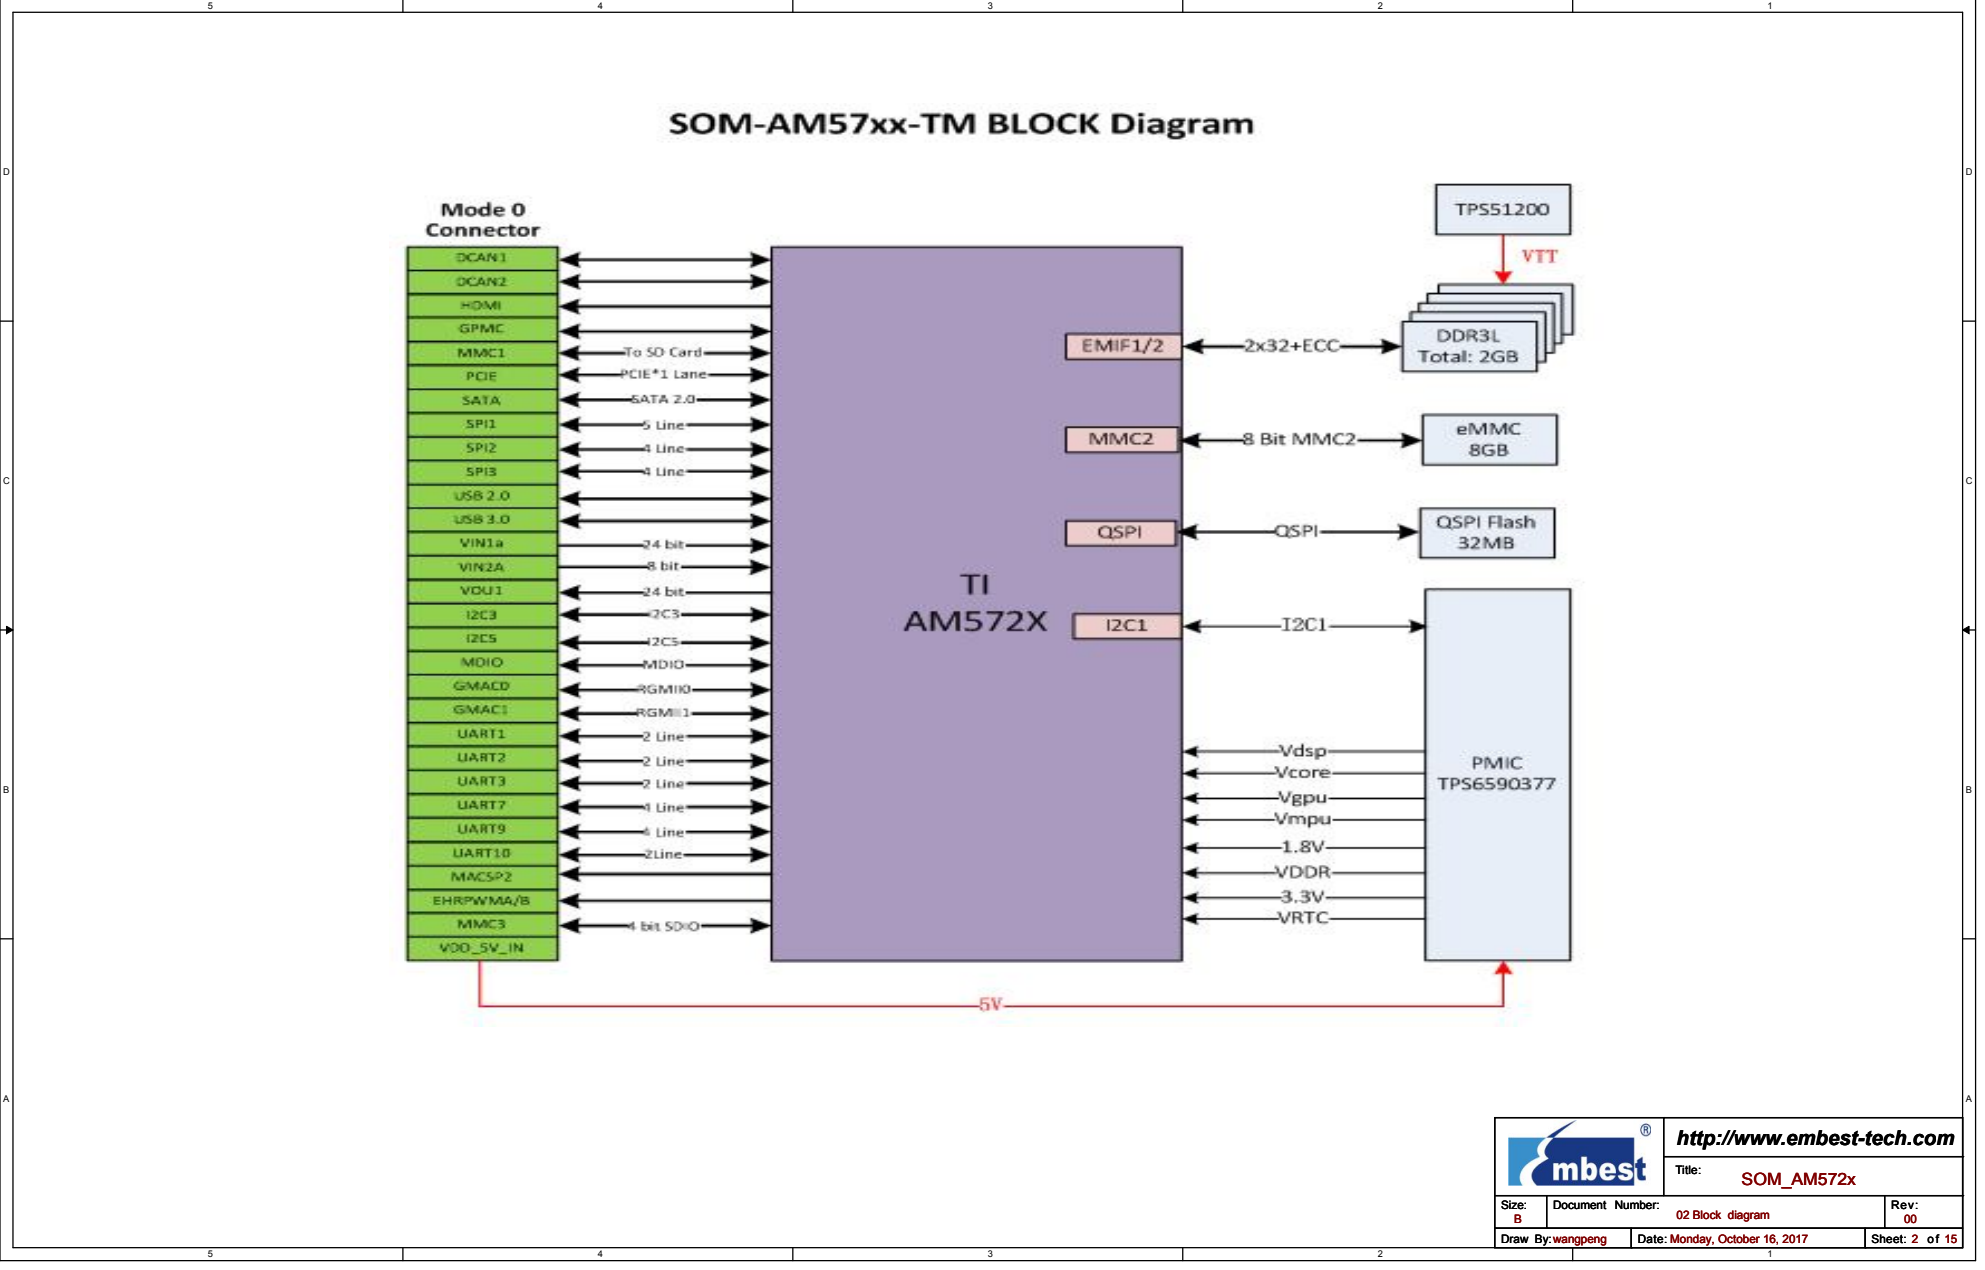
[picture p83: page 2]
Title:; Size:; Document Number:; Rev:; Draw By:; Date:; Sheet:; 02 Block diagram; SOM_AM572x; wangpeng; Monday, October 16, 2017

http://www.embest-tech.com

D | D

16.348MHZ,CL=10PF,

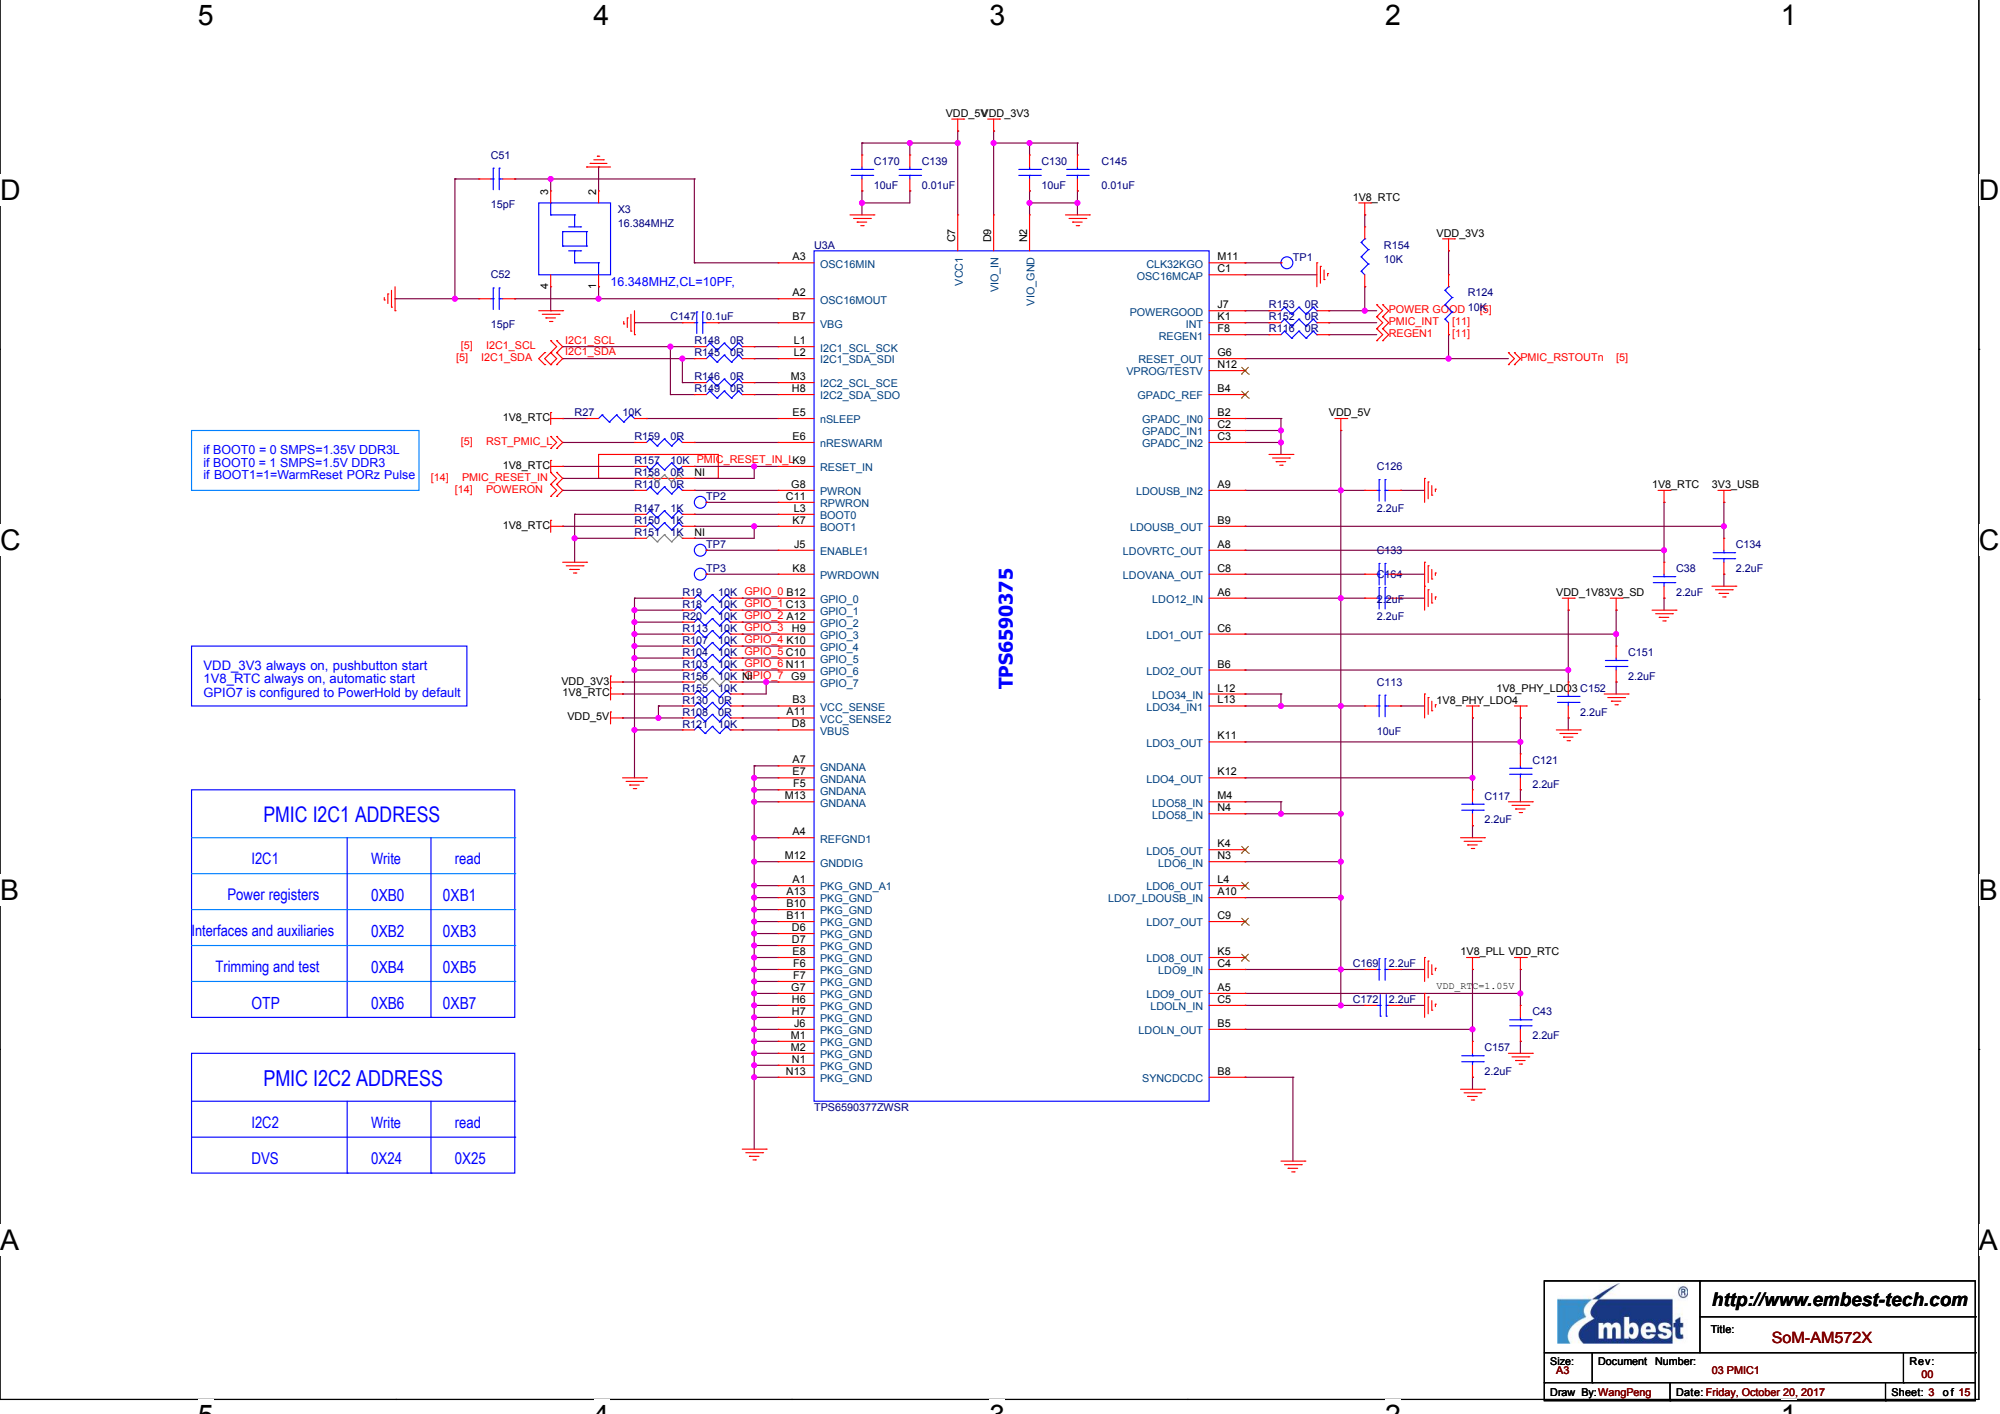
[picture p84: page 3]

if BOOT0 = 0 SMPS=1.35V DDR3L
if BOOT0 = 1 SMPS=1.5V DDR3
if BOOT1=1=WarmReset PORz Pulse

VDD_3V3 always on, pushbutton start
1V8_RTC always on, automatic start
GPIO7 is configured to PowerHold by default

http://www.embest-tech.com

55

44

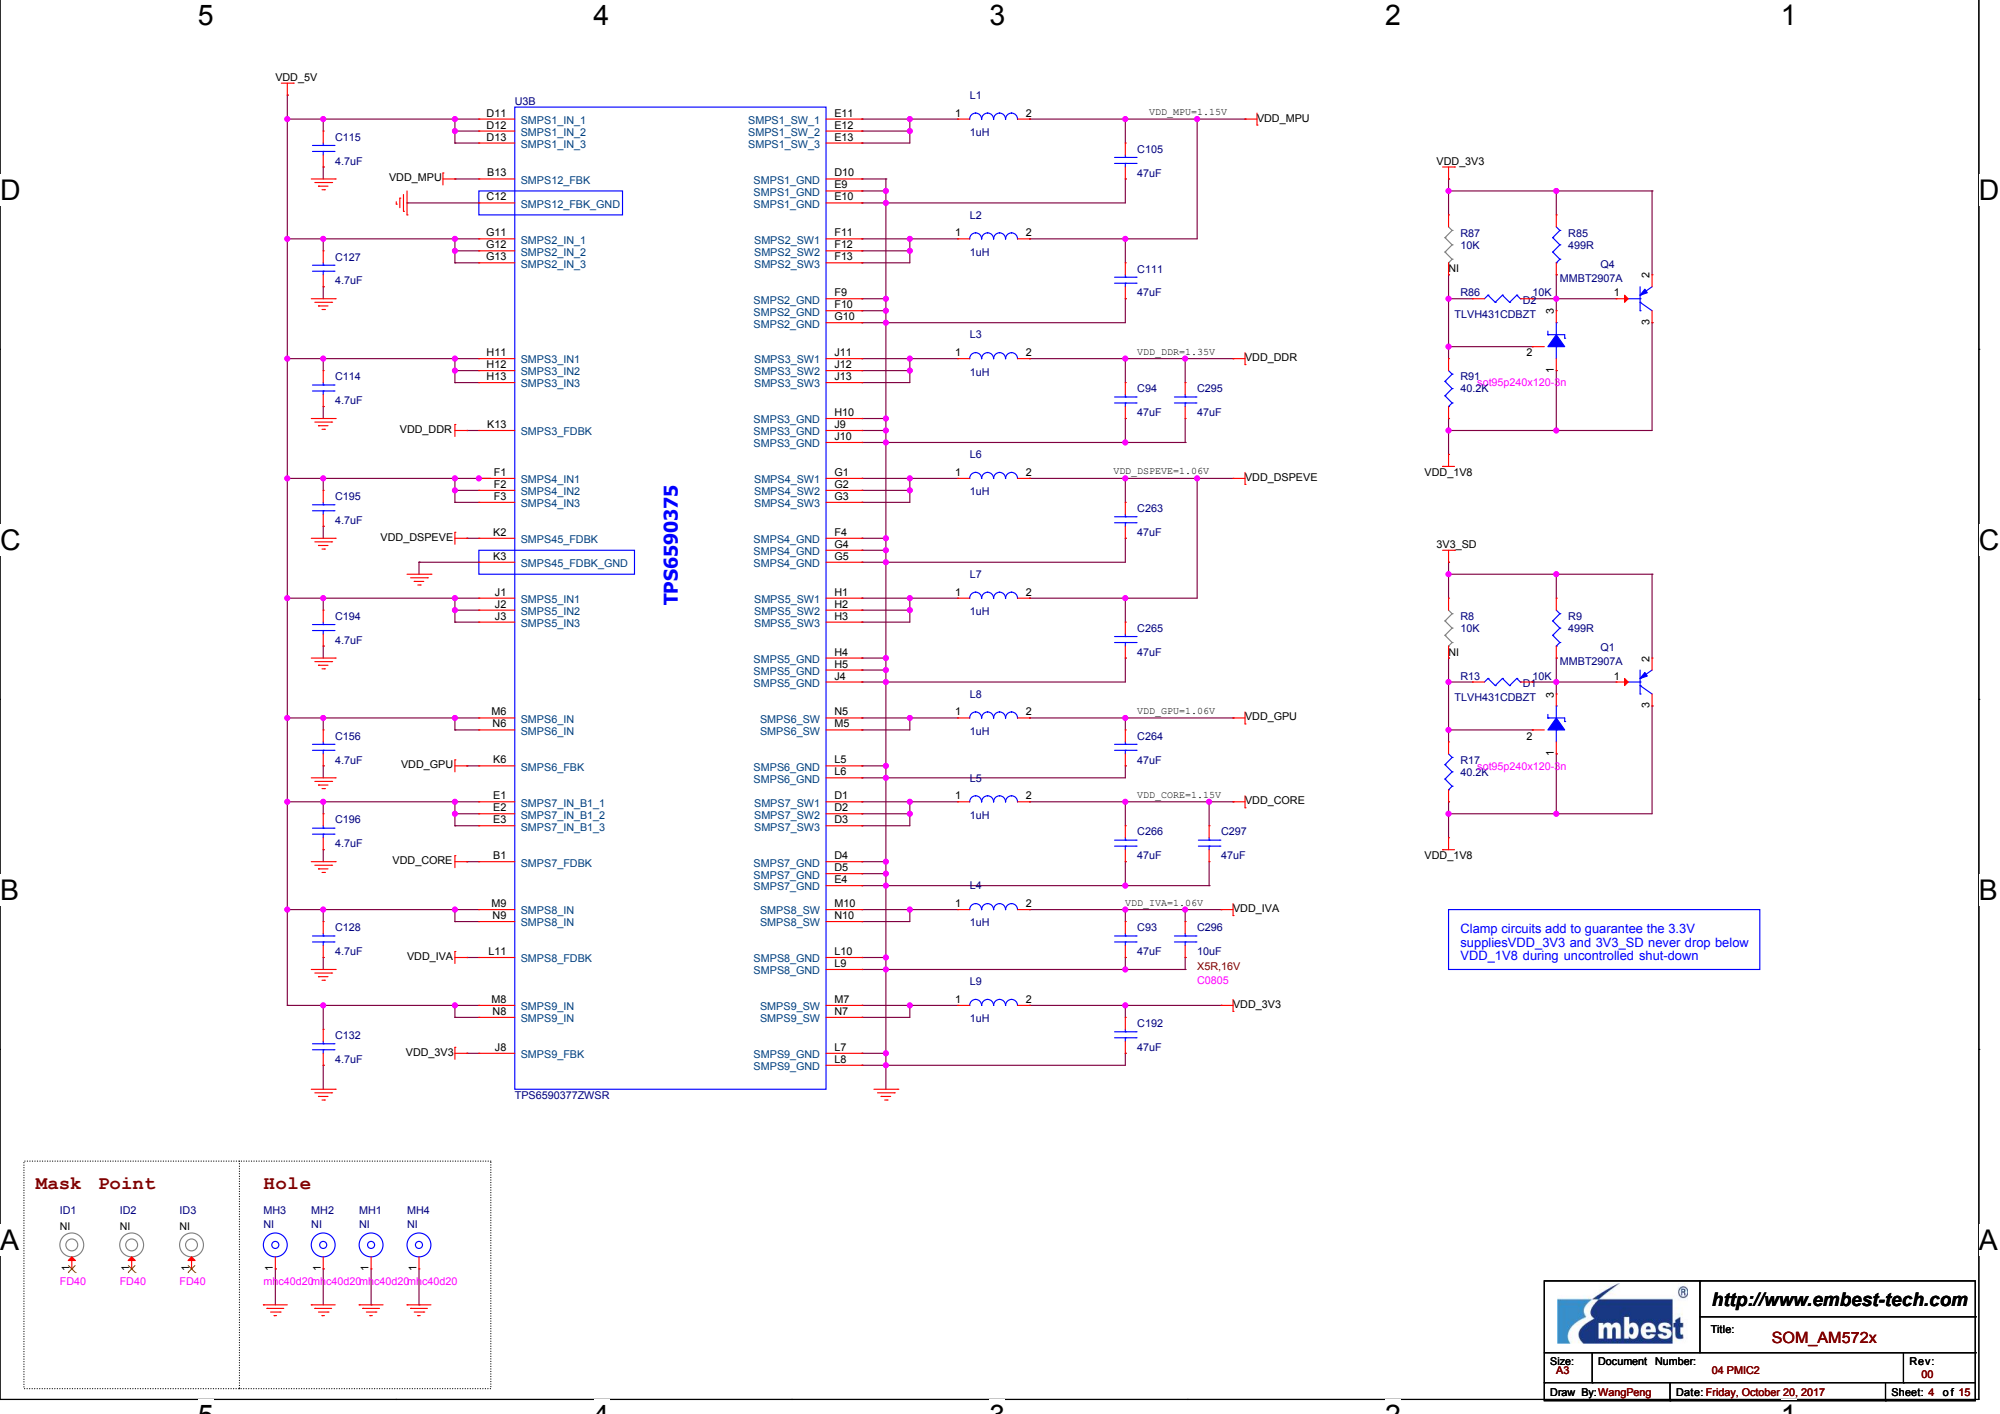
[picture p85: page 4]

Clamp circuits add to guarantee the 3.3V
suppliesVDD_3V3 and 3V3_SD never drop below
VDD_1V8 during uncontrolled shut-down

http://www.embest-tech.com

20MHZ,CL=18PF,

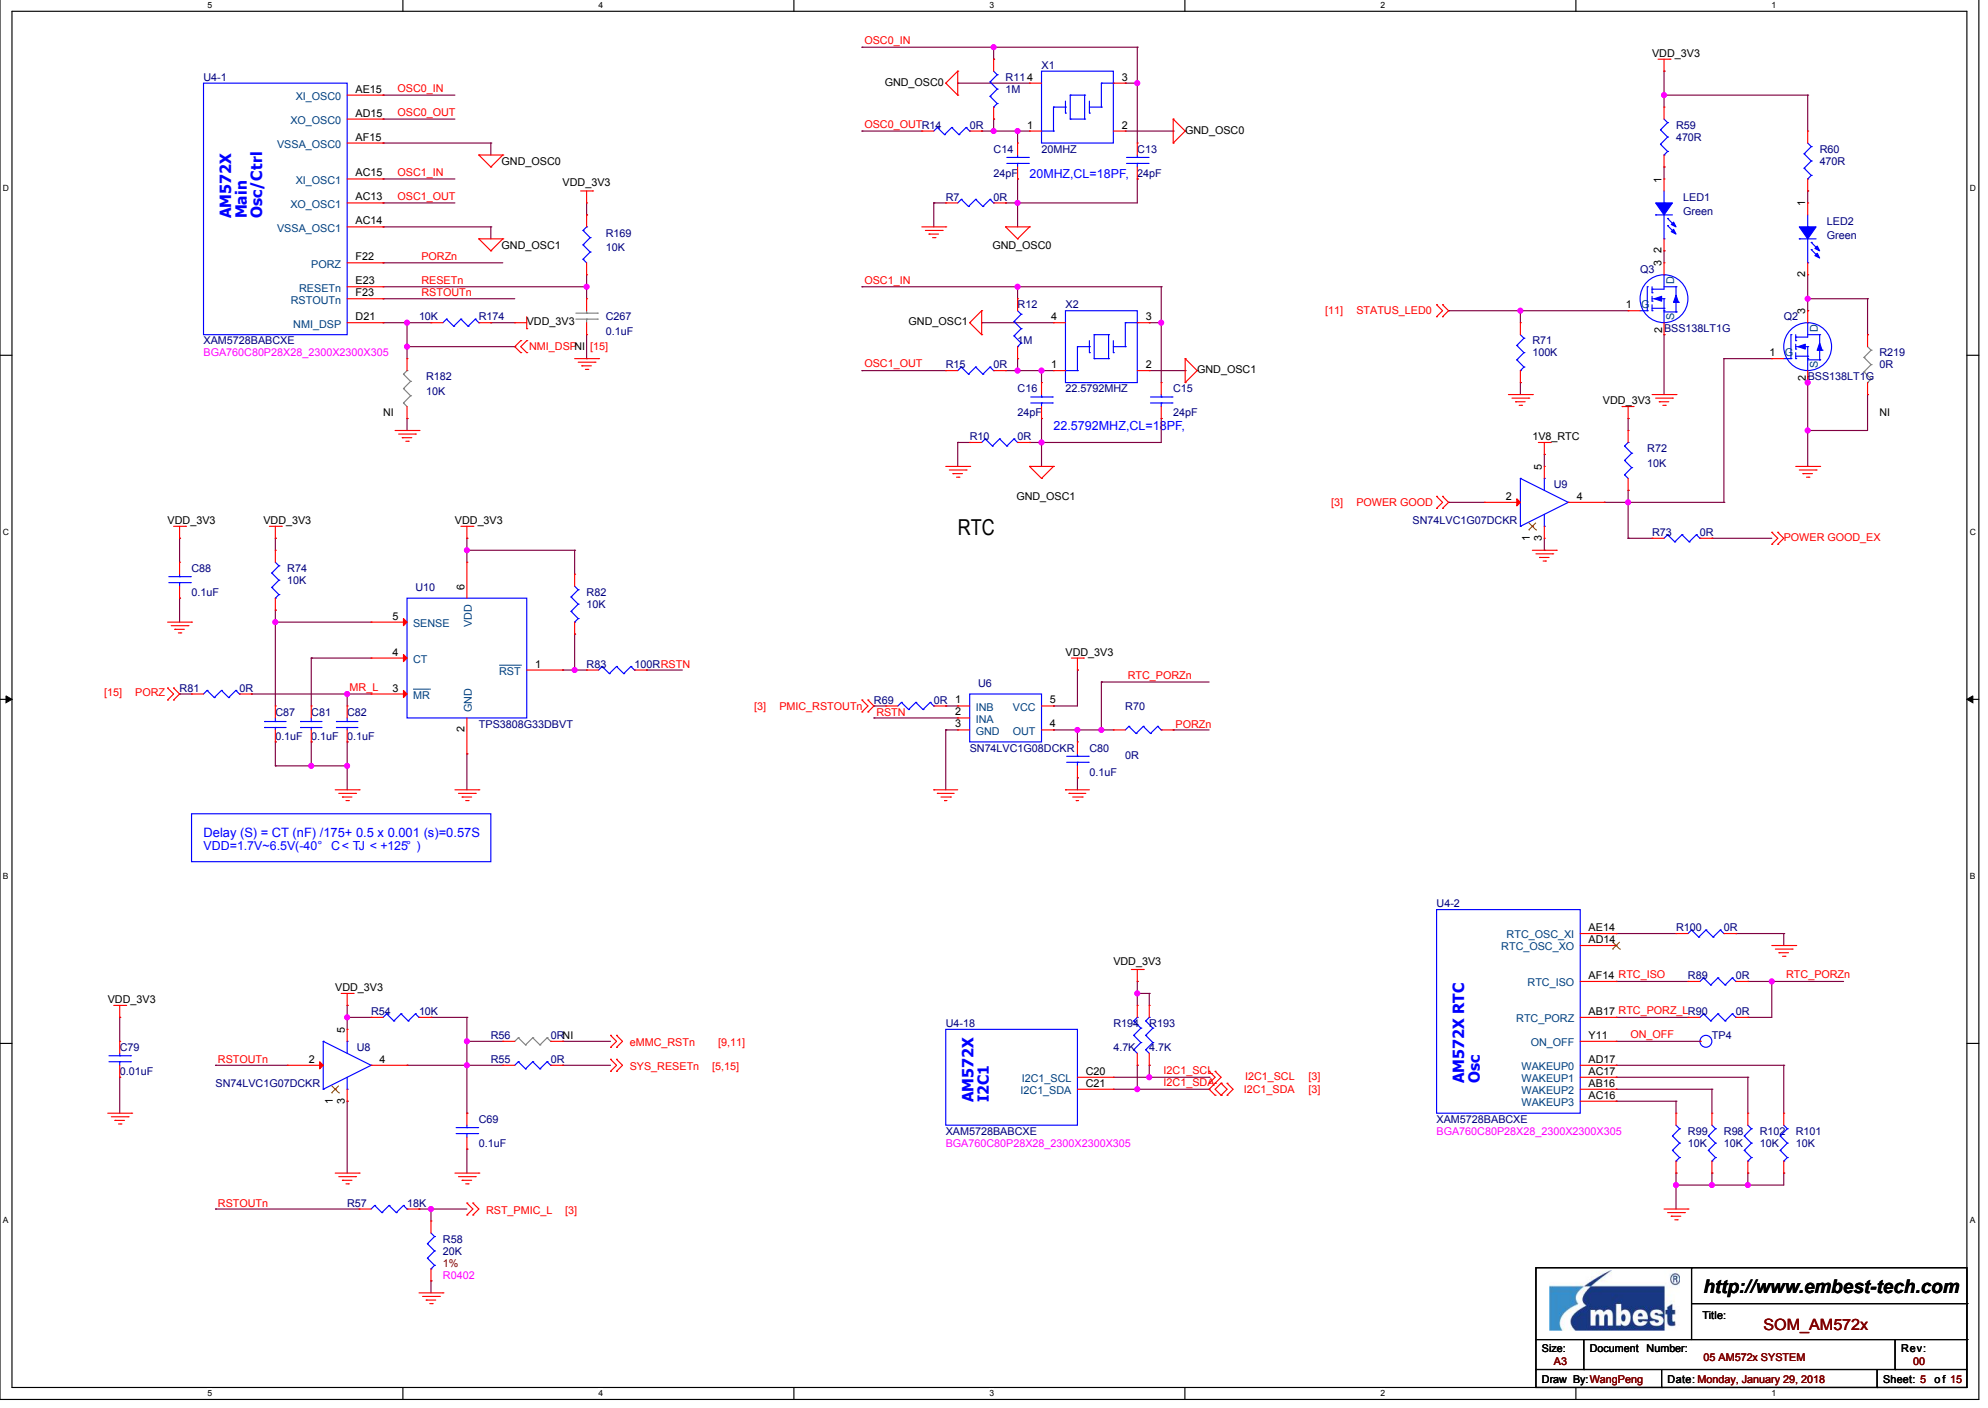
[picture p86: page 5]

http://www.embest-tech.com

D | D

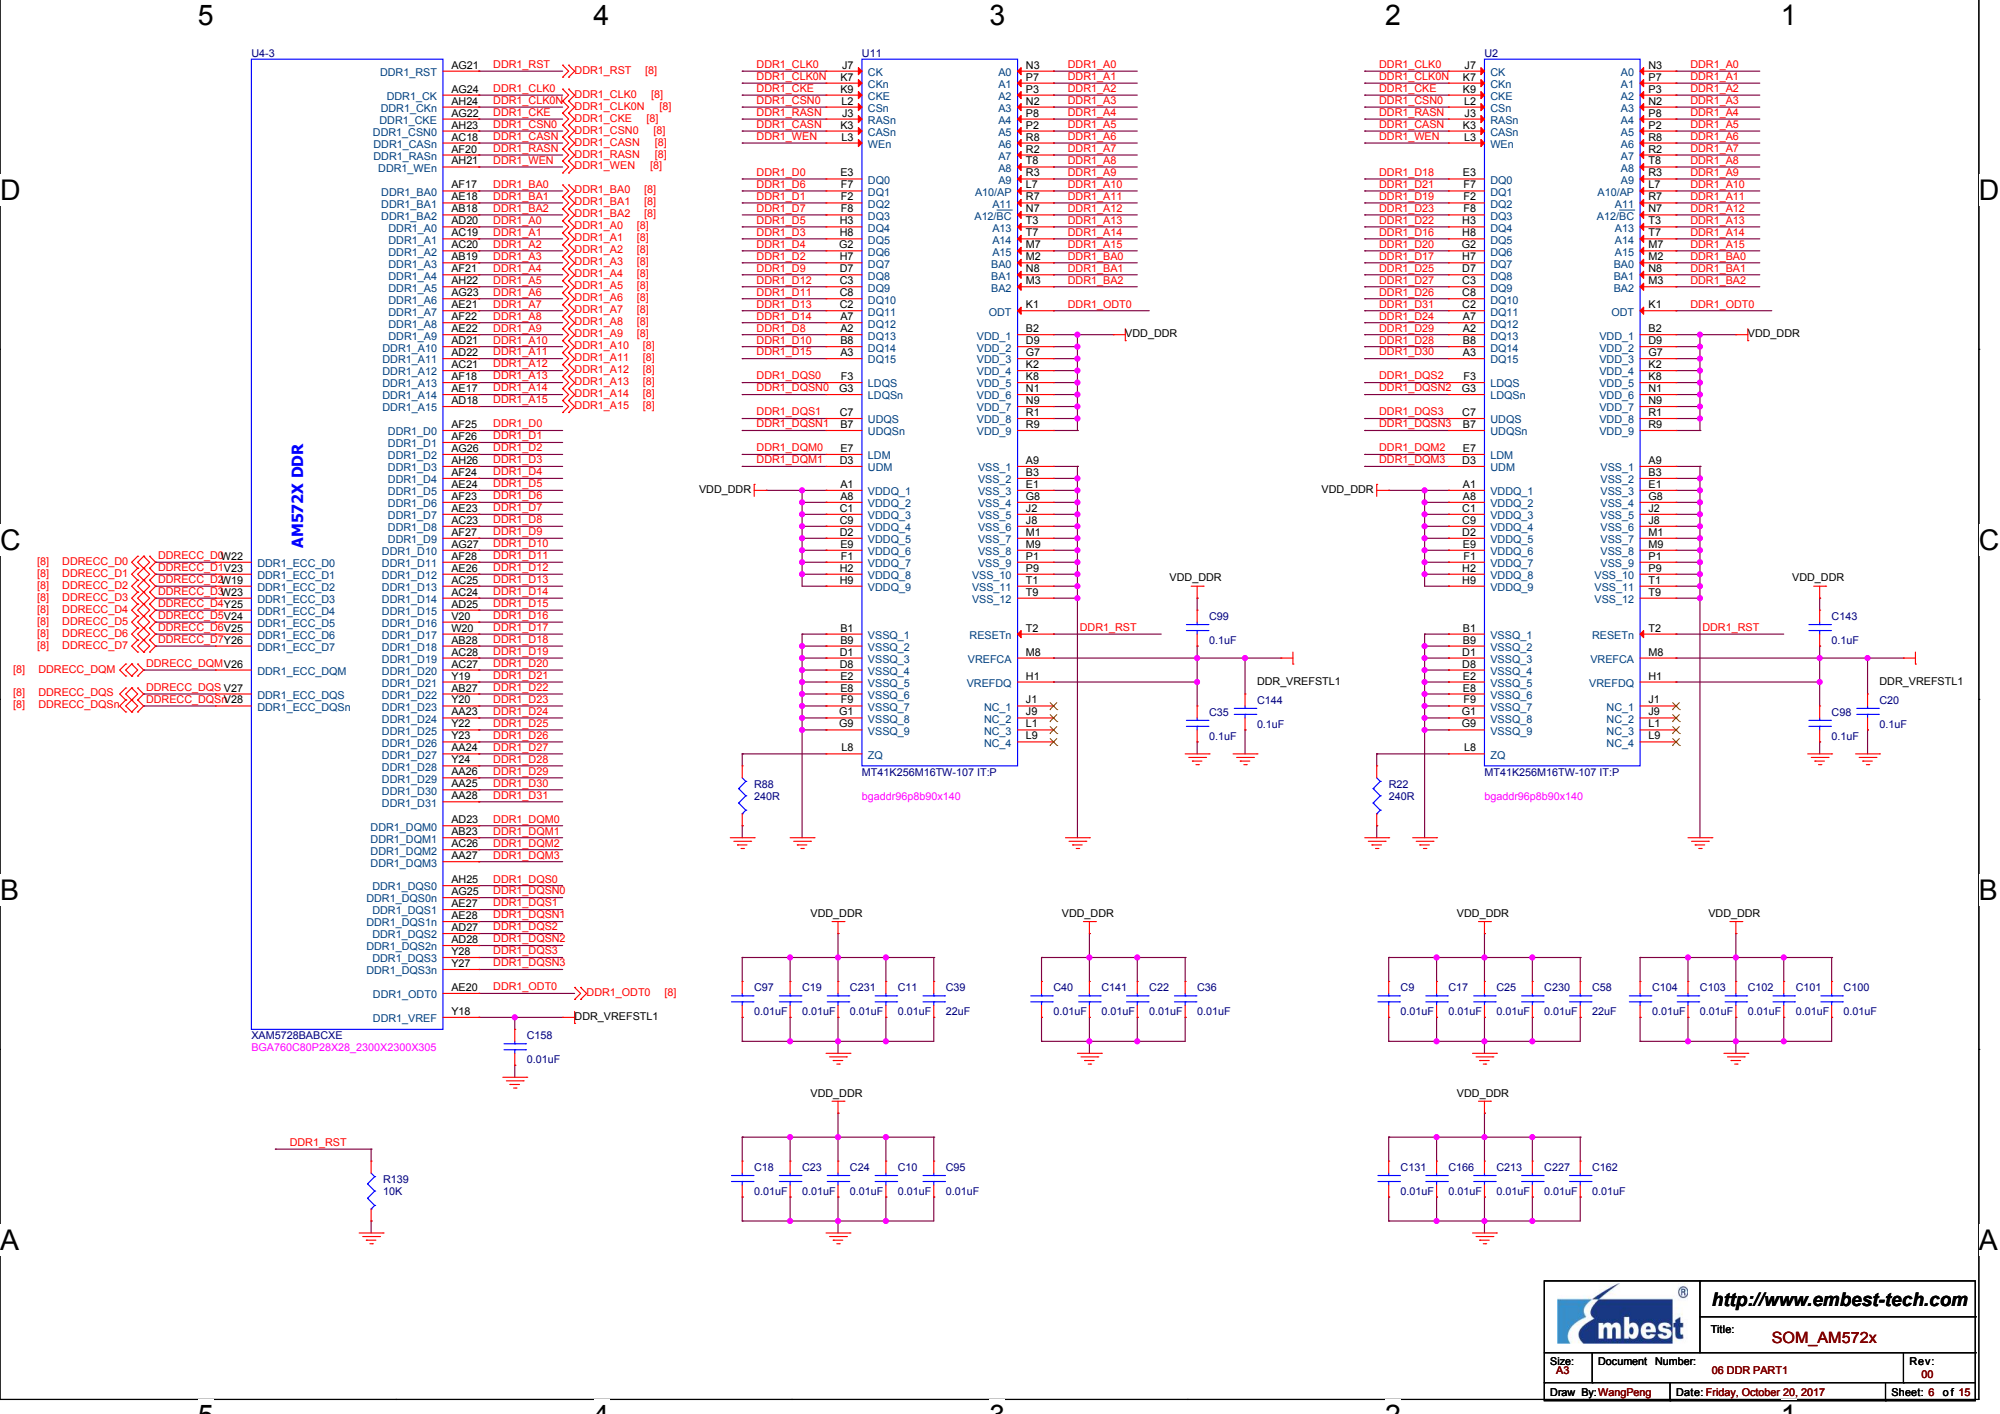
[picture p87: page 6]

http://www.embest-tech.com

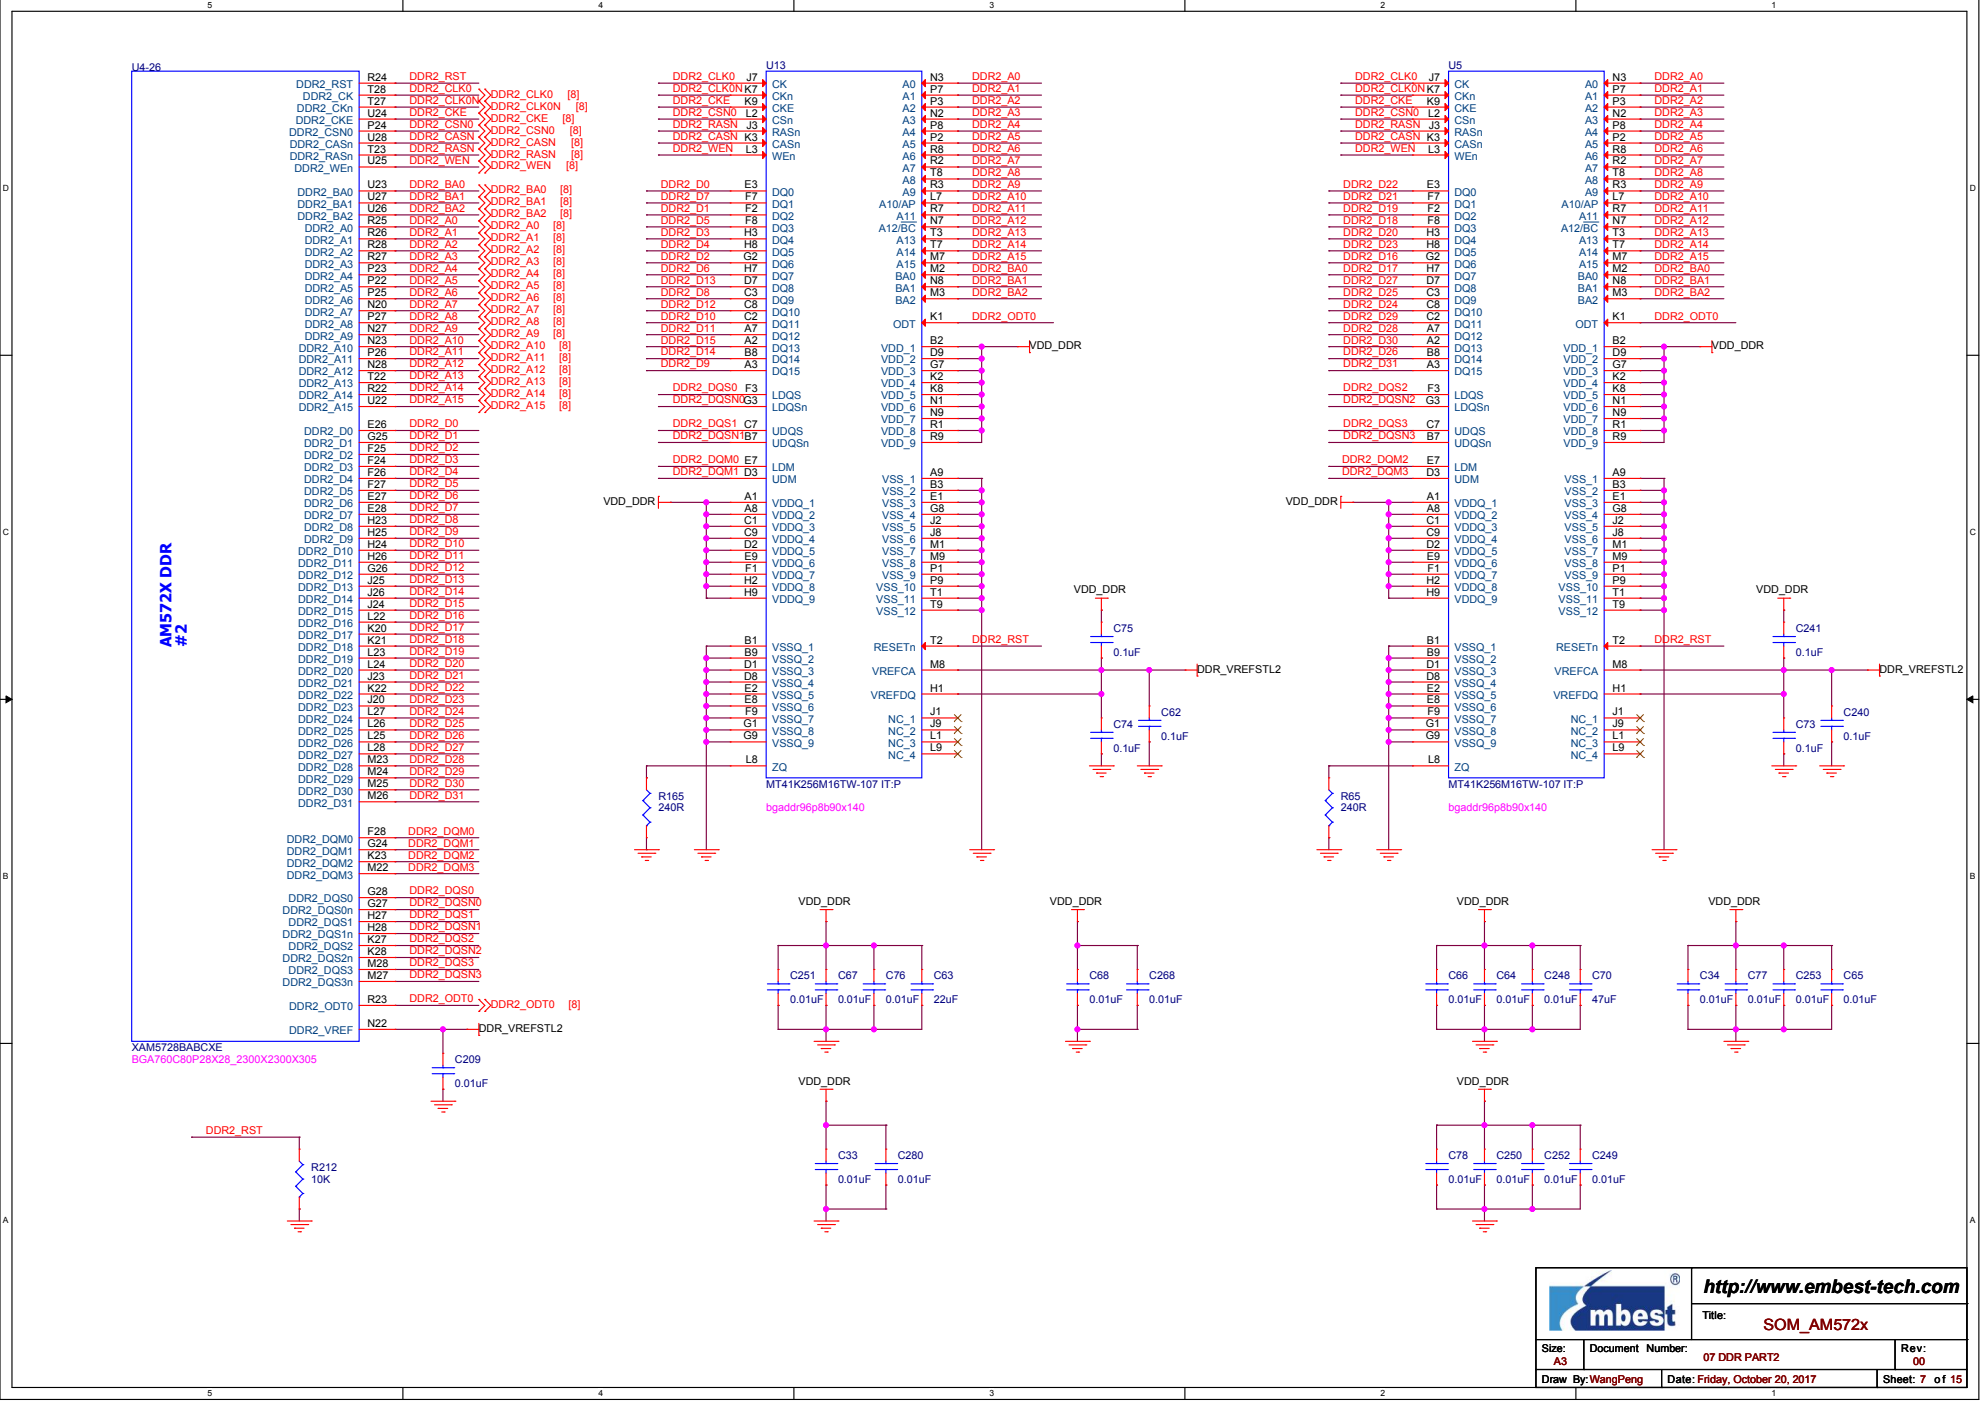
[picture p88: page 7]

http://www.embest-tech.com

ECC | VTT

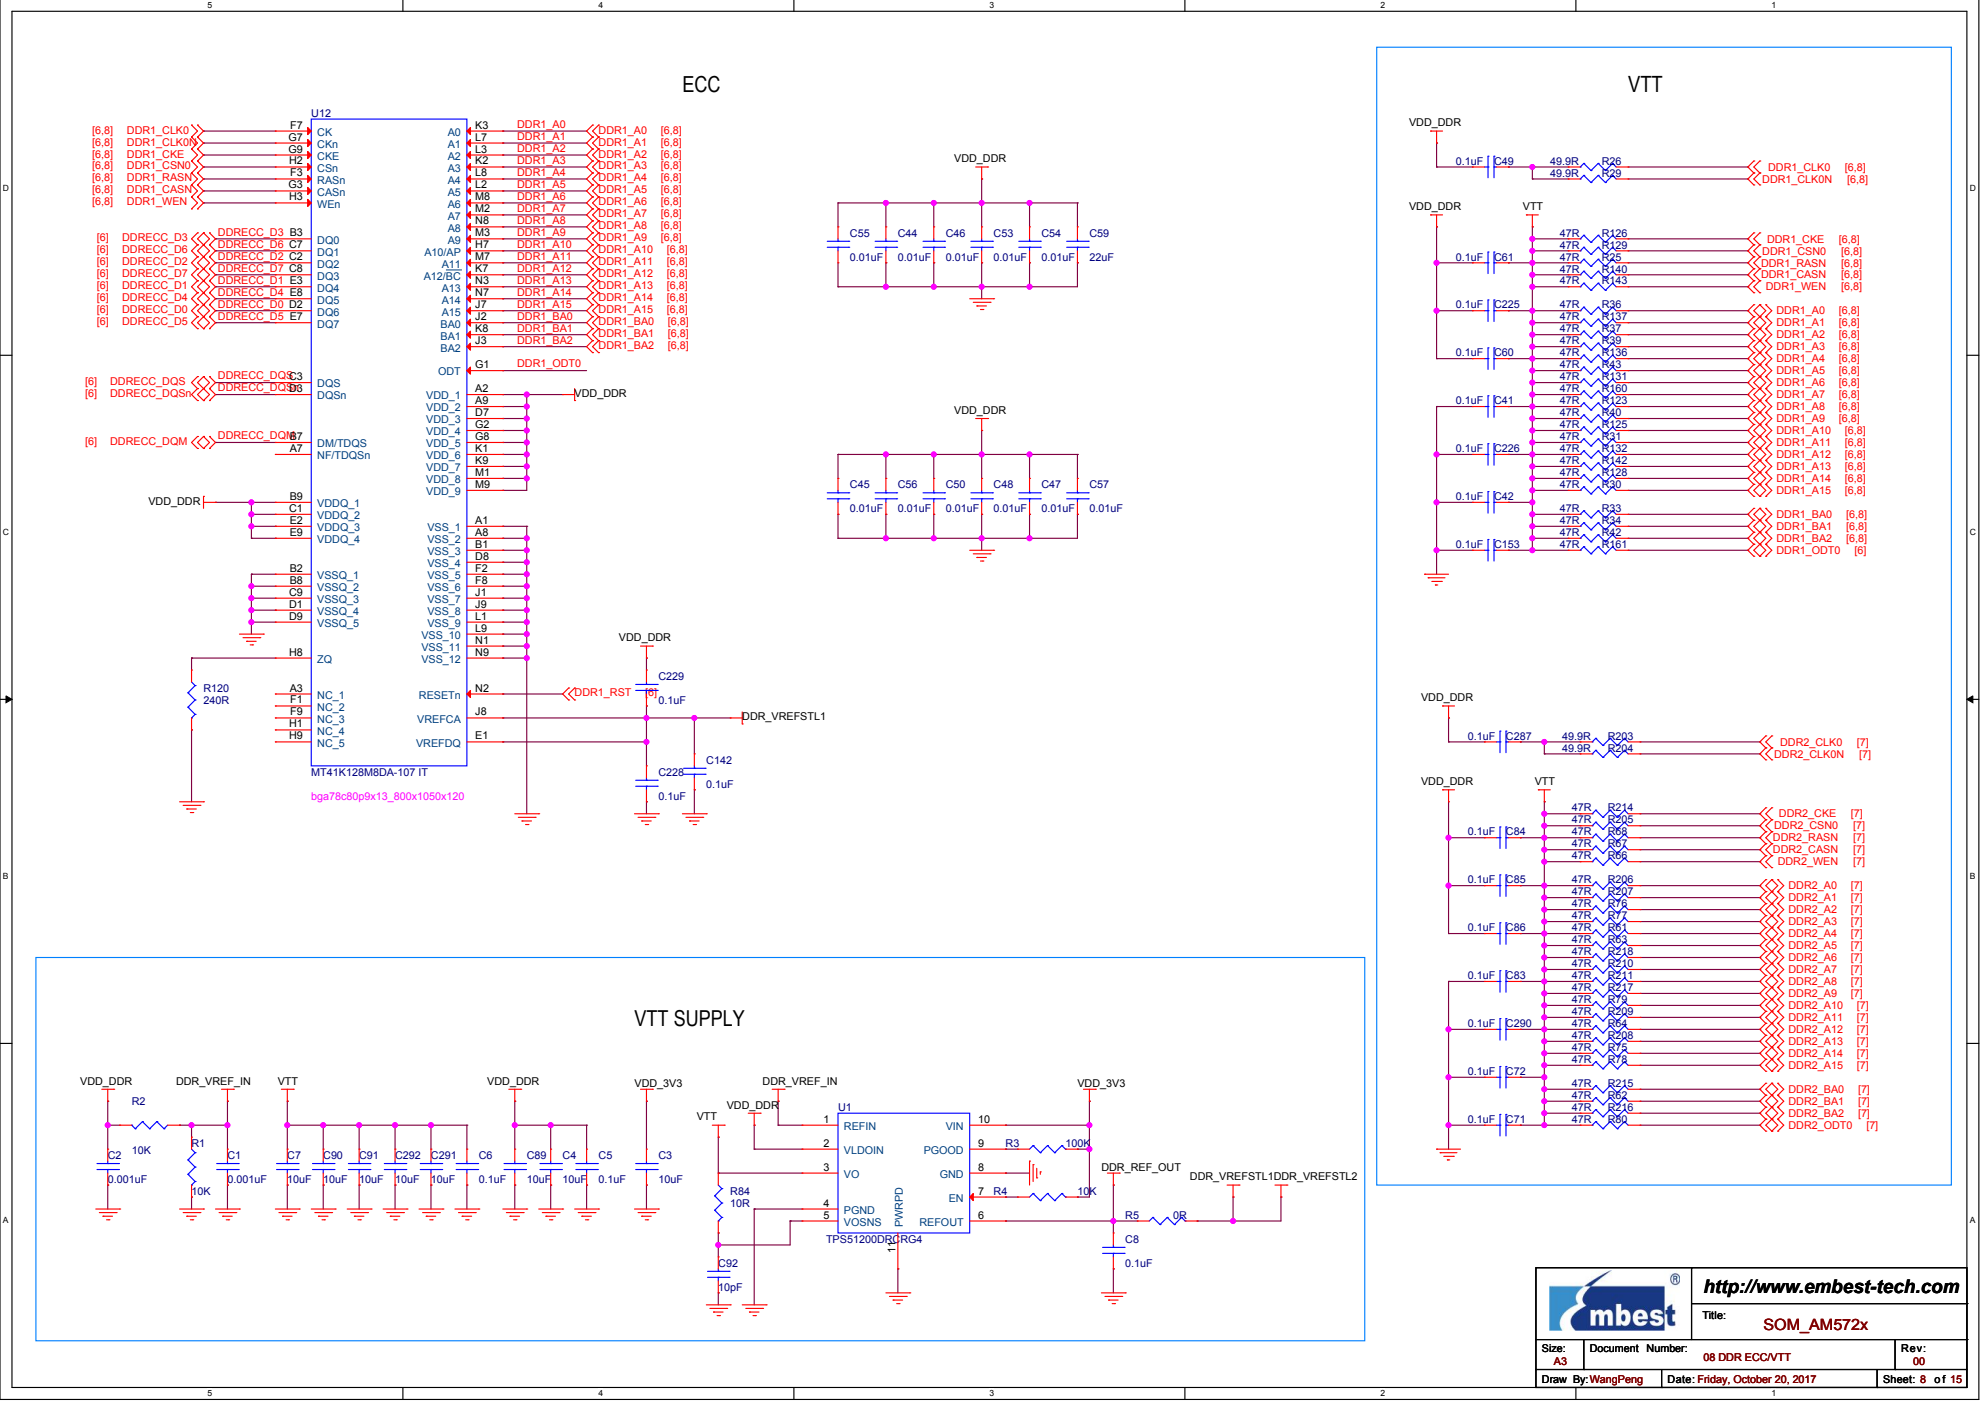
[picture p89: page 8]

http://www.embest-tech.com

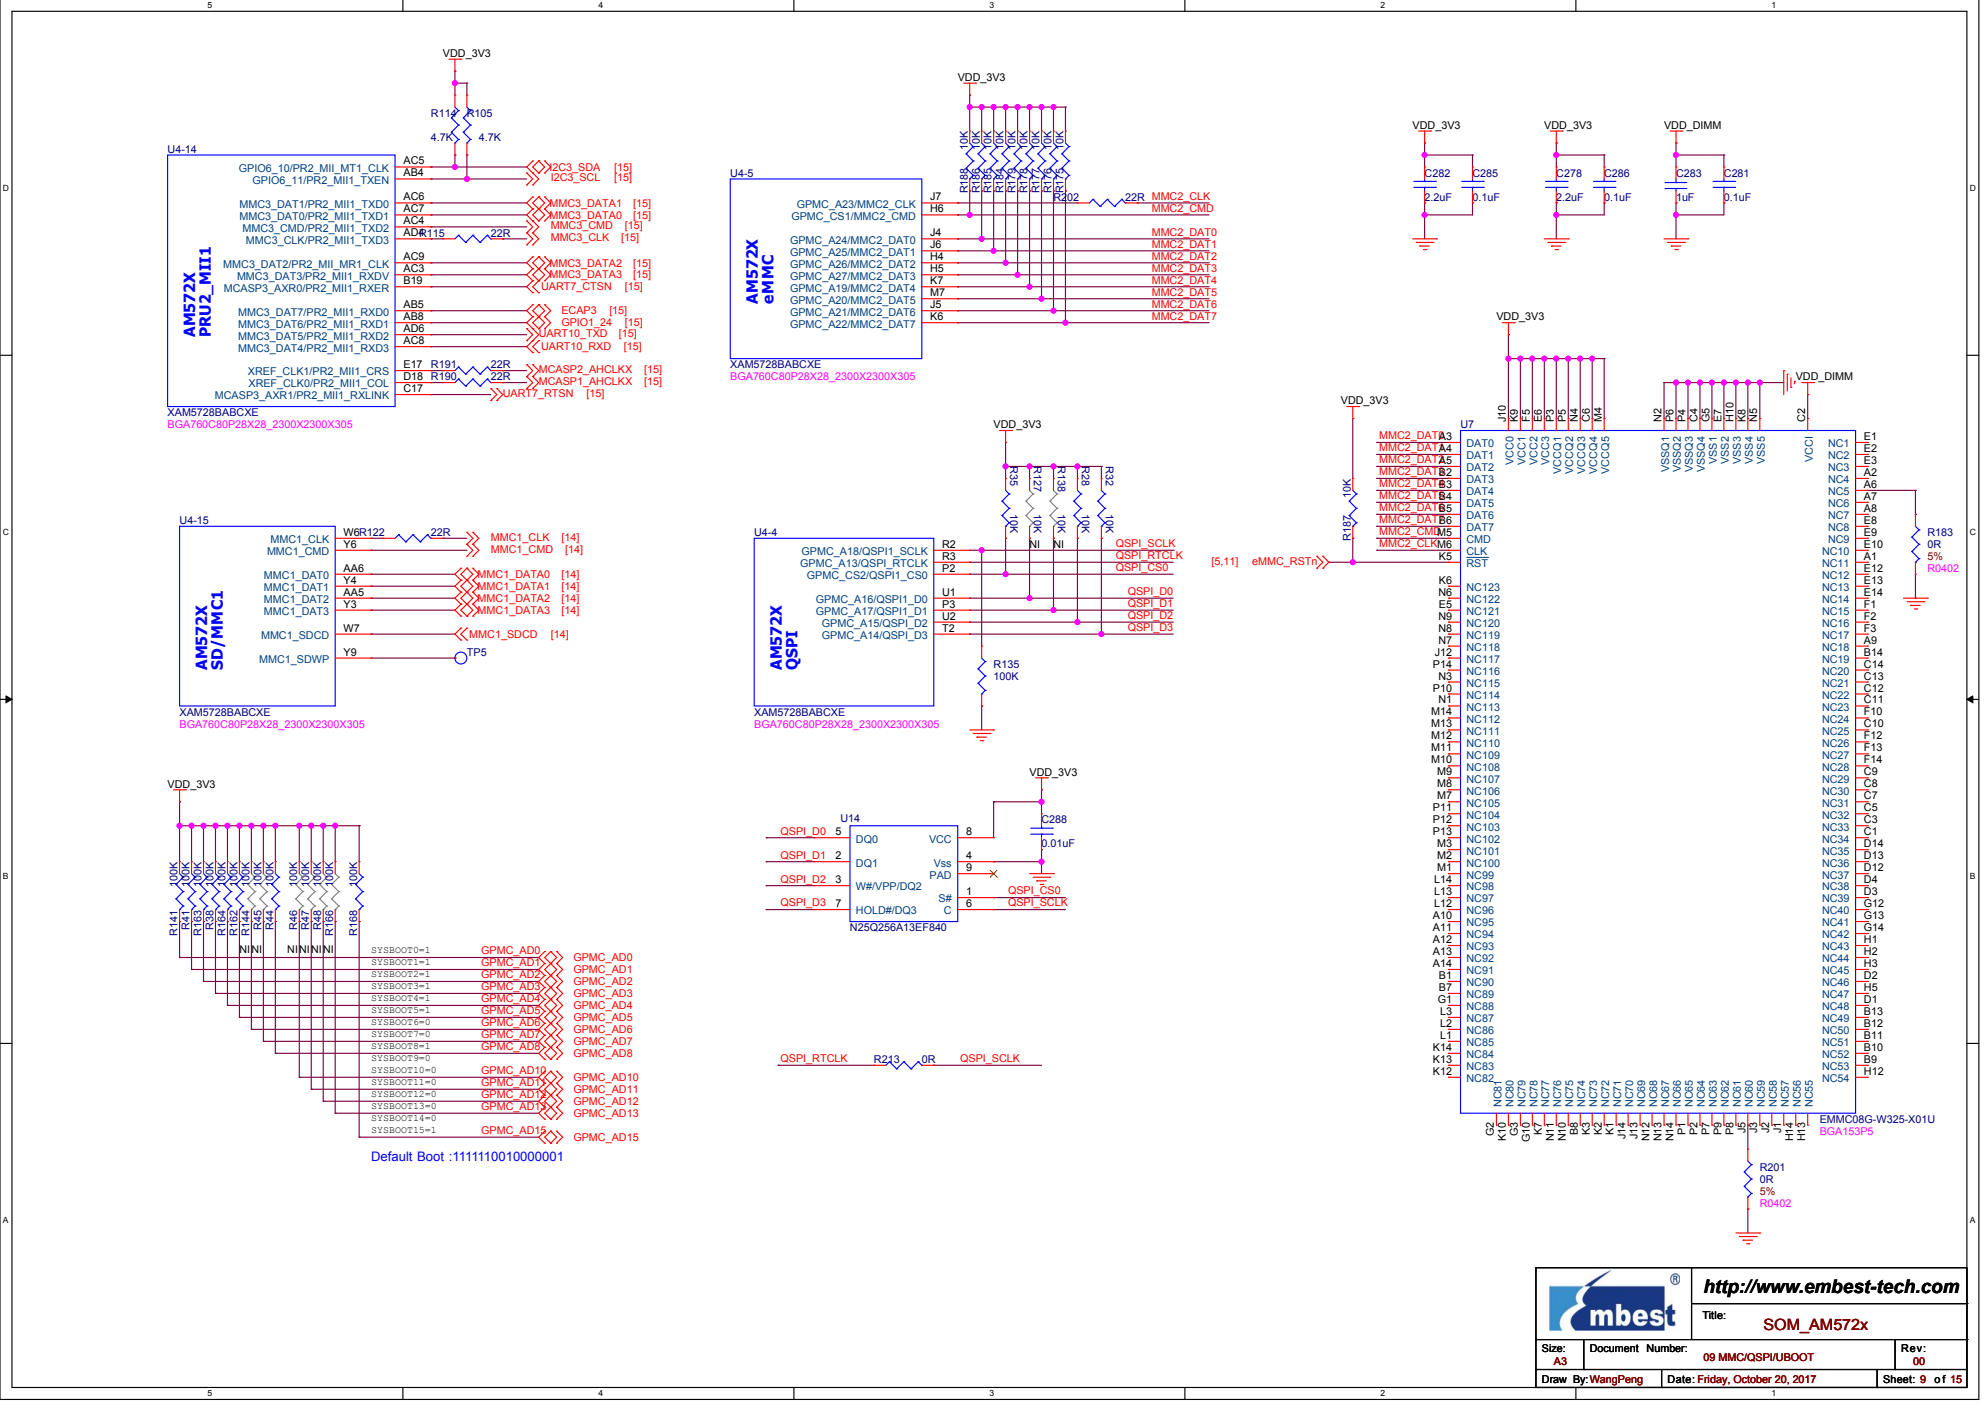
[picture p90: page 9]

http://www.embest-tech.com

D | D

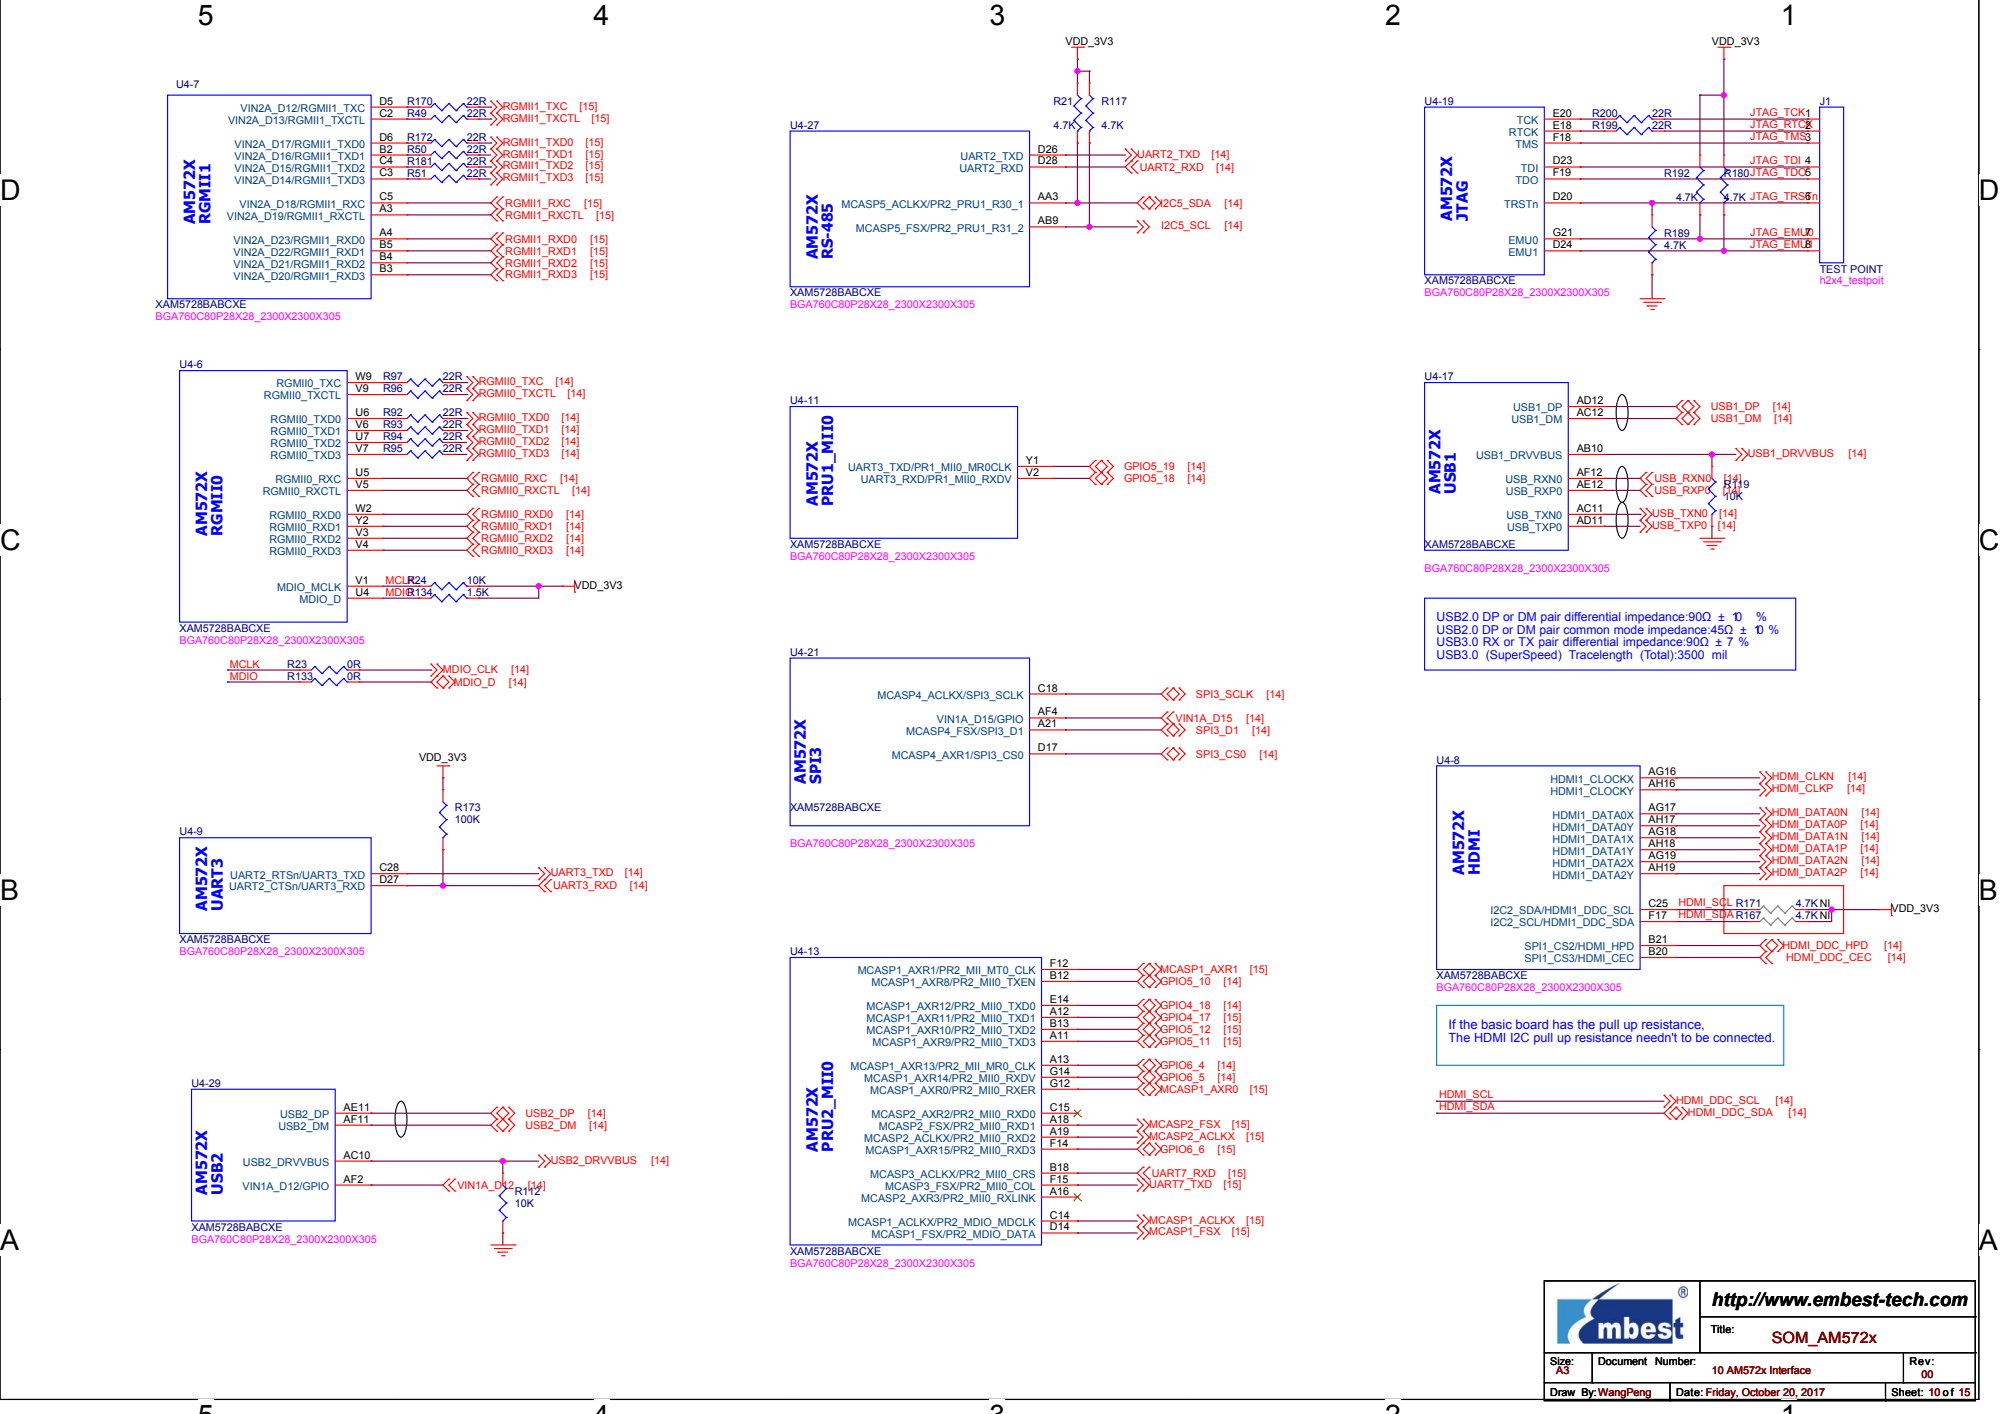
[picture p91: page 10]

USB2.0 DP or DM pair differential impedance:90Ω ± 10 %
USB2.0 DP or DM pair common mode impedance:45Ω ± 10 %
USB3.0 RX or TX pair differential impedance:90Ω ± 7 %
USB3.0 (SuperSpeed) Tracelength (Total):3500 mil

If the basic board has the pull up resistance,
The HDMI I2C pull up resistance needn't to be connected.

http://www.embest-tech.com

### SATA RX or TX pair differential impedance:100Ω ± 15 %

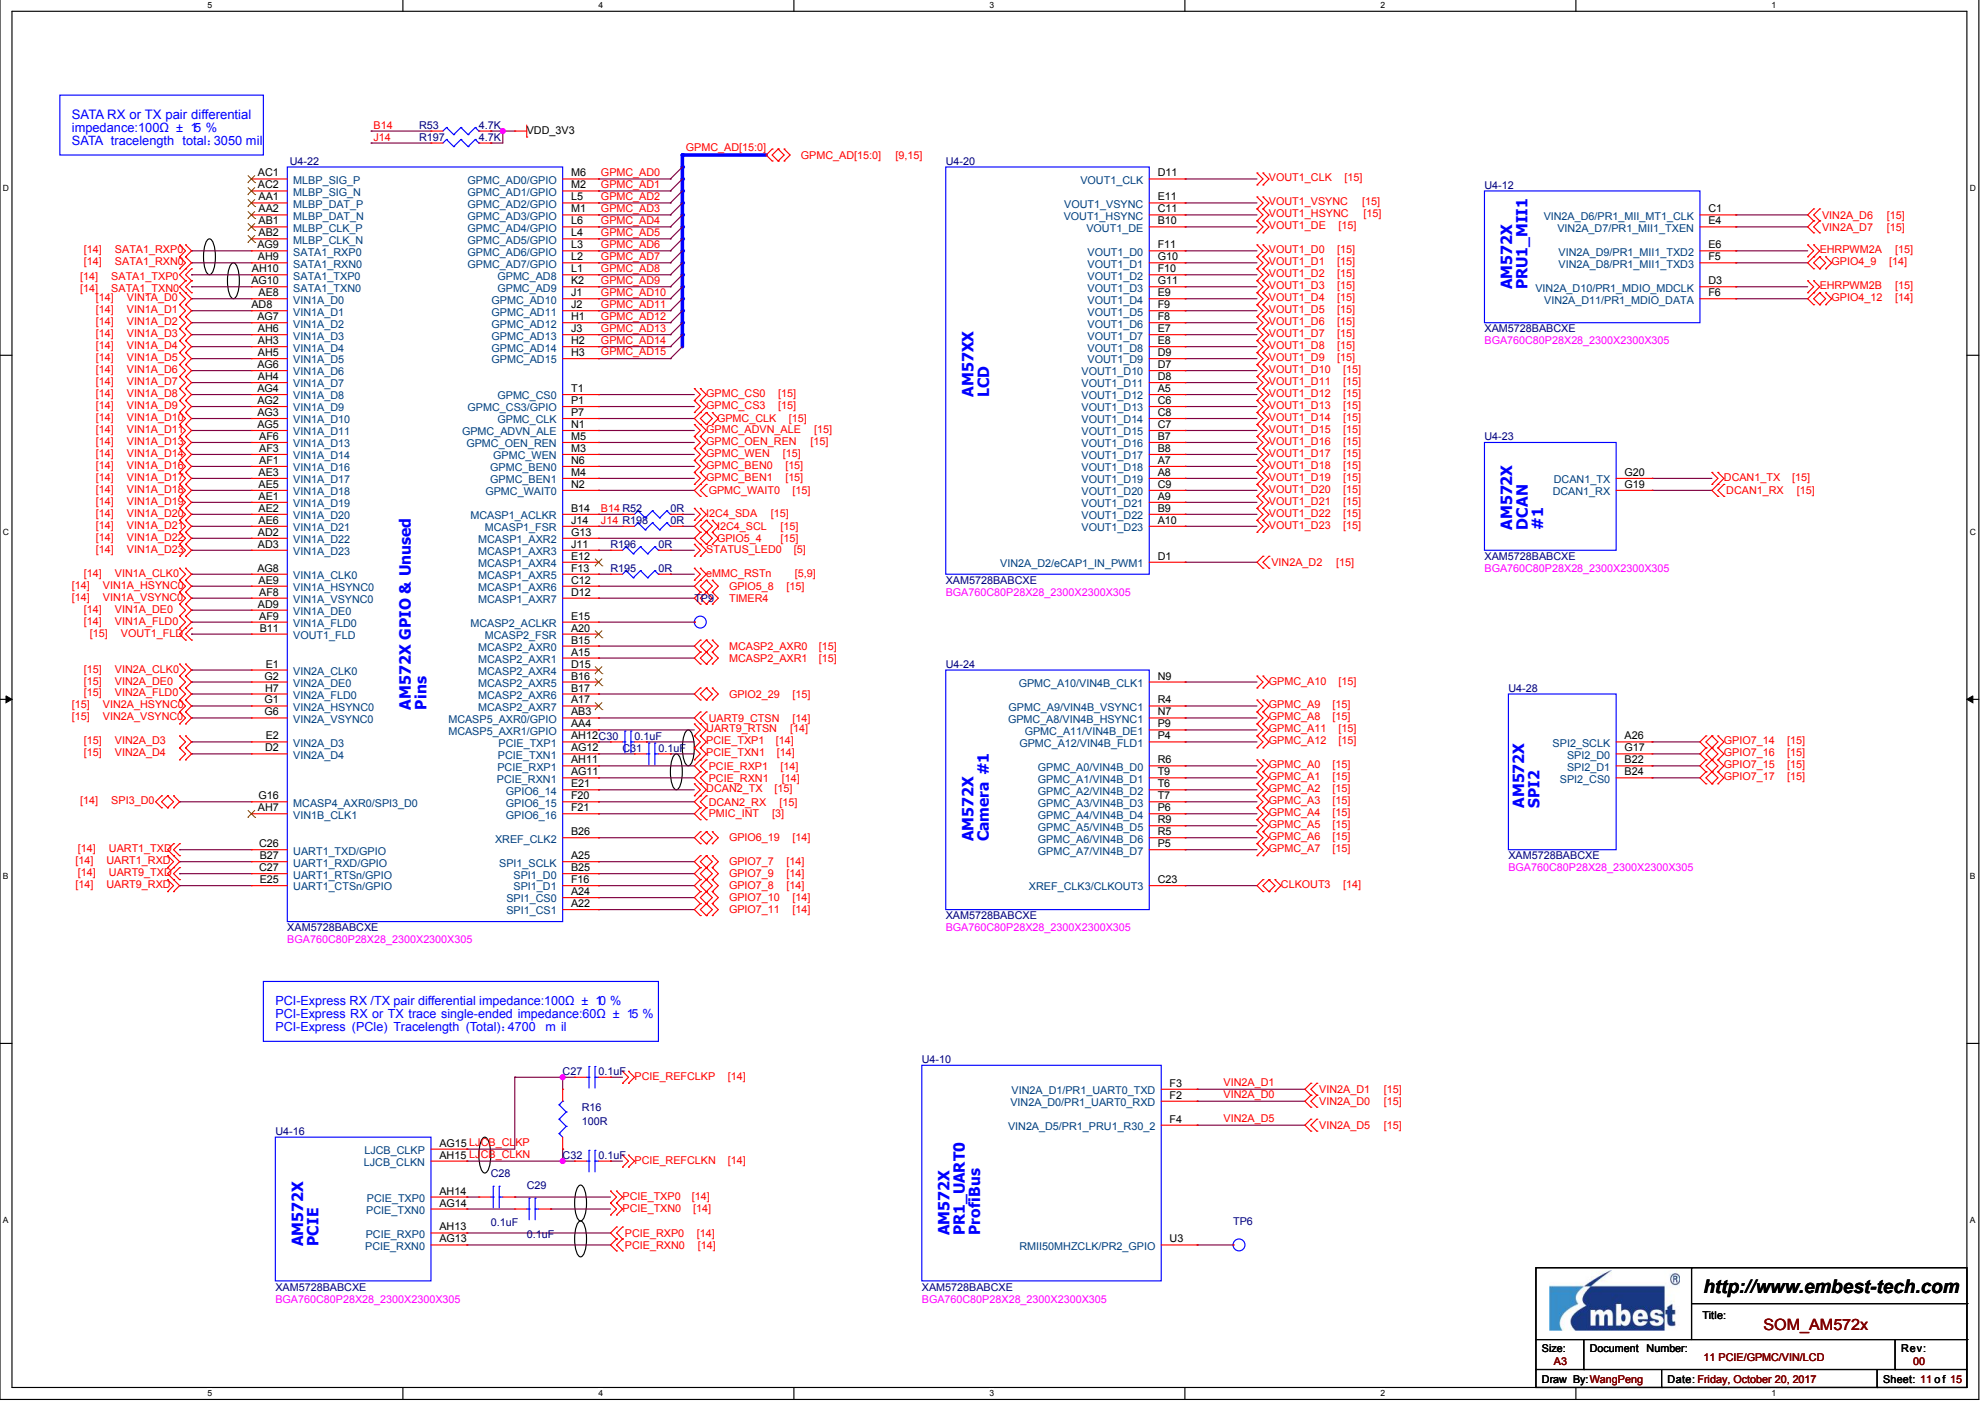
[picture p92: page 11]

SATA tracelength total：3050 m il

PCI-Express RX /TX pair differential impedance:100Ω ± 10 %
PCI-Express RX or TX trace single-ended impedance:60Ω ± 15 %
PCI-Express (PCle) Tracelength (Total)：4700 m il

http://www.embest-tech.com

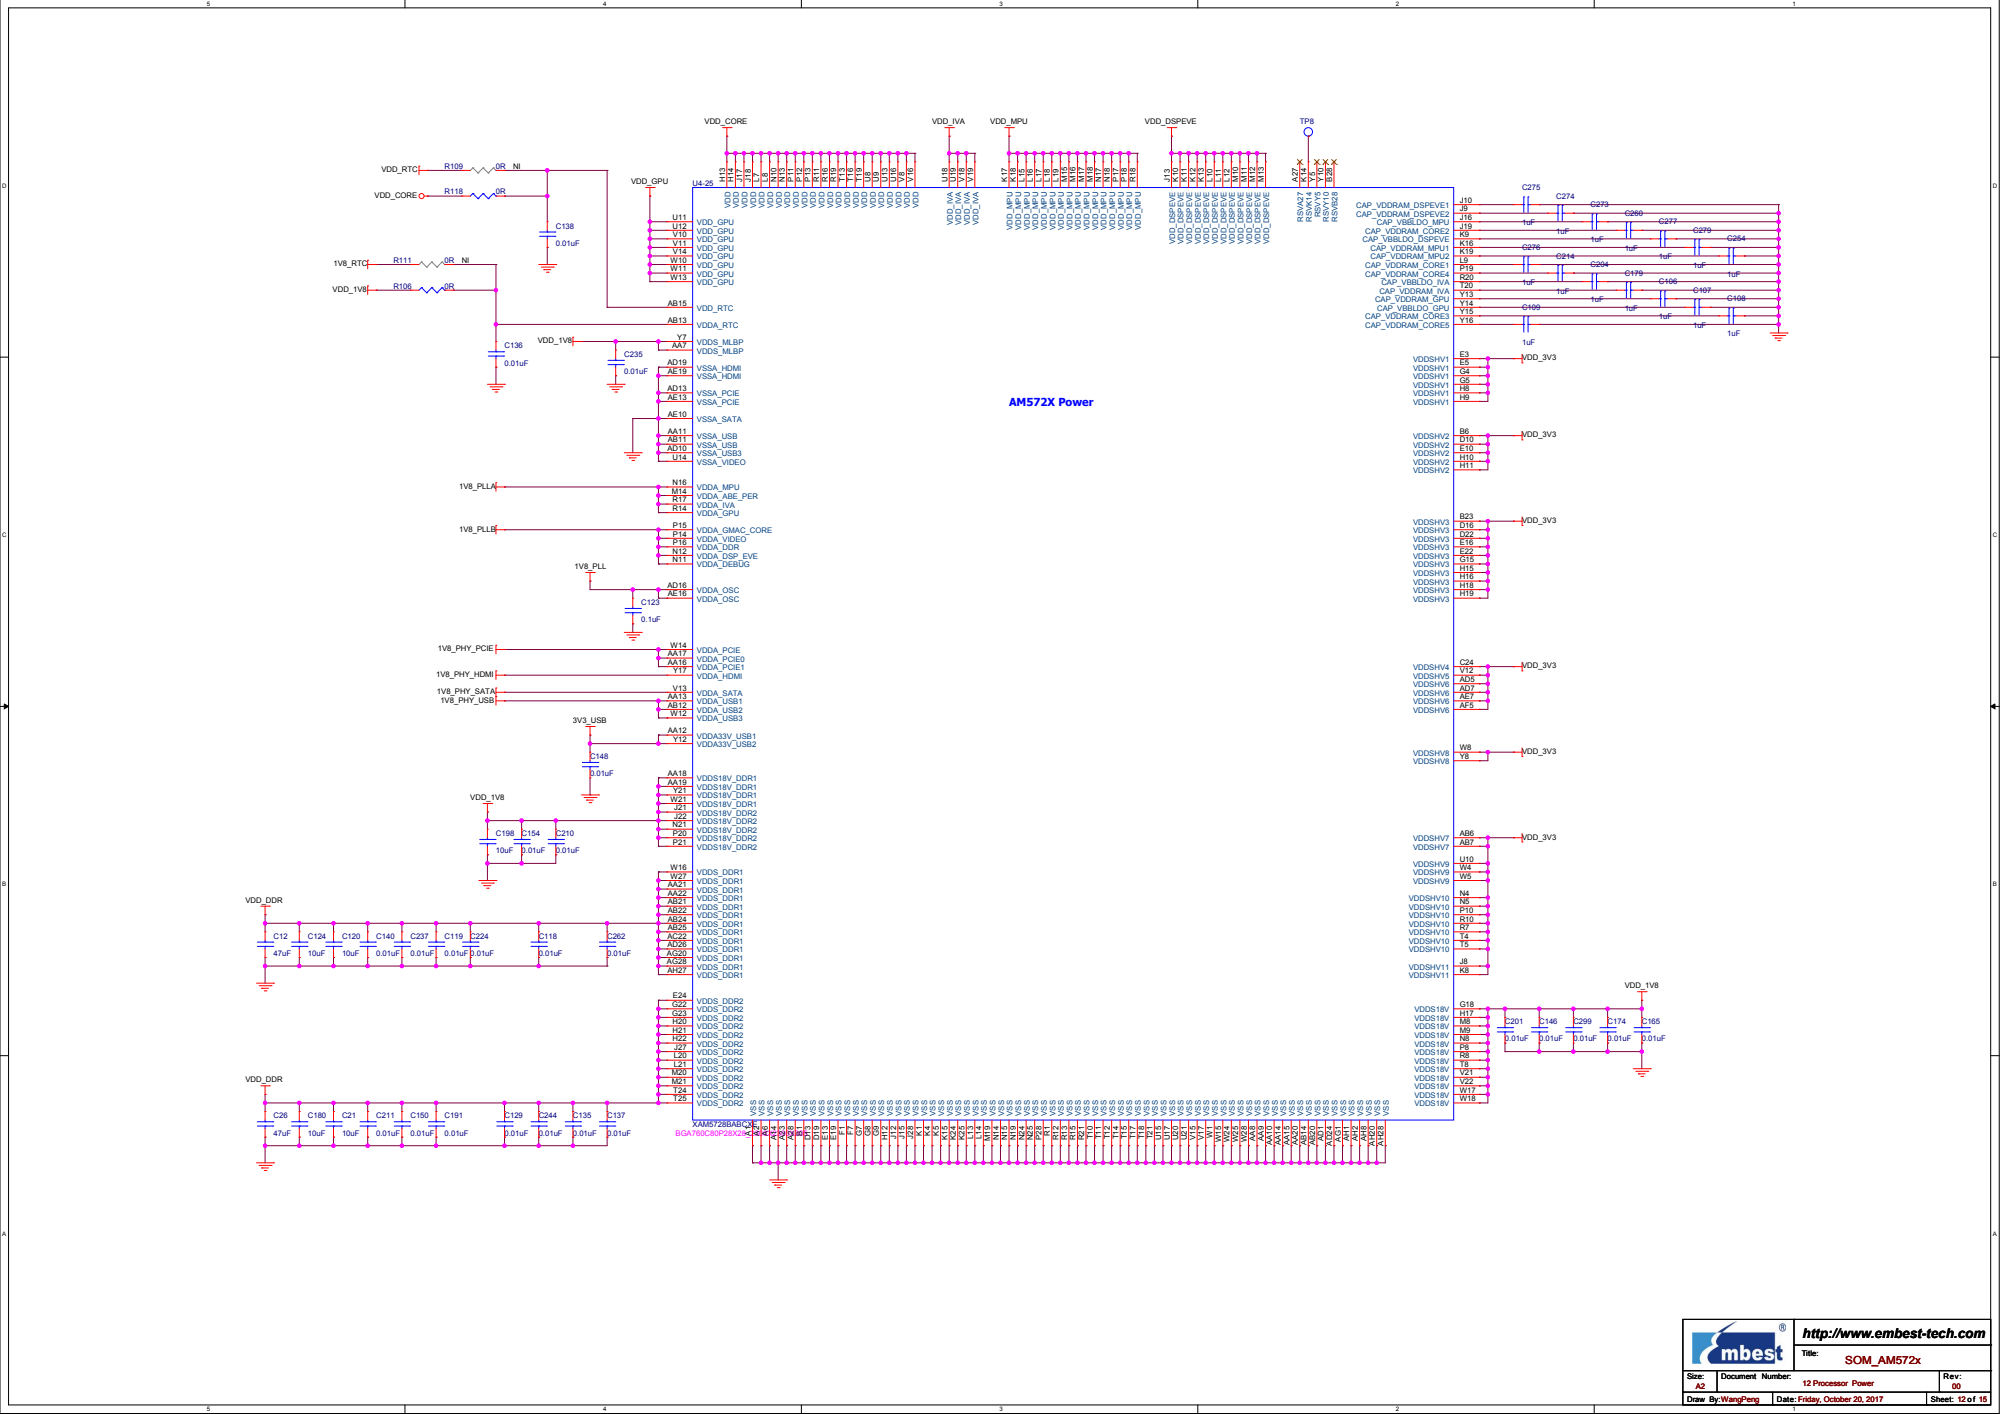
[picture p93: page 12]

http://www.embest-tech.com

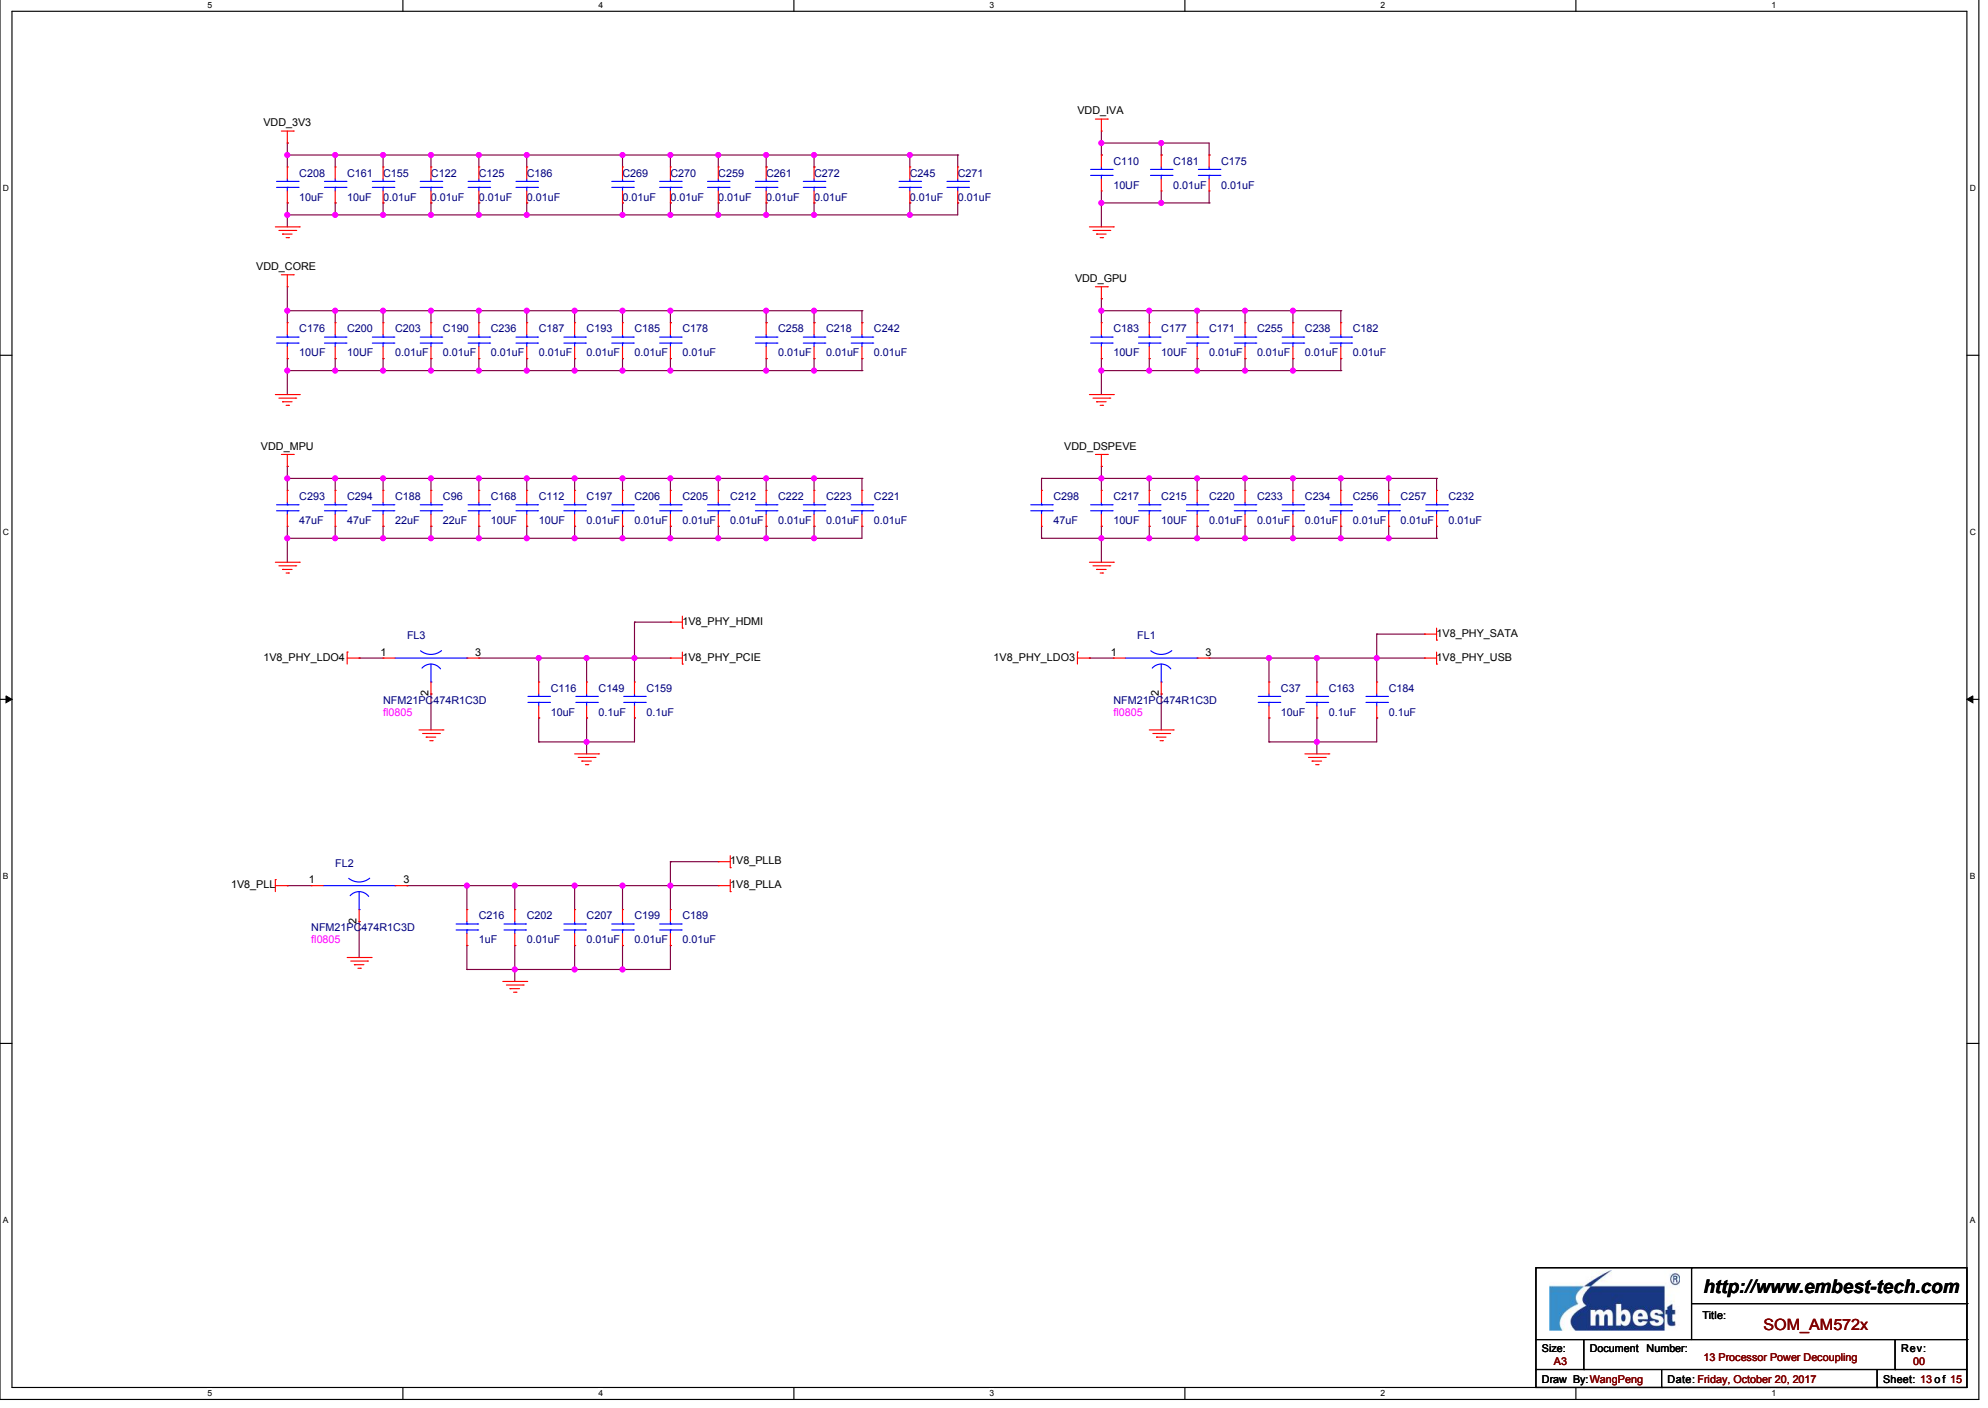
[picture p94: page 13]

http://www.embest-tech.com

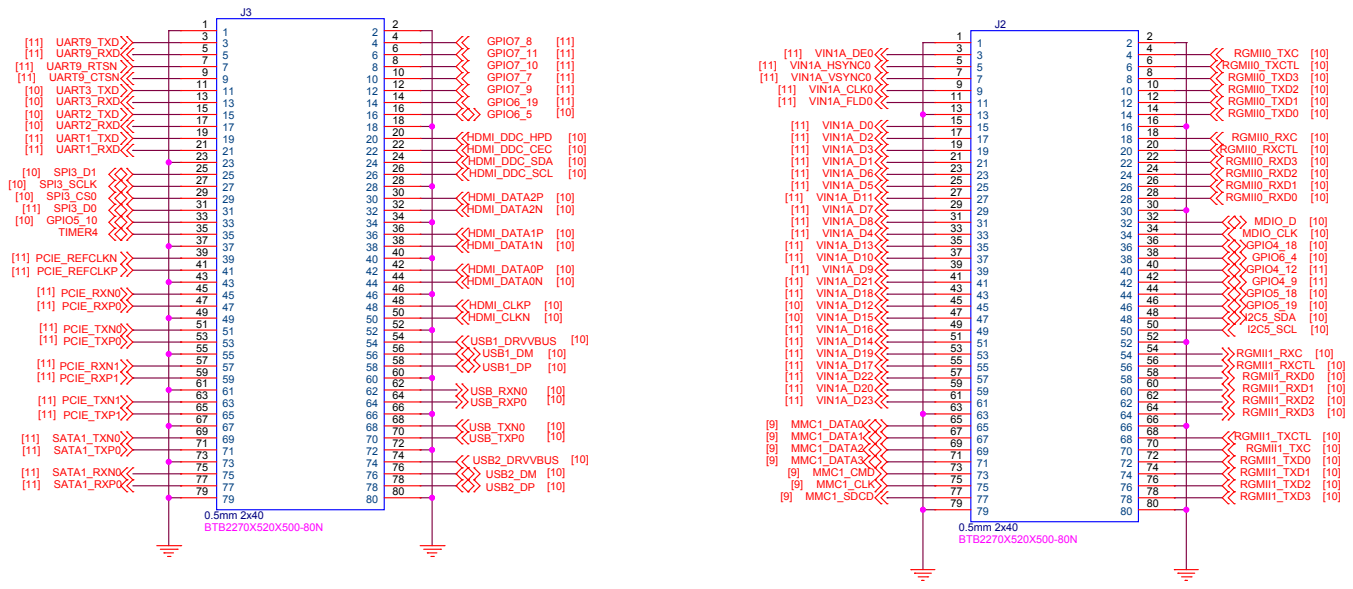
[picture p95: page 14]
RGMII0_TXC [10]; RGMII0_TXD2 [10]; RGMII0_TXD3 [10]; RGMII0_TXCTL [10]; RGMII0_TXD1 [10] RGMII0_TXD0 [10]; RGMII0_RXC; RGMII0_RXD1; RGMII0_RXCTL; RGMII0_RXD3; RGMII0_RXD2; RGMII0_RXD0; MDIO_CLK; MDIO_D; GPIO5_18; GPIO5_19; GPIO4_9; GPIO4_18; GPIO4_12; I2C5_SDA; GPIO6_4; I2C5_SCL; [11] VIN1A_D0; [11] VIN1A_D3; [11] VIN1A_D2; [11] VIN1A_D1 [11] VIN1A_D6 [11] VIN1A_D5; [11] VIN1A_D4; [11] VIN1A_D8; [11] VIN1A_D7; [11] VIN1A_D11; [11] VIN1A_D10 [11] VIN1A_D9; [11] VIN1A_D14; [11] VIN1A_D13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

http://www.embest-tech.com

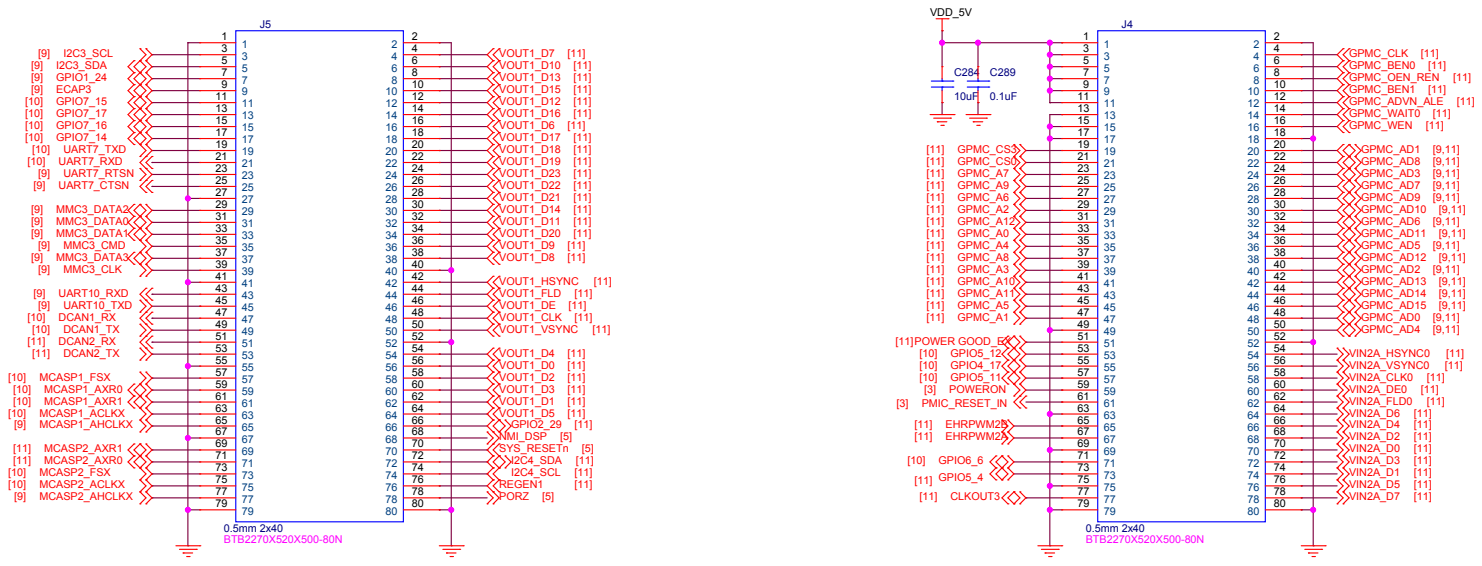
[picture p96: page 15]
VDD_5V; [10] GPIO7_14; [10] GPIO7_17 [10] GPIO7_16; [10] GPIO7_15; [9] GPIO1_24 [9] ECAP3; [10] UART7_RXD; [10] UART7_TXD; [9] UART7_RTSN; [9] I2C3_SDA; [9] UART7_CTSN; [9] I2C3_SCL; [9] MMC3_CLK; [9] MMC3_CMD; [9] MMC3_DATA0; [9] MMC3_DATA2; [9] MMC3_DATA1; [9] MMC3_DATA3; [9] UART10_TXD; [9] UART10_RXD; [10] DCAN1_TX; [10] DCAN1_RX; [11] DCAN2_RX [11] DCAN2_TX; [9] MCASP1_AHCLKX; [10] MCASP1_FSX; [10] MCASP1_AXR1 [10] MCASP1_ACLKX; [10] MCASP1_AXR0; [10] MCASP2_FSX; [9] MCASP2_AHCLKX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

http://www.embest-tech.com
