anonymouslojz/EM-TF-SOM-AM5728/04-Connector/MTBT63-6xxGxx-02A59(On Carrier Board).pdf

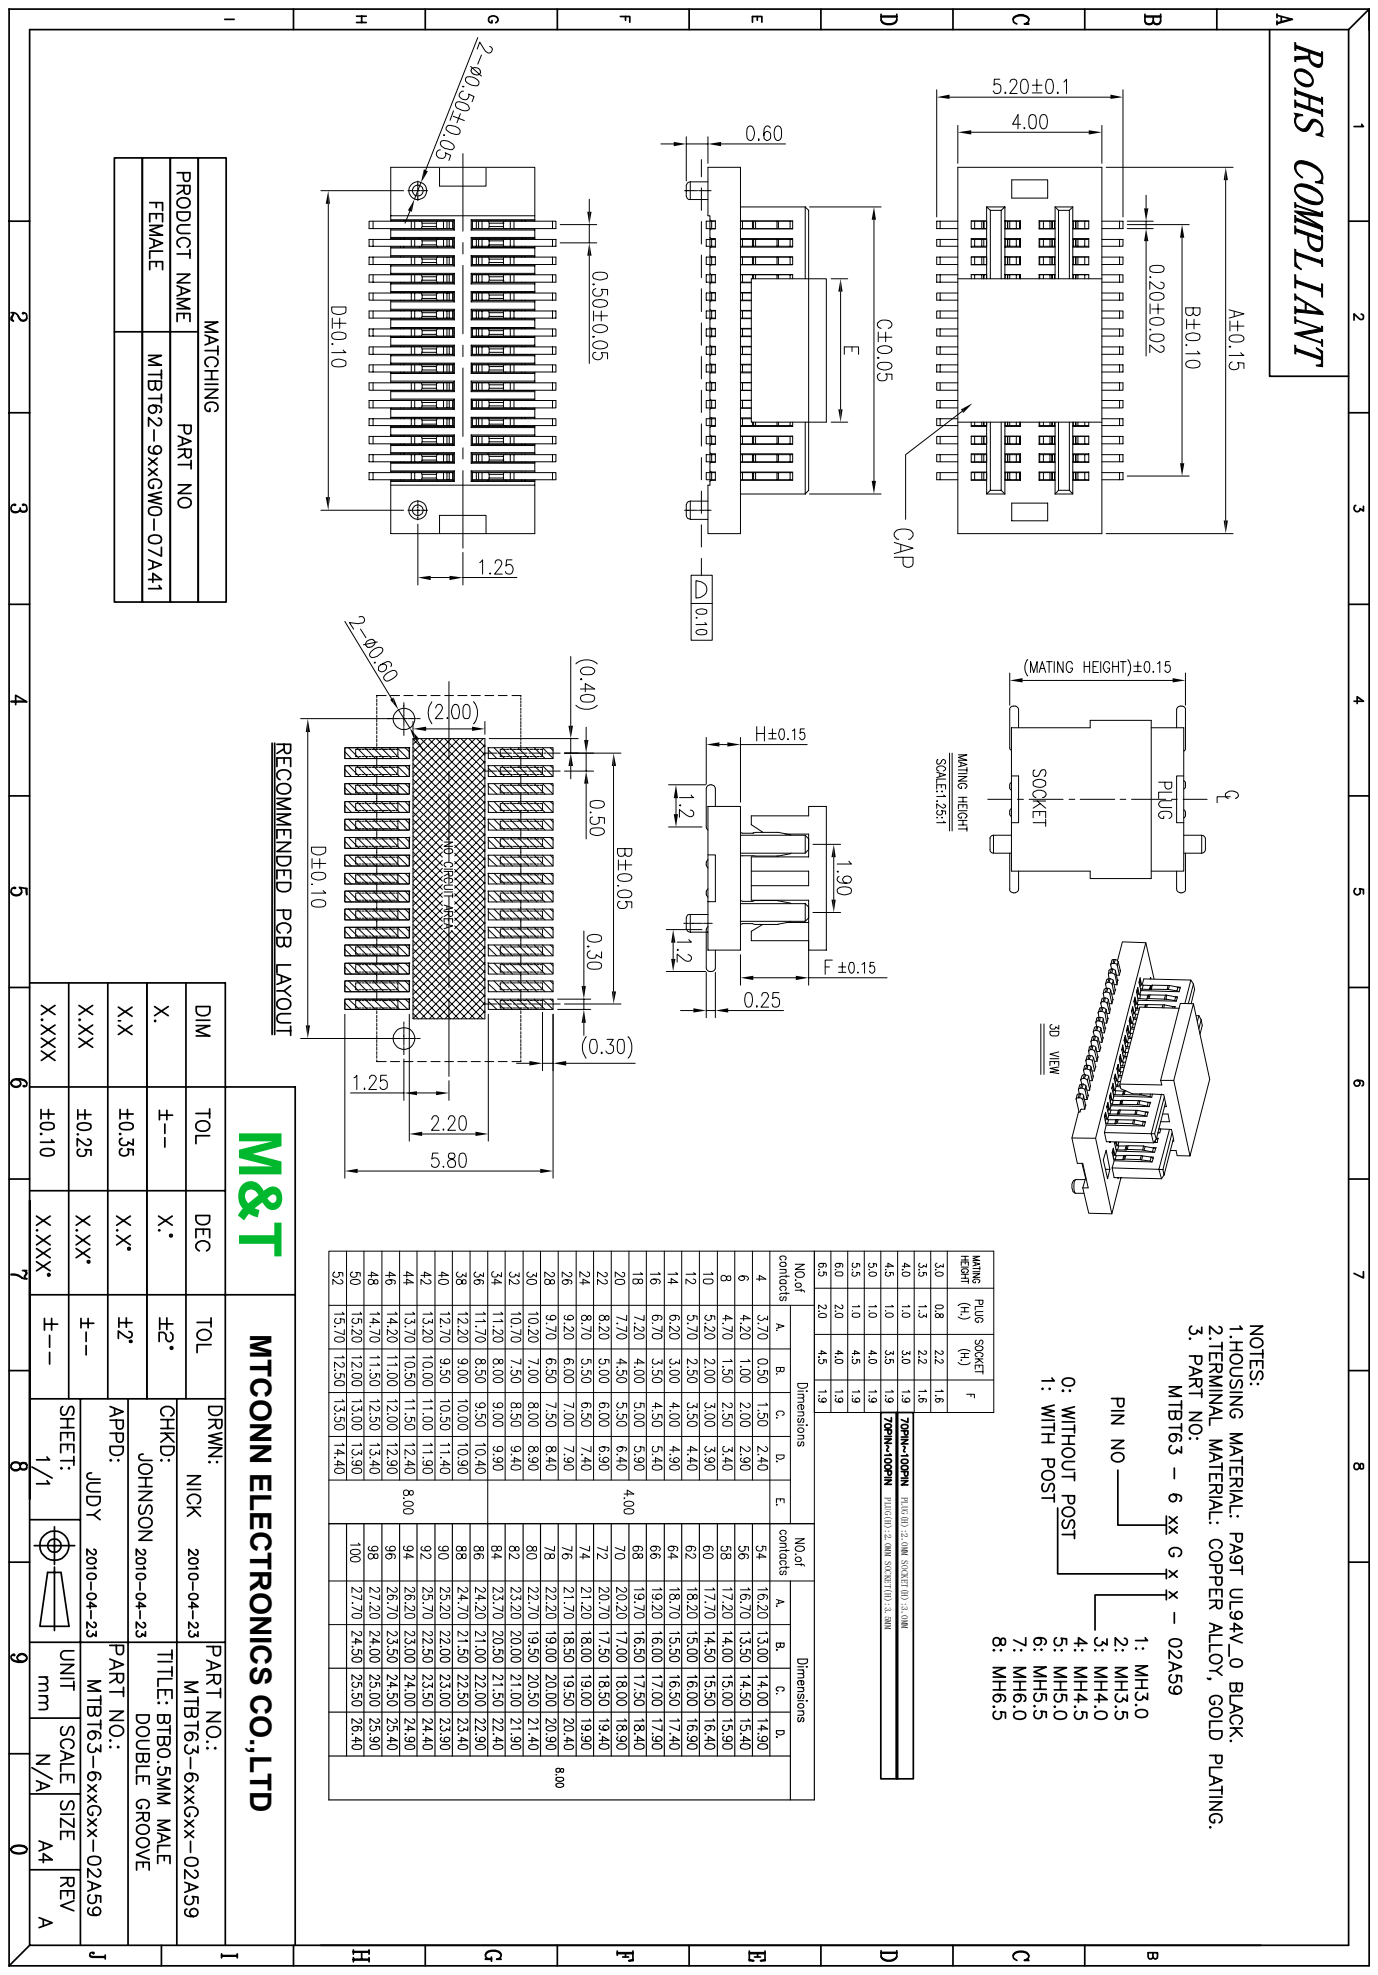
[picture p97: page 1]
RoHS COMPLIANT; PLUG(H):2.0MM SOCKET(H):3.0MM; PLUG(H):2.0MM SOCKET(H):3.5MM

MTCONN ELECTRONICS CO.,LTD M&T
